Landonowins/weisshorn-nose-cone/report/main.tex

\documentclass[12pt]{article}

% PACKAGE IMPORTS
\usepackage{fancyhdr}
\usepackage[utf8]{inputenc}
\usepackage[T1]{fontenc}
\usepackage[english]{babel}
\usepackage{graphicx}
\usepackage{blindtext}
\usepackage{titlesec}
\usepackage{csquotes}
\usepackage{enumitem}
\usepackage{amsfonts}
\usepackage[font=small,skip=0pt]{caption}
\usepackage{subcaption}
\usepackage{hyperref}
\hypersetup{hidelinks} % no red boxes around links
\usepackage{float}
\usepackage{xcolor}
\usepackage{amsmath,esint}
\usepackage{booktabs}
\usepackage{adjustbox}
\usepackage{calc}
\usepackage{colortbl}
\usepackage{array}
\usepackage{etoolbox}
\usepackage{wrapfig}
\usepackage{ragged2e}
\usepackage{textcomp, gensymb}
\usepackage{pdflscape}
\usepackage{pdfpages}
\usepackage{tikz} % Used for positioning text on title
\usepackage{geometry} % Used for adjusting the margins
\usepackage{lastpage} % Used for adding a page count to the footer
\usepackage[scaled]{helvet} % Helvetica font
\usepackage{soul} % Used for custom letter spacing on title page
\usepackage{eso-pic}
\usepackage[useregional]{datetime2}
\usepackage{longtable}
% added for this report
\usepackage{amssymb}
\usepackage{siunitx}
\sisetup{detect-all}
\usepackage{tabularx}

% SCREENSHOT PATH
\graphicspath{{pictures/template/}{figures/}{../figures/}}

\PassOptionsToPackage{x11names}{xcolor} % Used for adding colors

% FONT SETTINGS
\renewcommand\familydefault{\sfdefault} % Set default font to sans-serif

% DEFINE COLORS
\definecolor{ertred}{RGB}{226,12,24} % Rocket team's red for header and footer lines
\definecolor{issuccess}{RGB}{0,115,10}
\definecolor{isdanger}{RGB}{200,10,10}

% NUMBERS QUOTED IN THE TEXT (generated by scripts/make_tables.py)
\input{sections/macros}

% MARGINS
\geometry{
a4paper,
inner=20mm,
outer=20mm,
top=26mm,
bottom=30mm,
footskip=10mm,
headsep=13mm
}

% TITLE - INTER LETTER SPACING
\sodef\an{}{.1em}{0.1em}{0.1em} % Adjust letter spacing in the title

% FRONT PAGE BACKGROUND IMAGE
\newcommand\BackgroundPic{
\put(0,0){
\parbox[b][\paperheight]{\paperwidth}{
\vfill
\centering
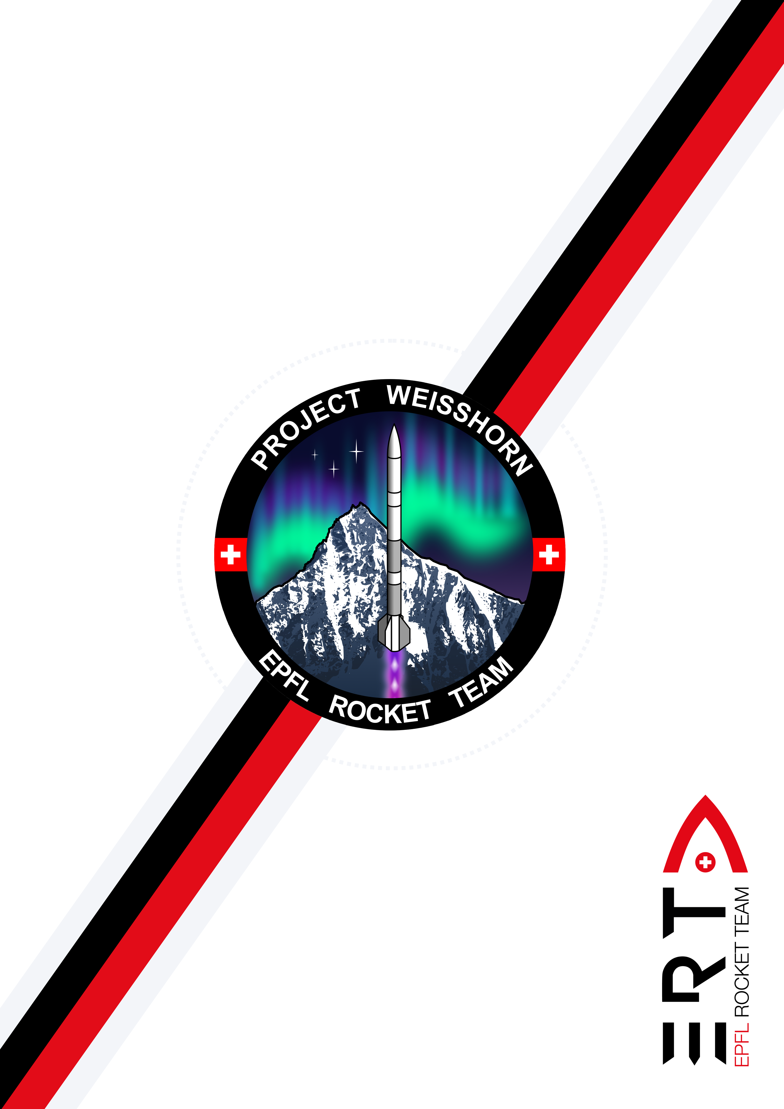
[picture p1: report/pictures/template/c_title-page.png]
 % Background title page image
\vfill
}
}
}

\begin{document}

\AddToShipoutPicture*{\BackgroundPic}
\ClearShipoutPicture

% HEADER AND FOOTER

% HEADER AND FOOTER POSITIONING
\let\oldheadrule\headrule
\renewcommand{\headrule}{\color{ertred}\oldheadrule} % Add color to headrule
\renewcommand{\headrulewidth}{1.5pt}
\renewcommand{\footrule}{\hbox to\headwidth{\color{ertred}\leaders\hrule height \footrulewidth\hfill}}
\renewcommand{\footrulewidth}{1.5pt}
\setlength\headheight{48pt}

% HEADER OPTIONS
\pagestyle{fancy}
\fancyhead[C]{\rule[-2ex]{0pt}{2ex} \bf{ \fontsize{12}{5} \selectfont 2027\_C\_FD\_REPORT-1\_NOSE-CONE}} % Header document name
\lhead{}
\lhead{\vspace{-4mm}} % ERT Logo
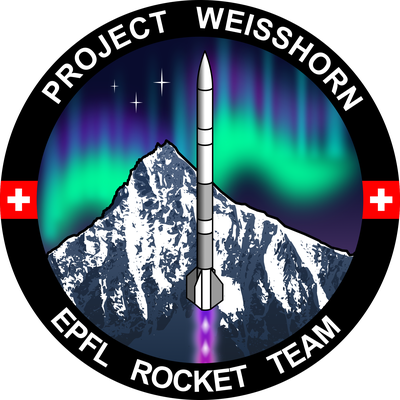
[picture p2: report/pictures/template/c_patch.png]
\rhead{\vspace{-4mm}} % Project Logo

% FOOTER OPTIONS
\cfoot{}
\fancyfoot[R]{\bf{\thepage/\pageref{LastPage}}}
\fancyfoot[L]{\rule[-2ex]{0pt}{2ex}\bf{EPFL ROCKET TEAM}} % Footer Name

% TITLE PAGE
\begin{titlepage}
\vspace*{-2.40cm} % Push title to the top of the page
\noindent
\hspace*{-1.2cm}
\parbox{\linewidth}{%
\bfseries\fontsize{34}{38}\selectfont
REPORT 1 -\\
NOSE CONE ANALYSIS\\
}
\newline
\hspace*{-1.2cm}
\parbox{\linewidth}{%
\bfseries\fontsize{14}{18}\selectfont
Fabio Feig - 315169 \\ % Names and scipers
}

% ADDITIONAL TITLE PAGE DETAILS
\begin{tikzpicture}[remember picture,overlay]
\node[anchor=south east,inner sep=39mm] at (current page.south east) {
\parbox[b][-2.37cm][t]{15cm}{
\raggedleft
\fontsize{12}{12} \selectfont \normalfont \textbf{Weisshorn -- Nose Cone Design Report}
}
};
\end{tikzpicture}

\begin{tikzpicture}[remember picture,overlay]
\node[anchor=south east,inner sep=39mm] at (current page.south east) {
\parbox[b][-0.8cm][t]{15cm}{
\raggedleft
\fontsize{12}{12} \selectfont \normalfont Date: \today % Date
}
};
\end{tikzpicture}

\begin{tikzpicture}[remember picture,overlay]
\node[anchor=south east,inner sep=39mm] at (current page.south east) {
\parbox[b][-1.6cm][t]{15cm}{
\raggedleft
\fontsize{12}{12} \selectfont \normalfont Doc ID: 2027\_C\_FD\_REPORT-1\_NOSE-CONE
}
};
\end{tikzpicture}

\end{titlepage}

% TABLE OF CONTENTS
\pagenumbering{roman} % front matter numbered i, ii so the report body starts at 1
\setcounter{tocdepth}{2} % sections and subsections only
{\small\tableofcontents}
\newpage

% PAGE NUMBERING
\pagenumbering{arabic}
\setcounter{page}{1}

% MAIN CONTENT
\input{sections/01_summary}
\input{sections/01b_nomenclature}
\input{sections/02_inputs}
\input{sections/03_options}
\input{sections/04_methods}
\input{sections/05_results}
\input{sections/05b_catalogue}
\input{sections/06_selection}
\input{sections/06b_recommendations}
\input{sections/07_definition}
\input{sections/08_next}

% APPENDICES
\appendix
\input{sections/09_appendix}

\newpage

\end{document}
