Landonowins/weisshorn-nose-cone/report_650/main.tex

\documentclass[12pt]{article}

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

% SCREENSHOT PATH
\graphicspath{{pictures/template/}{figures/}}

\PassOptionsToPackage{x11names}{xcolor} % Used for adding colors

% FONT SETTINGS
\renewcommand\familydefault{\sfdefault} % Set default font to sans-serif

% DEFINE COLORS
\definecolor{ertred}{RGB}{226,12,24} % Rocket team's red for header and footer lines
\definecolor{issuccess}{RGB}{0,115,10}
\definecolor{isdanger}{RGB}{200,10,10}

% NUMBERS QUOTED IN THE TEXT (generated by studies/total_length.py)
\input{sections/tl_macros}

% MARGINS
\geometry{
a4paper,
inner=20mm,
outer=20mm,
top=26mm,
bottom=30mm,
footskip=10mm,
headsep=13mm
}

% TITLE - INTER LETTER SPACING
\sodef\an{}{.1em}{0.1em}{0.1em} % Adjust letter spacing in the title

% FRONT PAGE BACKGROUND IMAGE
\newcommand\BackgroundPic{
\put(0,0){
\parbox[b][\paperheight]{\paperwidth}{
\vfill
\centering
 % Background title page image
\vfill
}
}
}

\begin{document}

\AddToShipoutPicture*{\BackgroundPic}
\ClearShipoutPicture

% HEADER AND FOOTER

% HEADER AND FOOTER POSITIONING
\let\oldheadrule\headrule
\renewcommand{\headrule}{\color{ertred}\oldheadrule} % Add color to headrule
\renewcommand{\headrulewidth}{1.5pt}
\renewcommand{\footrule}{\hbox to\headwidth{\color{ertred}\leaders\hrule height \footrulewidth\hfill}}
\renewcommand{\footrulewidth}{1.5pt}
\setlength\headheight{48pt}

% HEADER OPTIONS
\pagestyle{fancy}
\fancyhead[C]{\rule[-2ex]{0pt}{2ex} \bf{ \fontsize{12}{5} \selectfont 2026\_C\_FD\_REPORT-2\_NOSE\_CONE}} % Header document name
\lhead{}
\lhead{\vspace{-4mm}} % ERT Logo
\rhead{\vspace{-4mm}} % Project Logo

% FOOTER OPTIONS
\cfoot{}
\fancyfoot[R]{\bf{\thepage/\pageref{LastPage}}}
\fancyfoot[L]{\rule[-2ex]{0pt}{2ex}\bf{EPFL ROCKET TEAM}} % Footer Name

% TITLE PAGE
\begin{titlepage}
\vspace*{-2.40cm} % Push title to the top of the page
\noindent
\hspace*{-1.2cm}
\parbox{\linewidth}{%
\bfseries\fontsize{34}{38}\selectfont
REPORT 2 -\\
NOSE CONE ANALYSIS\\ FOR 650MM LENGTH\\
}
\newline
\hspace*{-1.2cm}
\parbox{\linewidth}{%
\bfseries\fontsize{14}{18}\selectfont
Fabio Feig - 315169 \\ % Names and scipers
}

% ADDITIONAL TITLE PAGE DETAILS
\begin{tikzpicture}[remember picture,overlay]
\node[anchor=south east,inner sep=39mm] at (current page.south east) {
\parbox[b][-2.37cm][t]{15cm}{
\raggedleft
\fontsize{12}{12} \selectfont \normalfont \textbf{Weisshorn -- Nose Cone at 650 mm, with and without the 3U}
}
};
\end{tikzpicture}

\begin{tikzpicture}[remember picture,overlay]
\node[anchor=south east,inner sep=39mm] at (current page.south east) {
\parbox[b][-0.8cm][t]{15cm}{
\raggedleft
\fontsize{12}{12} \selectfont \normalfont Date: \today % Date
}
};
\end{tikzpicture}

\begin{tikzpicture}[remember picture,overlay]
\node[anchor=south east,inner sep=39mm] at (current page.south east) {
\parbox[b][-1.6cm][t]{15cm}{
\raggedleft
\fontsize{12}{12} \selectfont \normalfont Doc ID: 2026\_C\_FD\_REPORT-2\_NOSE\_CONE
}
};
\end{tikzpicture}

\end{titlepage}

% TABLE OF CONTENTS
\pagenumbering{roman} % front matter numbered i, ii so the report body starts at 1
\setcounter{tocdepth}{2} % sections and subsections only
{\small\tableofcontents}
\newpage

% PAGE NUMBERING
\pagenumbering{arabic}
\setcounter{page}{1}

% MAIN CONTENT
\input{sections/01_summary}
\input{sections/02_inputs}
\input{sections/03_method}
\input{sections/04_results}
\input{sections/05_design}

\end{document}
