Landonowins/weisshorn-nose-cone/report/sections/03_options.tex

\section{Design Options}
\label{sec:options}

\subsection{Supersonic flow over a nose and wave drag}
\label{sec:physics}

Above $M = 1$ a disturbance only reaches the downstream cone of half-angle
\begin{equation}
\mu = \arcsin\frac{1}{M}
\label{eq:mach}
\end{equation}
($45.6^\circ$ at $M = 1.4$), so the flow meets the nose through a shock, then expands along it. The
overpressure on the forward-facing surface gives the \emph{wave drag}, $C_{D,\rm w} = D_{\rm w}/(q_\infty
A_b)$ with $A_b = \pi R^2$ (Equation~\eqref{eq:cdw}); it appears around $M \approx 0.8$, peaks near
$M = 1$ and is the only drag component set by the nose shape. A blunt tip detaches the shock into a bow
shock with near-stagnation pressure on the tip, so the tip radius must stay small
(Section~\ref{sec:bluntness}). Slender-body theory gives, within a profile family,
\begin{equation}
C_{D,\rm w} \propto \left(\frac{R}{L}\right)^2 \propto \frac{1}{(L/D)^2} ,
\label{eq:fineness}
\end{equation}
and the minimum-drag shapes: Von K\'arm\'an for a given length and base area, LV-Haack for a given length
and volume. The theory gives trends; the Euler runs of Section~\ref{sec:method} give the values.

\subsection{Candidate profiles}
\label{sec:profiles}

The nose is defined by the \textbf{profile}, the \textbf{fineness} $L/D$ and the \textbf{tip bluntness}
$r_n/R$. Seven profiles are compared (Table~\ref{tab:profiles}, Figure~\ref{fig:schematics}); with
$\xi = x/L$ and $\eta = y/R$: the \textbf{cone}; the \textbf{tangent ogive} (arc of radius
$\rho = (R^2+L^2)/(2R)$); the \textbf{parabola} $K' = 1$; the \textbf{power series} $\eta = \xi^n$
($n = \tfrac12$ is blunt by construction, apex radius $R^2/(2L)$; power noses meet the body with a kink
$\arctan(nR/L)$); and the \textbf{Haack series} $C = 0$ (Von K\'arm\'an) and $C = \tfrac13$ (LV-Haack),
both tangent at the shoulder. The elliptical nose and the secant ogive were discarded before computing.

\begin{figure}[tbp]
\centering

\caption{Schematics of the candidate profiles, drawn at $L/D = 2$ (half the design fineness) so
that their differences are visible; Figure~\ref{fig:gallery} shows them at real proportions.
(a) Notation. (b)--(h) Construction of each profile: the upper label describes the shoulder
(tangent to the body, or a kink of angle $\theta_{\rm sh}$), the lower label the generator and the
tip, and the inset shows the boxed tip region magnified four times.}
\label{fig:schematics}
\end{figure}

\begin{table}[H]
\centering
\caption{Candidate profiles (ogive in dimensional form, $\rho$: arc radius). $x_{cp}$: Barrowman
nose centre of pressure; $\theta_{\rm sh}$: angle to the body at the shoulder (0 = tangent).}
\label{tab:profiles}
\small
\begin{adjustbox}{max width=\textwidth}
\begin{tabular}{@{}lllcc@{}}
\toprule
Profile & $\eta(\xi)$ & ERT vehicles & $x_{cp}/L$ & $\theta_{\rm sh}$ at $L/D=4$ \\
\midrule
Conical & $\xi$ & -- & 0.667 & $7.1^\circ$ \\
Tangent ogive & $\sqrt{\rho^2-(L-x)^2}+R-\rho$, $\rho=\frac{R^2+L^2}{2R}$ & Bella Lui II, Nordend & 0.464 & $0^\circ$ \\
Parabolic ($K'=1$) & $2\xi-\xi^2$ & -- & 0.467 & $0^\circ$ \\
Power series $n=\tfrac12$ & $\xi^{1/2}$ & Wildhorn, Firehorn & 0.500 & $3.6^\circ$ \\
Power series $n=\tfrac34$ & $\xi^{3/4}$ & -- & 0.600 & $5.4^\circ$ \\
LV-Haack ($C=\tfrac13$) & $\pi^{-1/2}\sqrt{\theta-\tfrac12\sin2\theta+C\sin^3\theta}$, $\theta=\arccos(1-2\xi)$ & -- & 0.438 & $0^\circ$ \\
Von K\'arm\'an ($C=0$) & as LV-Haack with $C=0$ & -- & 0.500 & $0^\circ$ \\
\bottomrule
\end{tabular}
\end{adjustbox}
\end{table}

\subsection{Comparison criteria}
\label{sec:criteria}

\begin{itemize}[leftmargin=*,itemsep=2pt]
\item \textbf{Wave drag}: set mostly by $L/D$ and the area added near the tip.
\item \textbf{Payload}: fuller profiles reach $r = \SI{77}{mm}$ further forward; the rest of the 3U needs a
cylindrical extension, which counts against the \SI{5.4}{m} cap.
\item \textbf{Stability}: every nose has $C_{N\alpha} = 2$ at $x_{cp} = L - V/A_b$; a fuller nose moves the
CP forward and lowers the static margin $(x_{cp} - x_{cg})/D$.
\item \textbf{Manufacture}: a tangent shoulder avoids a kink at the coupler bond; every option uses a
separate machined tip.
\end{itemize}
