Landonowins/weisshorn-nose-cone/report/sections/07_definition.tex

\section{Design Definition}
\label{sec:definition}

\begin{figure}[H]
\centering

\caption{Selected nose cone to scale: Von K\'arm\'an profile, $L/D = 4.5$, \SI{4.5}{mm} spherical
tip, \SI{60}{mm} shoulder; dashed: 3U CubeSat envelope.}
\label{fig:final}
\end{figure}

\begin{table}[H]
\centering
\caption{Nose cone definition (outer mould line and performance).}
\label{tab:final}
\small
\begin{tabular}{@{}>{\raggedright\arraybackslash}p{5.4cm}>{\raggedright\arraybackslash}p{10.1cm}@{}}
\toprule
Profile & Von K\'arm\'an (Haack series, $C = 0$):
$y = \dfrac{R}{\sqrt\pi}\sqrt{\theta-\tfrac12\sin 2\theta}$, $\theta=\arccos\!\left(1-\dfrac{2x}{L}\right)$ \\
Base diameter $D = 2R$ & \SI{180}{mm} \\
Profile length $L$ (to the theoretical apex) & \FINL{} ($L/D = 4.5$) \\
Tip & sphere $r_n = \SI{4.5}{mm}$, tangent at $x = $ \FINXT{}; apex truncated by \FINTRUNC{} \\
Physical curved length (tip to shoulder) & \FINLPHYS{} \\
Shoulder & \SI{60}{mm} cylinder (coupler) \\
Angle to the body at the shoulder & $0^\circ$ (tangent) \\
Internal volume / wetted area & \FINVOL{} / \FINAREA{} \\
Nose CP (Barrowman, from the apex) & \FINXCP{}, $C_{N\alpha} = 2$ \\
3U inside the curved part & \FINTHREEU{}; the remaining \FINCYL{} of the 3U sits behind the shoulder \\
Nose wave drag $C_{D,\rm w}$ at $M = 1.2/1.4/1.6$ & \FINCDB{} / \FINCDC{} / \FINCDD{} (Euler at $L/D=4.5$, sharp apex; $+0.5$ to $+1.4\,\%$ with the tip) \\
Apogee (nominal, model) & \FINAPO{}, i.e.\ \FINDAPO{} vs.\ the LVS-length baseline; $M_{\max} = \FINMMAX$ \\
Static margin change vs.\ baseline & \FINDSM{} cal \\
\bottomrule
\end{tabular}
\end{table}

A radius tolerance of $\pm\SI{0.5}{mm}$ moves $C_{D,\rm w}$ by much less than 1\,\%; a step at the
tip/shell joint matters more (a forward-facing step acts as a small blunt face): keep it below
\SI{0.2}{mm}, and forward-facing steps at zero.

\subsection{CAD deliverables}

{\sloppy Profile coordinates (\texttt{nose\_profile\_final.csv}, 200 points, $x$ from the tip),
watertight STL solids (mm) of the seven candidates at $L/D = 4.5$, and STL and STEP solids of the final
design, \texttt{nose\_vonkarman\_LD4.5\_rn4.5mm\_FINAL.stl} and \texttt{.step}, for CAD and Fluent
(Appendix~\ref{app:scripts}).\par}
