Landonowins/weisshorn-nose-cone/report/sections/08_next.tex

\section{Open Points and Next Steps}
\label{sec:next}

\begin{enumerate}[leftmargin=*,itemsep=3pt]
\item \textbf{Fluent verification (R3).} RANS (k-$\omega$ SST) at $M = 0.95$, 1.2 and 1.47 plus the
$5^\circ$ incidence case, to replace the transonic model of Section~\ref{sec:transonic}; workflow in
2027\_C\_FD\_REPORT-4\_NOSE-CONE-FLUENT-WORKFLOW (\texttt{CFD/} of the repository).
\item \textbf{RocketPy update.} Final geometry and $C_D(M)$ in the RocketPy model; re-check apogee, the
\SI{30}{m/s} rail exit speed and the 2--4 cal static margin (2027\_C\_SE\_\allowbreak FD\_REQ\_07) once
the fins are defined.
\item \textbf{Requirements to create}: profile Von K\'arm\'an, $L = \FINL{}$ (\FINLPHYS{} physical),
coordinates from \texttt{nose\_profile\_final.csv}, radius tolerance $\pm\SI{0.5}{mm}$; nosecone bay
\FINBAY{} in the \SI{5.4}{m} budget (2027\_C\_SE\_REQ\_04); spherical tip \SI{4.5}{mm}.
\end{enumerate}
