Landonowins/weisshorn-nose-cone/report_650/sections/tab_tl_cfd.tex

\begin{tabular}{@{}llrrrrr@{}}
\toprule
Profile & $L/D$ & $M=1.1$ & $M=1.2$ & $M=1.4$ & $M=1.6$ & report-1 model at $M=1.4$ \\
\midrule
Von K\'arm\'an & 2.5 & 0.1156 & 0.1212 & 0.1190 & 0.1155 & $+$5.7\,\% \\
Von K\'arm\'an & 3.5 & 0.0680 & 0.0686 & 0.0667 & 0.0648 & $-$0.4\,\% \\
LV-Haack & 2.5 & 0.1147 & 0.1302 & 0.1356 & 0.1347 & $+$7.1\,\% \\
LV-Haack & 3.5 & 0.0714 & 0.0767 & 0.0776 & 0.0766 & $-$0.6\,\% \\
Power $\tfrac12$ & 2.5 & 0.1052 & 0.1100 & 0.1122 & 0.1119 & $+$9.8\,\% \\
Power $\tfrac12$ & 3.5 & 0.0641 & 0.0665 & 0.0677 & 0.0675 & $-$0.5\,\% \\
\bottomrule
\end{tabular}
