Landonowins/weisshorn-nose-cone/report_650/sections/tab_tl_designs.tex

\begin{tabular}{@{}llrrrrrrr@{}}
\toprule
Study & Profile & $c$ & $L$ & $L/D$ & 3U in $L$ & $p$ & Apogee & vs \SI{9}{km} \\
 & & [mm] & [mm] & & [mm] & [mm] & [m] & [m] \\
\midrule
A: 3U in the nose & Von K\'arm\'an & 155 & 495 & 2.75 & 155 & 0 & 8647 & $-$353 \\
 & \textbf{LV-Haack} & 89 & 561 & 3.12 & 222 & $-$1 & \textbf{8703} & \textbf{$-$297} \\
 & Power $\tfrac12$ & 186 & 464 & 2.58 & 124 & 0 & 8621 & $-$379 \\
\midrule
B: 3U not in the nose & \textbf{Von K\'arm\'an} & 20 & 630 & 3.50 & 197 & 93 & \textbf{8905} & \textbf{$-$95} \\
 & LV-Haack & 20 & 630 & 3.50 & 249 & 41 & 8836 & $-$164 \\
 & \textbf{Power $\tfrac12$} & 20 & 630 & 3.50 & 169 & 121 & \textbf{8911} & \textbf{$-$89} \\
\bottomrule
\end{tabular}
