Landonowins/weisshorn-nose-cone/report_650/sections/tab_tl_loads.tex

\begin{tabular}{@{}lrr@{}}
\toprule
Quantity & A: LV-Haack & B: Von K\'arm\'an \\
\midrule
Nose mass in the load case (Req\_04 limit + payload) [kg] & 5.74 & 1.75 \\
Maximum dynamic pressure $q_{\max}$ [kPa] & 130 & 132 \\
Nose drag at its maximum [N] & 389 & 291 \\
Joint compression at lift-off [N] & 344 & 105 \\
Joint compression, maximum (limit) [N] & 796 & 418 \\
\quad of which nose drag [N] & 388 & 290 \\
\quad time of the maximum [s] & 9.1 & 9.1 \\
\quad ultimate ($\times2$) vs Req\_06 (\SI{300}{N}) [N] & 1593 & 836 \\
Traction, Req\_07 rationale (20\,$g$, $\times2$) vs \SI{2000}{N} [N] & 2252 & 686 \\
Nose CP to the joint plane [mm] & 405 & 335 \\
Bending at the joint per degree at $q_{\max}$ (limit) [N\,m/$^\circ$] & 46.6 & 39.2 \\
Incidence at which Req\_12 (\SI{200}{N.m} ultimate) is reached [$^\circ$] & 2.1 & 2.5 \\
\bottomrule
\end{tabular}
