Landonowins/weisshorn-nose-cone/report_650/sections/tab_tl_thermal.tex

\begin{tabular}{@{}lrr@{}}
\toprule
Peak temperature [\si{\celsius}], nominal / envelope & A: LV-Haack & B: Von K\'arm\'an \\
\midrule
Stagnation temperature $T_0$ & 117 / 153 & 119 / 155 \\
Al 6082 tip insert & 60 / 84 & 55 / 77 \\
Shell inner face, \SI{50}{mm} from the tip & 76 / 102 & 77 / 104 \\
Shell inner face, mid-length & 71 / 96 & 72 / 97 \\
Shell inner face at the coupler (bond) & 69 / 93 & 69 / 95 \\
\bottomrule
\end{tabular}
