Landonowins/weisshorn-nose-cone/report/_backup_before_explanations/sections/06b_recommendations.tex

\section{Recommendations}
\label{sec:recommendations}

\subsection{Recommended design}

\noindent\fbox{\parbox{\dimexpr\textwidth-2\fboxsep-2\fboxrule}{%
\textbf{Von K\'arm\'an nose cone, $L = \SI{810}{mm}$ ($L/D = 4.5$), $D = \SI{180}{mm}$, tangent
\SI{60}{mm} shoulder, \SI{4.5}{mm} spherical Al 6082-T6 tip insert, CFRP $[0/45/0]_{SO}$ shell
(\SI{1.2}{mm}).}\\[3pt]
Predicted: $C_{D,\rm w} = \FINCDC$ at $M = 1.4$ (lowest of seven profiles at every computed Mach
number); \FINDAPO{} of apogee against the LVS-length baseline; \FINMASS{} for shell and tip;
\FINTHREEU{} of the 3U inside the curved part; tip below \TIPAL{} and shell inner face below
\SHELLENV{} on a \SI{30}{\celsius} day.}}

\subsection{Numbered recommendations}

\begin{table}[H]
\centering
\caption{Recommendations, owners and timing.}
\label{tab:reco}
\small
\begin{tabular}{@{}>{\raggedright\arraybackslash}p{0.8cm}>{\raggedright\arraybackslash}p{10.6cm}>{\raggedright\arraybackslash}p{2.2cm}>{\raggedright\arraybackslash}p{1.6cm}@{}}
\toprule
\# & Recommendation & Owner & When \\
\midrule
R1 & Adopt the Von K\'arm\'an profile (Haack $C=0$). Use \texttt{nose\_profile\_final.csv} or the STL
in \texttt{results/cad/} as the master geometry. & FD $\rightarrow$ ST & PDR \\
R2 & Book a \SI{907}{mm} nose bay (\SI{810}{mm} curved + \SI{97}{mm} cylinder for the 3U, of which
\SI{60}{mm} is the coupler shoulder) in the \SI{5.4}{m} LV budget. If it does not fit, keep the same
profile at $L = \SI{720}{mm}$ ($-\SI{60}{m}$, bay \SI{845}{mm}). & SE & PDR \\
R3 & Use a machined Al 6082-T6 tip insert ($r_n = \SI{4.5}{mm}$, $\sim$\SI{80}{mm} long,
$\sim$\SI{60}{g}), threaded onto a ring bonded inside the shell. Do not fly a printed PET-CF tip:
it would exceed its heat-deflection range by \SIrange{25}{70}{\celsius}. & ST & CDR \\
R4 & Lay up the shell in CFRP prepreg $[0/45/0]_{SO}$, \SI{1.2}{mm}, on a male PET-CF mould printed
in 2--3 segments, with the joints in the aft half (low curvature). Use GFRP instead if the nose
has to be the RF window. & ST (AV, PL) & CDR \\
R5 & Raise the thermal requirement to \SI{430}{K} for \SI{10}{s} and qualify the shoulder bond: the
DP490 joint at the shoulder sees about \SI{95}{\celsius} in the envelope case. Consider a higher-$T_g$ adhesive if
the test margin is small. & SE, ST & CDR \\
R6 & Verify with Fluent (RANS, k-$\omega$ SST) at $M = 0.95$, 1.2 and 1.47 for the selected nose and
the power-$\tfrac12$ alternative, plus one $5^\circ$ incidence case for $C_{N\alpha}$ and CP. This
replaces the transonic model of this report. & FD-CFD & before CDR \\
R7 & Put the final geometry and $C_{D,\rm w}(M)$ into the RocketPy model. Re-check apogee, rail-exit
speed and the 2--4 cal static margin once the fins are designed. The nose contributes
$C_{N\alpha} = 2$ at \FINXCP{} from the tip. & FD-Sim & PDR \\
R8 & Size the payload structure around a 3U envelope whose front face is \FINTHREEU{} ahead of the
shoulder, inside the $r \leq \SI{77}{mm}$ contour (Figure~\ref{fig:final}). & PL, ST & CDR \\
R9 & Create the missing Weisshorn nosecone requirements: geometry, bay length, mass
($\leq\SI{500}{g}$ for the nose structure, Table~\ref{tab:mass}), thermal and tip
(Section~\ref{sec:next}). & SE & PDR \\
R10 & Keep the Firehorn power-$\tfrac12$ profile as the documented alternative. It costs
\SI{22}{m} of apogee and adds a $3.2^\circ$ shoulder kink, but its tooling and process already exist. & FD & -- \\
\bottomrule
\end{tabular}
\end{table}

\subsection{When to choose another design}

The recommendation assumes the current Weisshorn priorities: apogee margin, a 3U payload in the
nose bay, and a length cap. If those priorities change, Table~\ref{tab:alternatives} gives the
design to use instead.

\begin{table}[H]
\centering
\caption{Choice of nose cone if the priorities change.}
\label{tab:alternatives}
\small
\begin{tabular}{@{}>{\raggedright\arraybackslash}p{6.3cm}>{\raggedright\arraybackslash}p{3.6cm}>{\raggedright\arraybackslash}p{5.3cm}@{}}
\toprule
If \dots & choose & cost relative to the recommendation \\
\midrule
the LV cannot grow beyond the LVS length & Von K\'arm\'an, \SI{720}{mm} & $-\SI{60}{m}$ apogee \\
schedule favours reusing Firehorn tooling & Power $\tfrac12$, \SI{810}{mm} & $-\SI{22}{m}$, $3.2^\circ$ kink, bay $+\SI{36}{mm}$ \\
the payload grows (more volume in the nose) & LV-Haack, \SI{810}{mm} & $-\SI{69}{m}$, bay $-\SI{37}{mm}$, $+\SI{22}{g}$ \\
the nose must be as short as possible ($L/D \leq 3.5$) & Power $\tfrac12$ & lowest drag at short length \\
the vehicle becomes faster ($M_{\max} \approx 2$) and the payload leaves the nose & Power $\tfrac34$ or Von K\'arm\'an at $L/D \geq 5$ & re-run the study \\
a subsonic test vehicle (e.g.\ Aletsch) & Tangent ogive or Von K\'arm\'an & shape barely matters below $M = 0.8$ \\
\bottomrule
\end{tabular}
\end{table}

\subsection{What not to do}

\begin{itemize}[leftmargin=*,itemsep=2pt]
\item \textbf{Do not use a cone or a tangent ogive} for a supersonic Weisshorn. They lose
\SIrange{79}{132}{m} at the same length, and both this study and the literature rate them worst in
the transonic and low supersonic range.
\item \textbf{Do not use a printed thermoplastic tip.} Its surface follows the stagnation temperature,
which reaches \SI{156}{\celsius} on a hot day.
\item \textbf{Do not size the nose by fineness alone.} A longer nose pays only if the extra length
also houses payload. Measure it as nose-bay length, which is what the \SI{5.4}{m} cap actually
constrains.
\end{itemize}
