Landonowins/weisshorn-nose-cone/report/_backup_before_explanations/sections/tab_matrix.tex

\begin{table}[H]
\centering
\caption{Trade-off matrix at $L/D = 4.5$ (1 = worst, 5 = best). Performance: apogee at equal length (Table~\ref{tab:trade}). Integration: 3U length inside the curved part. Manufacture: tangent shoulder, mould and tip. Heritage: flown or built at ERT. Stability: change in static margin.}
\label{tab:matrix}
\small
\begin{adjustbox}{max width=\textwidth}
\begin{tabular}{@{}lccccccc@{}}
\toprule
Criterion (weight) & Cone & Ogive & Parab. & Power $\tfrac12$ & Power $\tfrac34$ & LV-Haack & Von K\'arm\'an \\
\midrule
Performance (0.40) & 1.0 & 2.6 & 2.6 & 4.3 & 4.4 & 2.9 & 5.0 \\
Integration, 3U fit (0.20) & 1.0 & 4.8 & 4.8 & 3.0 & 1.7 & 5.0 & 3.7 \\
Manufacture (0.20) & 3.0 & 5.0 & 5.0 & 3.0 & 2.0 & 5.0 & 5.0 \\
Heritage (0.10) & 1.0 & 4.0 & 2.0 & 5.0 & 1.0 & 1.0 & 2.0 \\
Stability (0.10) & 5.0 & 1.4 & 1.5 & 2.2 & 3.9 & 1.0 & 2.1 \\
\midrule
\textbf{Weighted total} & 1.80 & 3.54 & 3.36 & 3.64 & 3.00 & 3.37 & \textbf{4.15} \\
\bottomrule
\end{tabular}
\end{adjustbox}
\end{table}
