Landonowins/weisshorn-nose-cone/report/_backup_before_explanations/sections/tab_trade.tex

\begin{table}[H]
\centering
\caption{Candidates at $L/D=4$ (LVS length, \SI{720}{mm}) and $L/D=4.5$ (\SI{810}{mm}). $\Delta z$: apogee change vs.\ the baseline (Von K\'arm\'an, $L/D=4$); mass: shell + Al tip; 3U in nose: curved length with $r\geq\SI{77}{mm}$; bay: curved length plus the cylinder the 3U still needs.}
\label{tab:trade}
\small
\begin{adjustbox}{max width=\textwidth}
\begin{tabular}{@{}llcccccccc@{}}
\toprule
$L/D$ & Profile & \multicolumn{3}{c}{$C_{D,\rm w}$ at $M=$} & $\Delta z$ & mass & 3U in nose & bay & $\Delta$SM \\
 & & 1.1 & 1.2 & 1.4 & [m] & [g] & [mm] & [mm] & [cal] \\
\midrule
4 & Cone & 0.0982 & 0.0862 & 0.0750 & -195 & 261 & 104 & 966 & +0.11 \\
4 & Tangent ogive & 0.0651 & 0.0657 & 0.0640 & -93 & 328 & 275 & 795 & -0.03 \\
4 & Parabolic & 0.0656 & 0.0656 & 0.0639 & -92 & 328 & 274 & 797 & -0.03 \\
4 & Power $n=\tfrac12$ & 0.0523 & 0.0541 & 0.0550 & -8 & 328 & 193 & 878 & +0.00 \\
4 & Power $n=\tfrac34$ & 0.0628 & 0.0628 & 0.0564 & -26 & 289 & 135 & 935 & +0.07 \\
4 & LV-Haack & 0.0610 & 0.0610 & 0.0613 & -75 & 341 & 284 & 786 & -0.04 \\
4 & \textbf{Von K\'arm\'an} & 0.0541 & 0.0541 & 0.0526 & +0 & 321 & 226 & 845 & +0.00 \\
\midrule
4.5 & Cone & 0.0708 & 0.0708 & 0.0619 & -72 & 286 & 117 & 1043 & +0.09 \\
4.5 & Tangent ogive & 0.0530 & 0.0530 & 0.0516 & -19 & 361 & 309 & 870 & -0.07 \\
4.5 & Parabolic & 0.0529 & 0.0529 & 0.0515 & -18 & 361 & 308 & 870 & -0.06 \\
4.5 & Power $n=\tfrac12$ & 0.0450 & 0.0450 & 0.0457 & +38 & 361 & 217 & 943 & -0.03 \\
4.5 & Power $n=\tfrac34$ & 0.0513 & 0.0513 & 0.0463 & +42 & 318 & 152 & 1008 & +0.04 \\
4.5 & LV-Haack & 0.0496 & 0.0496 & 0.0497 & -9 & 376 & 320 & 870 & -0.08 \\
4.5 & \textbf{Von K\'arm\'an} & 0.0437 & 0.0437 & 0.0425 & +60 & 354 & 254 & 907 & -0.04 \\
\bottomrule
\end{tabular}
\end{adjustbox}
\end{table}
