Landonowins/weisshorn-nose-cone/CFD/source/main.tex

\documentclass[11pt]{article}

% PACKAGE IMPORTS
\usepackage{fancyhdr}
\usepackage[utf8]{inputenc}
\usepackage[T1]{fontenc}
\usepackage[english]{babel}
\usepackage{graphicx}
\usepackage{enumitem}
\usepackage{xcolor}
\usepackage{amsmath,amssymb}
\usepackage{booktabs}
\usepackage{tabularx}
\usepackage{array}
\usepackage{float}
\usepackage[font=small,skip=4pt]{caption}
\usepackage{subcaption}
\usepackage{geometry}
\usepackage{lastpage}
\usepackage[scaled]{helvet}
\usepackage{siunitx}
\sisetup{detect-all}
\PassOptionsToPackage{obeyspaces,spaces}{url}
\usepackage{hyperref}
\hypersetup{hidelinks}
\usepackage{url}
\usepackage{tikz} % Used for positioning text on title
\usepackage{eso-pic}
\usepackage[useregional]{datetime2}

% FIGURES: generated plots and screenshots in figures/, Fluent pictures of the runs in ../studyA/plots/
\graphicspath{{pictures/template/}{figures/}{../studyA/plots/}}

% FONT SETTINGS
\renewcommand\familydefault{\sfdefault}

% COLORS
\definecolor{ertred}{RGB}{226,12,24}

% MARGINS
\geometry{
a4paper,
inner=20mm,
outer=20mm,
top=26mm,
bottom=30mm,
footskip=10mm,
headsep=13mm
}

% LISTS, PATHS AND GUI NAMES
\setlength{\emergencystretch}{2em} % long paths and GUI names: stretch spaces rather than overflow
\setlist{itemsep=2pt,topsep=3pt}
\setlist[enumerate,1]{leftmargin=*}
\setlist[itemize]{leftmargin=*}
\urlstyle{tt}
\newcommand{\file}[1]{\path{#1}}
\newcommand{\zone}[1]{\texttt{#1}}              % Fluent zone / named selection
\newcommand{\gui}[1]{\textbf{#1}}               % menu, panel or field of the Ansys GUI
\newcommand{\then}{\,$\rightarrow$\,}           % menu path separator
\newcommand{\checkstep}[1]{\par\smallskip\noindent\textbf{Check.} #1\par\smallskip}

% PICTURE STILL TO COME FROM THE ANSYS SESSION: shown if figures/<name>.png exists, else a placeholder box
\newcommand{\shot}[3][\linewidth]{%
\IfFileExists{figures/#2.png}{}{%
\fbox{\parbox[c][3cm][c]{\dimexpr#1-2\fboxsep-2\fboxrule\relax}{\centering\small
\texttt{\detokenize{#2}.png} to come\\[2pt] #3}}}}

% FRONT PAGE BACKGROUND IMAGE
\newcommand\BackgroundPic{
\put(0,0){
\parbox[b][\paperheight]{\paperwidth}{
\vfill
\centering
 % Background title page image
\vfill
}
}
}

\begin{document}

\AddToShipoutPicture*{\BackgroundPic}
\ClearShipoutPicture

% HEADER AND FOOTER
\let\oldheadrule\headrule
\renewcommand{\headrule}{\color{ertred}\oldheadrule}
\renewcommand{\headrulewidth}{1.5pt}
\renewcommand{\footrule}{\hbox to\headwidth{\color{ertred}\leaders\hrule height \footrulewidth\hfill}}
\renewcommand{\footrulewidth}{1.5pt}
\setlength\headheight{48pt}

\pagestyle{fancy}
\fancyhead[C]{\rule[-2ex]{0pt}{2ex} \bf{\fontsize{12}{5}\selectfont 2027\_C\_FD\_REPORT-4\_NOSE-CONE-FLUENT-WORKFLOW}}
\lhead{\vspace{-4mm}}
\rhead{\vspace{-4mm}}
\cfoot{}
\fancyfoot[R]{\bf{\thepage/\pageref{LastPage}}}
\fancyfoot[L]{\rule[-2ex]{0pt}{2ex}\bf{EPFL ROCKET TEAM}}

% TITLE PAGE
\begin{titlepage}
\vspace*{-2.40cm} % Push title to the top of the page
\noindent
\hspace*{-1.2cm}
\parbox{\linewidth}{%
\bfseries\fontsize{34}{38}\selectfont
REPORT 4 -\\
NOSE CONE CFD\\
IN ANSYS FLUENT\\
}
\newline
\hspace*{-1.2cm}
\parbox{\linewidth}{%
\bfseries\fontsize{14}{18}\selectfont
Fabio Feig - 315169 \\ % Names and scipers
}

% ADDITIONAL TITLE PAGE DETAILS
\begin{tikzpicture}[remember picture,overlay]
\node[anchor=south east,inner sep=39mm] at (current page.south east) {
\parbox[b][-2.37cm][t]{15cm}{
\raggedleft
\fontsize{12}{12} \selectfont \normalfont \textbf{Weisshorn -- Nose Cone CFD: Workflow and Study A}
}
};
\end{tikzpicture}

\begin{tikzpicture}[remember picture,overlay]
\node[anchor=south east,inner sep=39mm] at (current page.south east) {
\parbox[b][-1.6cm][t]{15cm}{
\raggedleft
\fontsize{12}{12} \selectfont \normalfont Doc ID: 2027\_C\_FD\_REPORT-4\_NOSE-CONE-FLUENT-WORKFLOW
}
};
\end{tikzpicture}

\begin{tikzpicture}[remember picture,overlay]
\node[anchor=south east,inner sep=39mm] at (current page.south east) {
\parbox[b][-0.8cm][t]{15cm}{
\raggedleft
\fontsize{12}{12} \selectfont \normalfont Date: \today % Date
}
};
\end{tikzpicture}

\end{titlepage}

% TABLE OF CONTENTS
\pagenumbering{roman} % front matter numbered i, ii so the report body starts at 1
\setcounter{tocdepth}{2} % sections and subsections only
{\small\tableofcontents}
\newpage

% PAGE NUMBERING
\pagenumbering{arabic}
\setcounter{page}{1}

% MAIN CONTENT
\input{sections/01_summary}
\input{sections/02_case}
\input{sections/03_geometry}
\input{sections/04_mesh}
\input{sections/05_physics}
\input{sections/06_solver}
\input{sections/07_runs}
\input{sections/08_results}
\input{sections/09_python}
\input{sections/10_conclusions}

\clearpage
\appendix
\input{sections/B_files}
\input{sections/C_claude_vm}

\end{document}
