Landonowins/weisshorn-nose-cone/report_650/figures/fig_tl_total.pdf

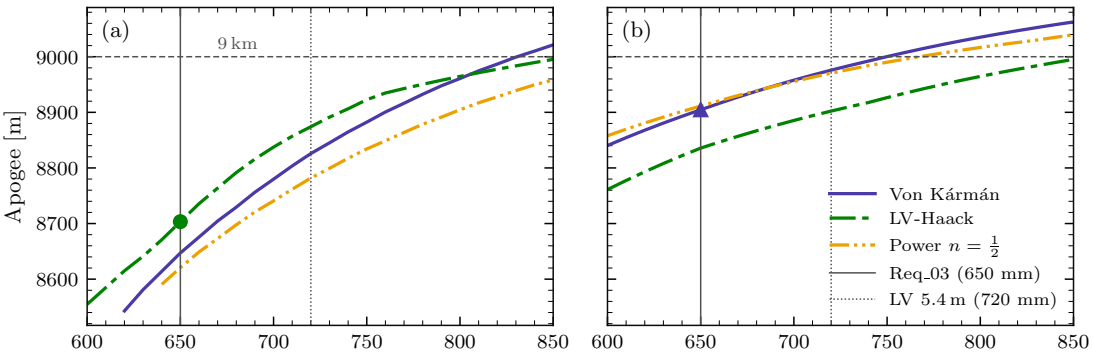
[picture p46: figure]
Apogee [m]; Von K´arm´an LV-Haack Power n = 1 2 Req 03 (650 mm) LV 5.4 m (720 mm)

Total nose length L + c [mm]

Study A: 3U in the nose

Total nose length L + c [mm]

Study B: 3U not in the nose
