Landonowins/weisshorn-nose-cone/report/figures/fig_gallery.pdf

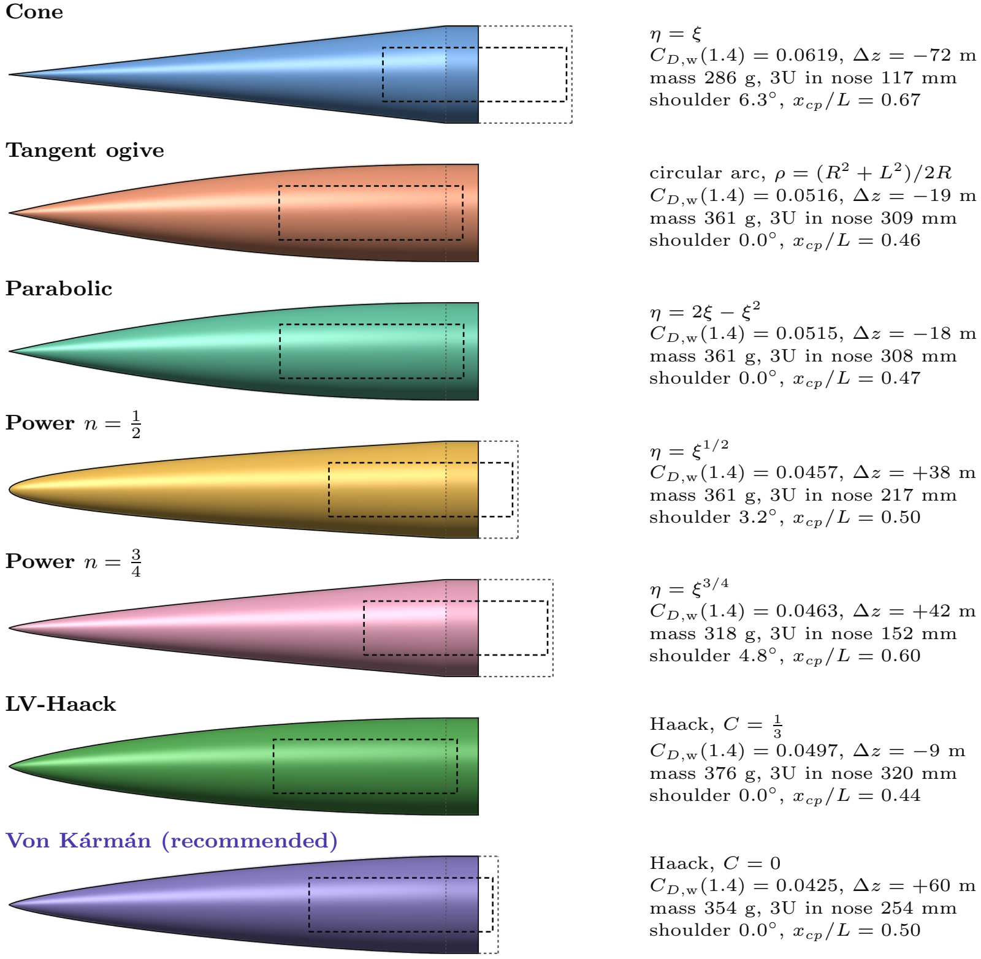
[picture p47: page 1]

Cone
η

=

ξ

CD,

w(1

.4) = 0

.0619, ∆

z

=

−72 m
mass 286 g, 3U in nose 117 mm shoulder 6

3

◦
,

xcp/L = 0

.67

Tangent ogive
circular arc,

ρ = (

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
.4) = 0

.0516, ∆

z

=

−19 m
mass 361 g, 3U in nose 309 mm shoulder 0

0

◦
,

xcp/L = 0

.46

Parabolic
η = 2

ξ

−
ξ

2

CD,

w(1

.4) = 0

.0515, ∆

z

=

−18 m
mass 361 g, 3U in nose 308 mm shoulder 0

0

◦
,

xcp/L = 0

.47

Power

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
.4) = 0

.0457, ∆

z = +38 m
mass 361 g, 3U in nose 217 mm shoulder 3

2

◦
,

xcp/L = 0

.50

Power

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
.4) = 0

.0463, ∆

z = +42 m
mass 318 g, 3U in nose 152 mm shoulder 4

8

◦
,

xcp/L = 0

.60

LV-Haack
Haack,

C

=

13

CD,

w(1

.4) = 0

.0497, ∆

z

=

−9 m
mass 376 g, 3U in nose 320 mm shoulder 0

0

◦
,

xcp/L = 0

.44

Von K´arm´an (recommended) Haack,

C = 0

CD,

w(1

.4) = 0

.0425, ∆

z = +60 m
mass 354 g, 3U in nose 254 mm shoulder 0

0

◦
,

xcp/L = 0

.50
