Landonowins/weisshorn-nose-cone/report/figures/fig_schematics.pdf

### (a) Notation

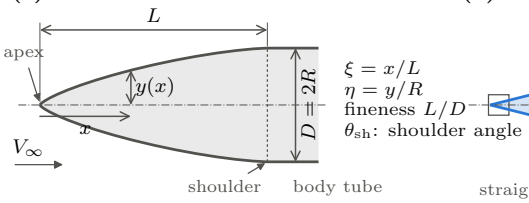
[picture p48: figure]
apex; shoulder; body tube; ξ = x/L η = y/R fineness L/D θsh: shoulder angle
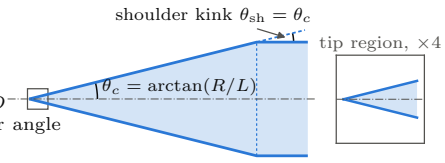
[picture p49: figure]
θc = arctan(R/L); shoulder kink θsh = θc; tip region, ×4

straight generator, sharp tip; simplest mould

### (b) Conical: η = ξ

tangent to the body at the shoulder

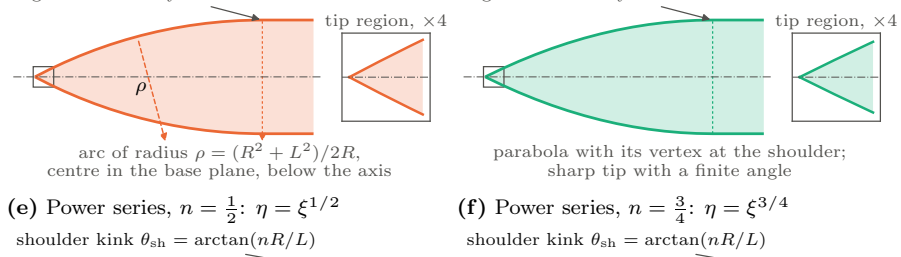
[picture p50: figure]
arc of radius ρ = (R; tip region, ×4; sharp tip with a finite angle; shoulder kink θsh = arctan(nR/L); (e) Power series, n = 1 2; (f) Power series, n = 3 4

centre in the base plane, below the axis

### (c) Tangent ogive: circular arc

tangent to the body at the shoulder

parabola with its vertex at the shoulder;

### (d) Parabolic (K0 = 1): η = 2ξ − ξ

2

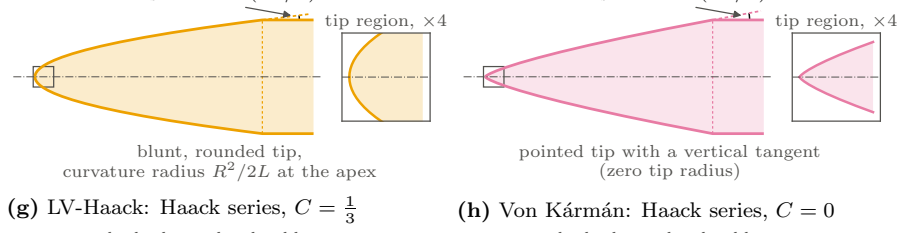
[picture p51: figure]
blunt, rounded tip, curvature radius R; 2/2L at the apex; tip region, ×4; pointed tip with a vertical tangent (zero tip radius); (g) LV-Haack: Haack series, C = 1 3; (h) Von K´arm´an: Haack series, C = 0

tangent to the body at the shoulder

least wave drag for given L and volume; the fullest of the seven shapes tangent to the body at the shoulder

least wave drag for given L and base area; pointed tip with a vertical tangent
