Landonowins/weisshorn-nose-cone/report/figures/fig_trajectory.pdf

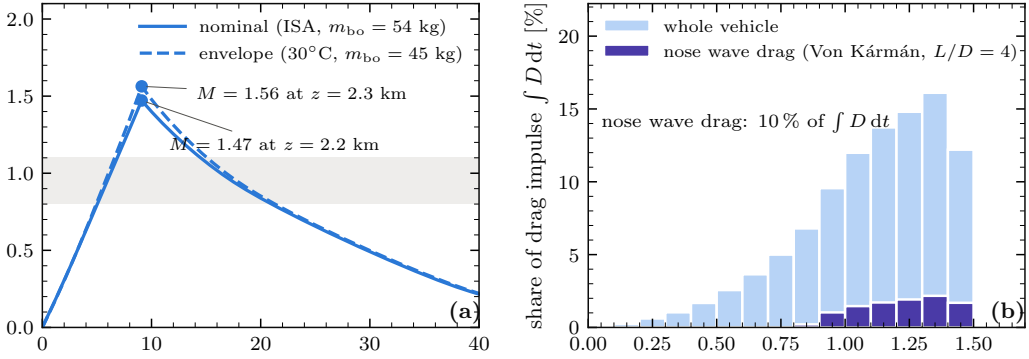
[picture p52: figure]
nominal (ISA, mbo = 54 kg) envelope (30◦C, mbo = 45 kg); share of drag impulse; nose wave drag: 10 % of R; whole vehicle nose wave drag (Von K´arm´an, L/D = 4)

t [s]

M

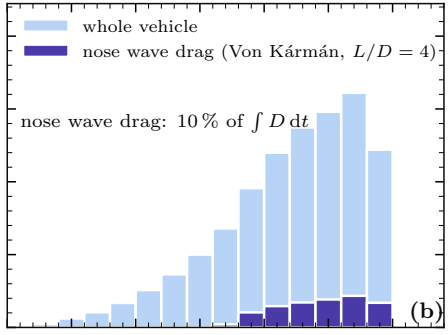
[picture p53: figure]

M
