Landonowins/weisshorn-nose-cone/CFD/source/figures/fig_cd_mach.pdf

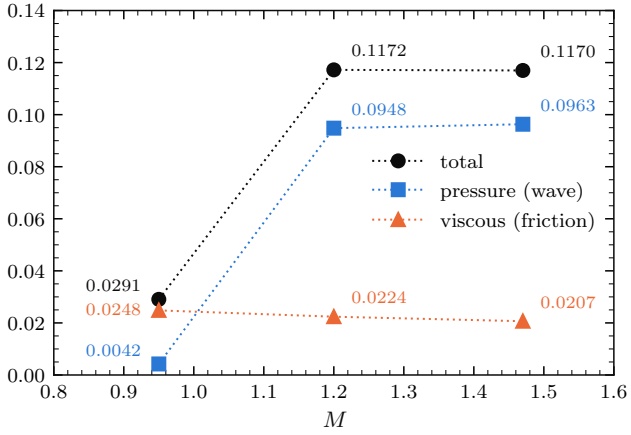
[picture p54: figure]
total pressure (wave) viscous (friction)

## CD of the nose (Aref = πD2/4)
