Landonowins/weisshorn-nose-cone/CFD/source/figures/fig_python_compare.pdf

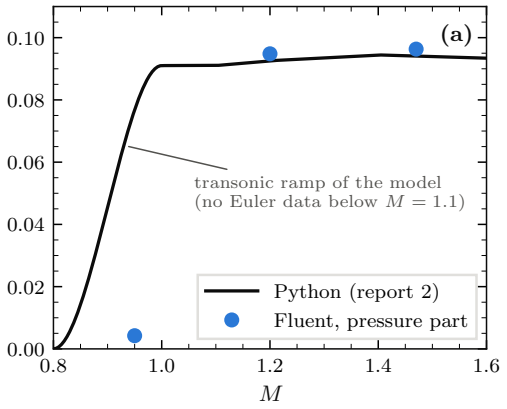
[picture p55: figure]
transonic ramp of the model (no Euler data below; Python (report 2) Fluent, pressure part

pressure (wave) CD of the nose

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
.000

0

.005

0

.010

0

.015

0

.020

0

.025

0

.030

0

.035

0

.040
friction (viscous) CD of the nose
(b)

Python flat plate, smooth
Python flat plate, 20

µm rough
Fluent, viscous part
