Landonowins/weisshorn-nose-cone/report/_backup_before_explanations/sections/tab_catalogue.tex

\begin{table}[H]
\centering
\caption{Design catalogue at $L/D = 4.5$ ($L = \SI{810}{mm}$). Wave drag from the direct Euler runs at this fineness; $\Delta z$ relative to Von K\'arm\'an at $L/D=4$ (LVS length), including length and mass effects.}
\label{tab:catalogue}
\small
\begin{adjustbox}{max width=\textwidth}
\begin{tabular}{@{}lccccccc@{}}
\toprule
 & Cone & Ogive & Parabolic & Power $\tfrac12$ & Power $\tfrac34$ & LV-Haack & Von K\'arm\'an \\
\midrule
Volume [L] & 6.87 & 11.03 & 10.99 & 10.31 & 8.24 & 11.59 & 10.31 \\
Wetted area [m$^2$] & 0.230 & 0.308 & 0.307 & 0.307 & 0.263 & 0.322 & 0.300 \\
Tip semi-angle [$^\circ$] & 6 & 13 & 13 & 89 & 74 & 80 & 78 \\
Shoulder angle [$^\circ$] & 6.3 & 0.0 & 0.0 & 3.2 & 4.8 & 0.0 & 0.0 \\
$x_{cp}/L$ (Barrowman) & 0.667 & 0.465 & 0.467 & 0.500 & 0.600 & 0.438 & 0.500 \\
\midrule
$C_{D,\rm w}$ at $M=1.2$ & 0.0708 & 0.0530 & 0.0529 & 0.0450 & 0.0513 & 0.0496 & 0.0437 \\
$C_{D,\rm w}$ at $M=1.4$ & 0.0619 & 0.0516 & 0.0515 & 0.0457 & 0.0463 & 0.0497 & 0.0425 \\
$C_{D,\rm w}$ at $M=1.6$ & 0.0567 & 0.0504 & 0.0502 & 0.0456 & 0.0432 & 0.0491 & 0.0414 \\
\midrule
$\Delta z$ at $L/D=4$ [m] & -195 & -93 & -92 & -8 & -26 & -75 & +0 \\
$\Delta z$ at $L/D=4.5$ [m] & -72 & -19 & -18 & +38 & +42 & -9 & +60 \\
$\Delta z$ at $L/D=5$ [m] & -23 & +32 & +39 & +75 & +99 & +36 & +99 \\
\midrule
Shell + tip mass [g] & 286 & 361 & 361 & 361 & 318 & 376 & 354 \\
3U inside nose [mm] & 117 & 309 & 308 & 217 & 152 & 320 & 254 \\
Nose-bay length [mm] & 1043 & 870 & 870 & 943 & 1008 & 870 & 907 \\
$\Delta$ static margin [cal] & +0.09 & -0.07 & -0.06 & -0.03 & +0.04 & -0.08 & -0.04 \\
\bottomrule
\end{tabular}
\end{adjustbox}
\end{table}
