Landonowins/weisshorn-nose-cone/CFD/source/sections/tab_python_compare.tex

\begin{tabular}{@{}lrrrrrr@{}}
\toprule
 & \multicolumn{3}{c}{pressure (wave) $C_D$} & \multicolumn{3}{c}{friction (viscous) $C_D$} \\
\cmidrule(lr){2-4}\cmidrule(l){5-7}
$M$ & Python & Fluent & difference & Python & Fluent & difference \\
\midrule
0.95 & 0.0768 & 0.0042 & $-94.5$\,\% & 0.0236 & 0.0248 & $+5.2$\,\% \\
1.2 & 0.0926 & 0.0948 & $+2.4$\,\% & 0.0225 & 0.0224 & $-0.5$\,\% \\
1.47 & 0.0941 & 0.0963 & $+2.4$\,\% & 0.0210 & 0.0207 & $-1.4$\,\% \\
\bottomrule
\end{tabular}
