Landonowins/weisshorn-nose-cone/CFD/source/figures/fluent_cf_M1.20.png

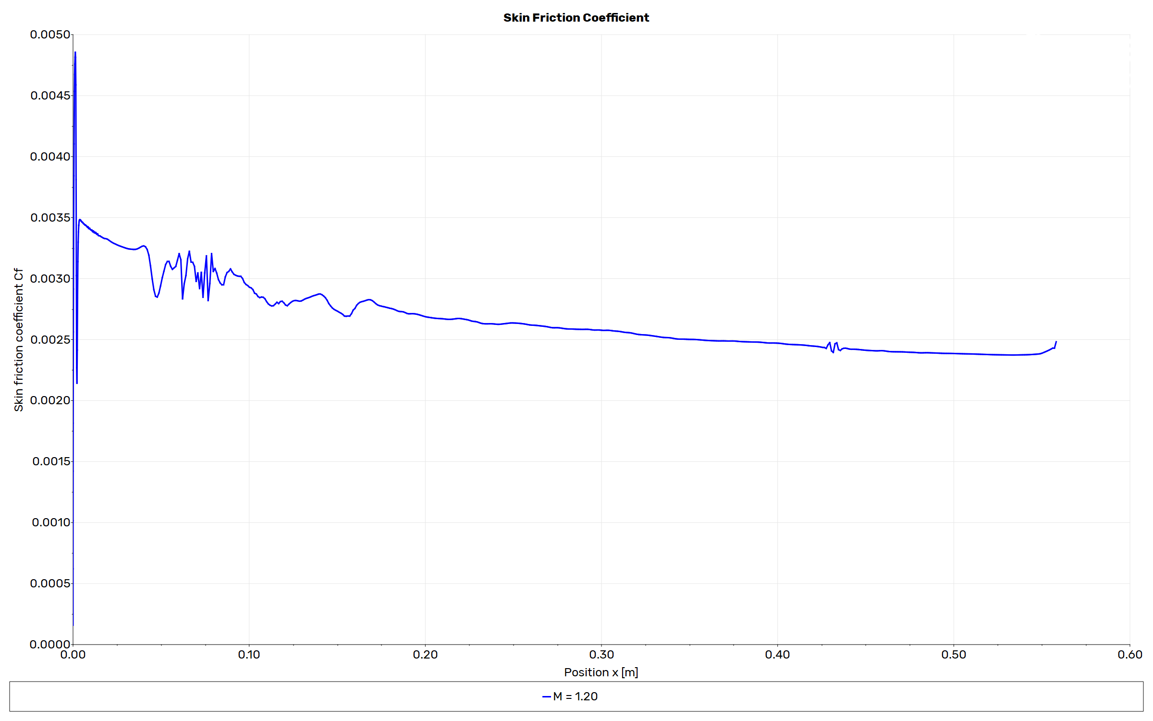
CFD/source/figures/fluent_cf_M1.20.png
