Landonowins/weisshorn-nose-cone/CFD/source/figures/fluent_cf_M1.47.png

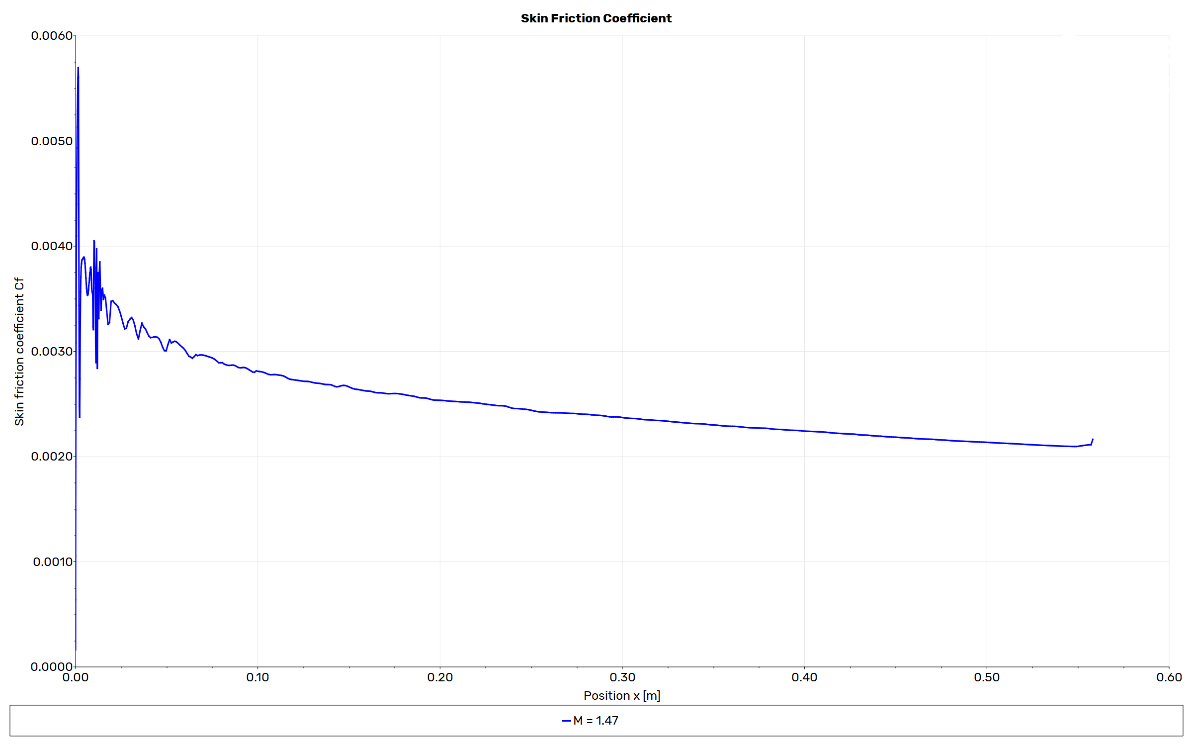
CFD/source/figures/fluent_cf_M1.47.png
