Landonowins/weisshorn-nose-cone/CFD/source/figures/fluent_cp_M0.95.png

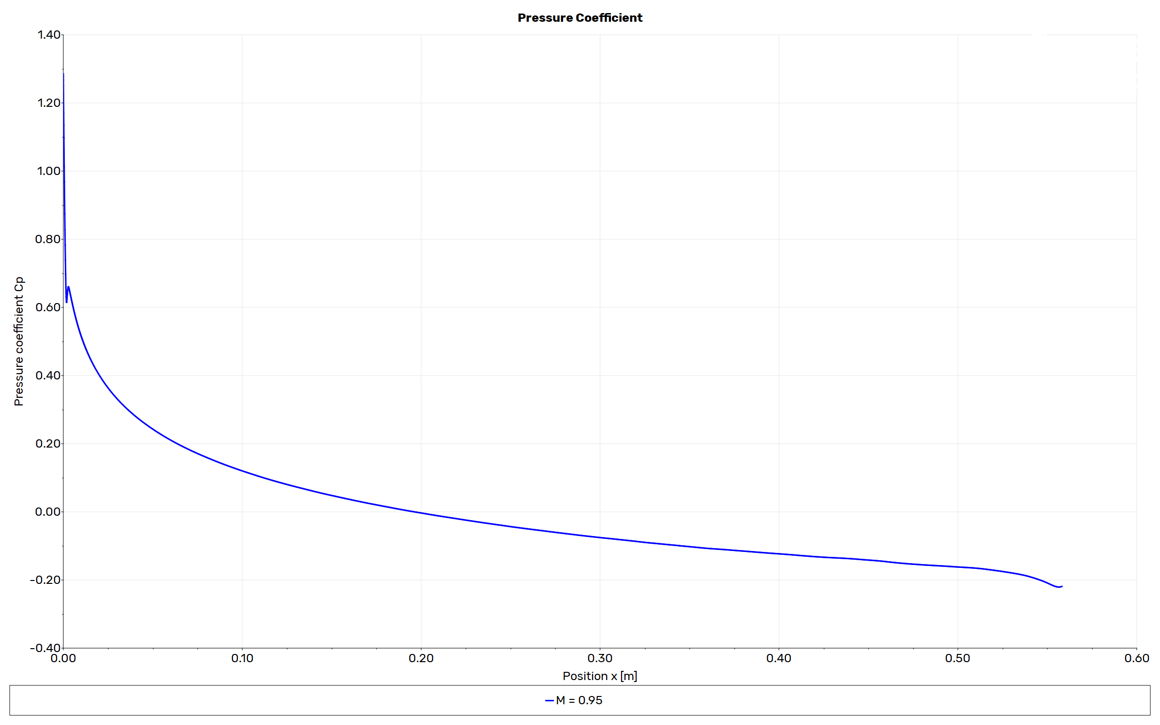
CFD/source/figures/fluent_cp_M0.95.png
