Landonowins/weisshorn-nose-cone/CFD/source/figures/fluent_cp_M1.20.png

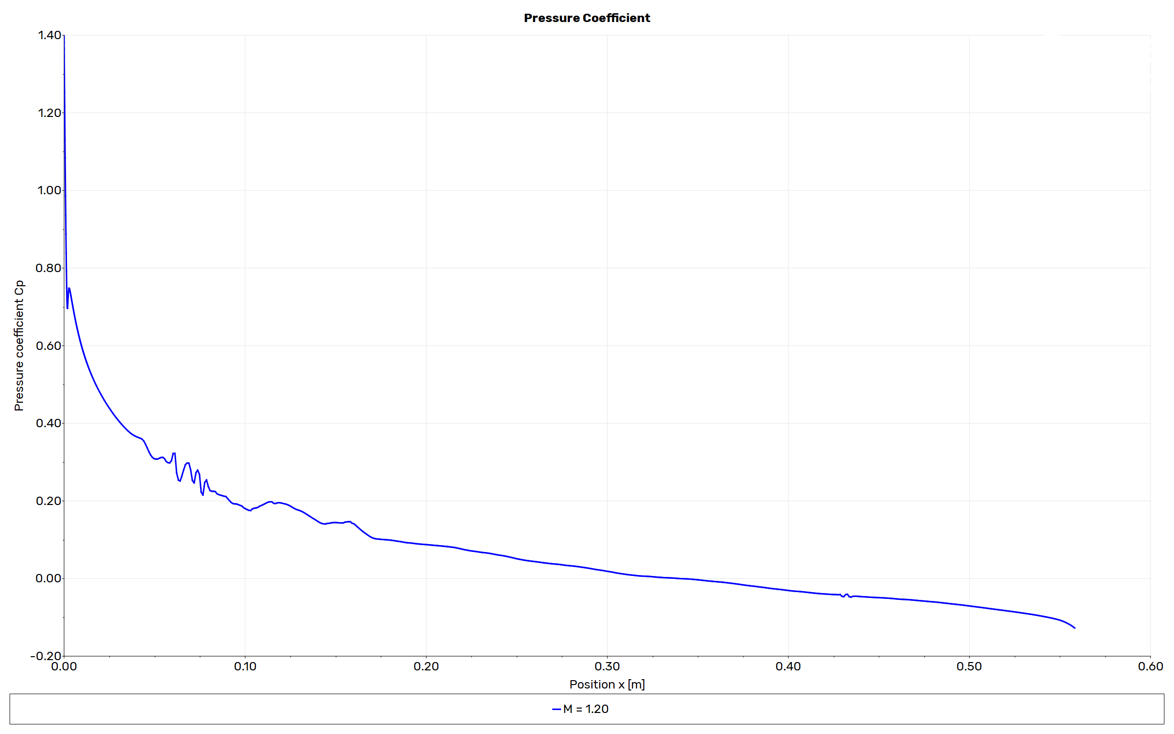
CFD/source/figures/fluent_cp_M1.20.png
