Landonowins/weisshorn-nose-cone/CFD/source/figures/geom_4_named_sel.png

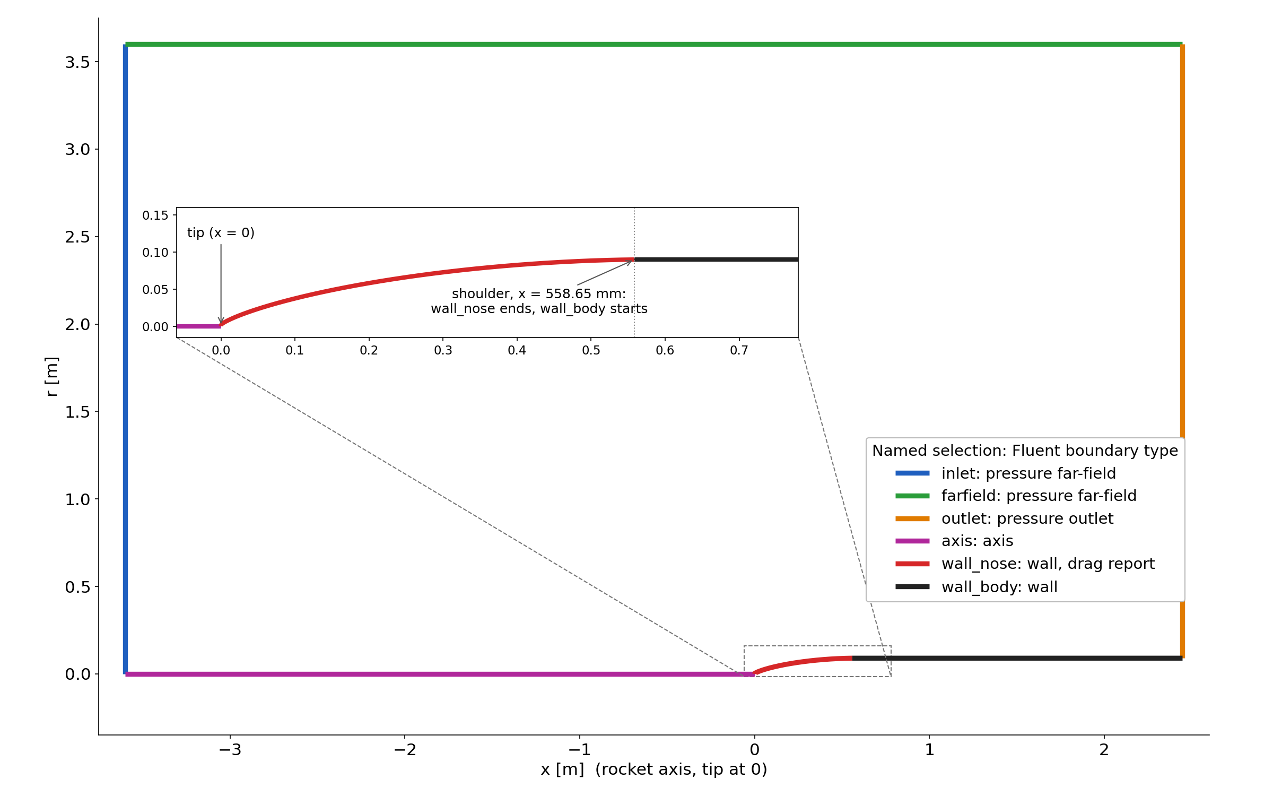
CFD/source/figures/geom_4_named_sel.png
