Landonowins/weisshorn-nose-cone/CFD/source/figures/mesh_1_full.png

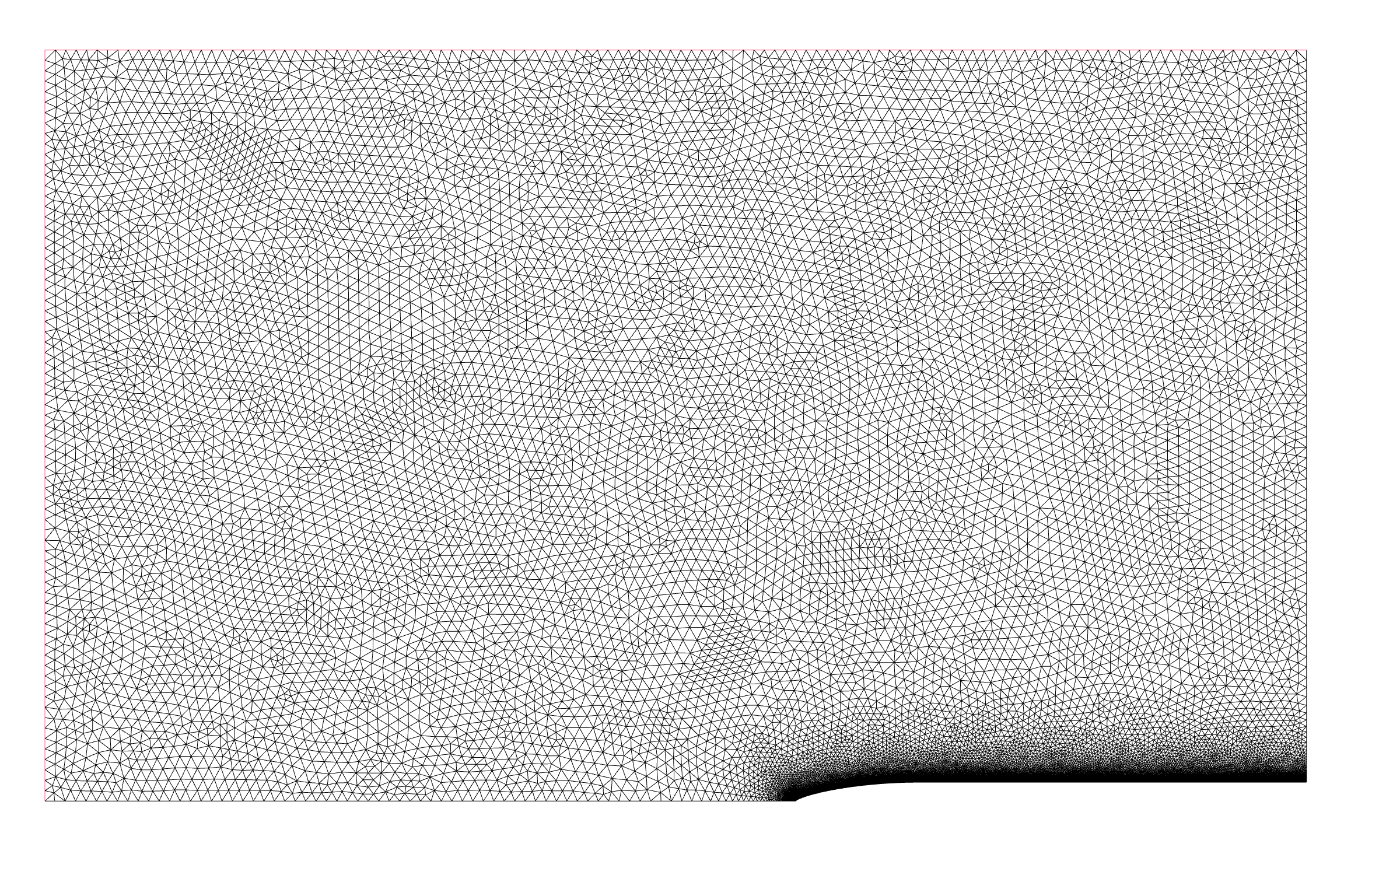
CFD/source/figures/mesh_1_full.png
