Landonowins/weisshorn-nose-cone/CFD/source/figures/mesh_2_nose.png

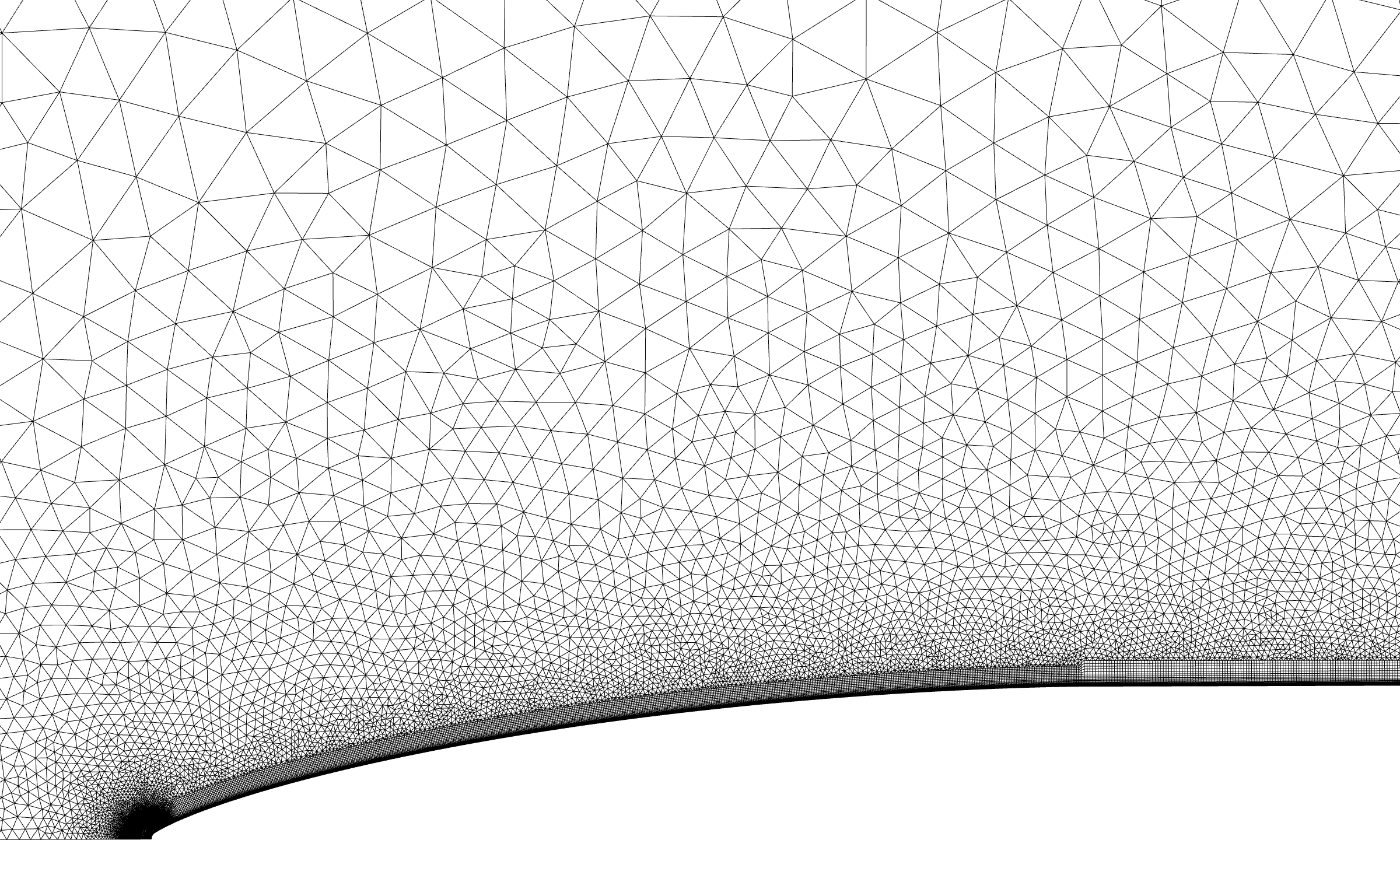
CFD/source/figures/mesh_2_nose.png
