Landonowins/weisshorn-nose-cone/CFD/studyA/plots/M0.95_cd.png

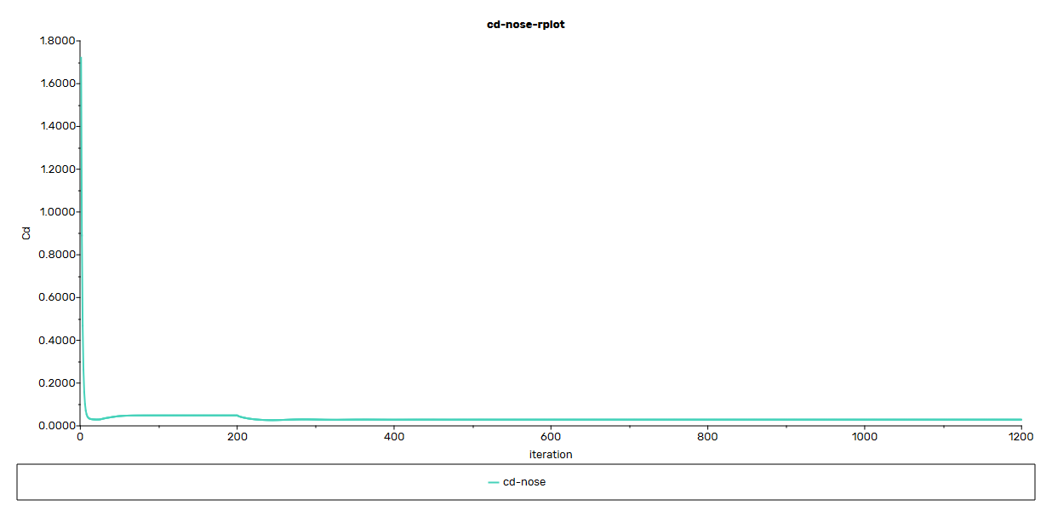
CFD/studyA/plots/M0.95_cd.png
