Landonowins/weisshorn-nose-cone/CFD/studyA/plots/M0.95_density-based_mach_iter1800.png

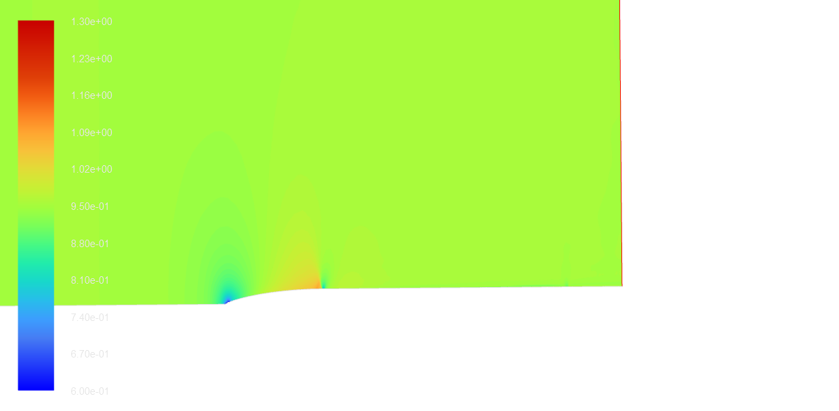
CFD/studyA/plots/M0.95_density-based_mach_iter1800.png
