Landonowins/weisshorn-nose-cone/CFD/studyA/plots/M0.95_mach_nose.png

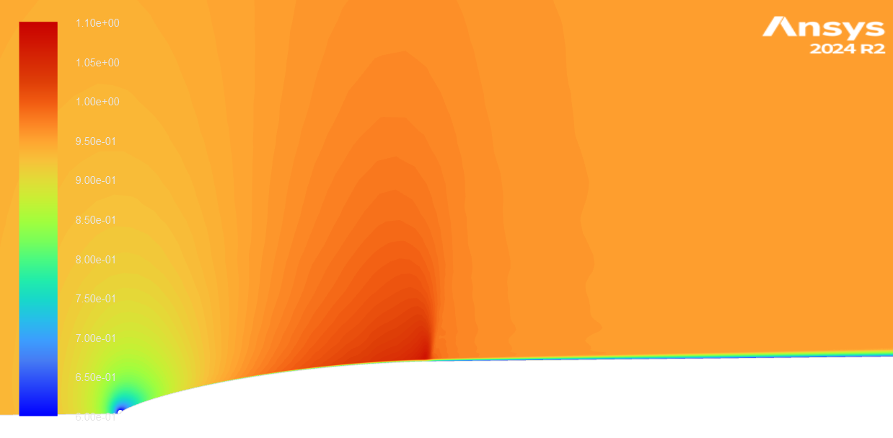
CFD/studyA/plots/M0.95_mach_nose.png
