Landonowins/weisshorn-nose-cone/CFD/studyA/plots/M0.95_residuals.png

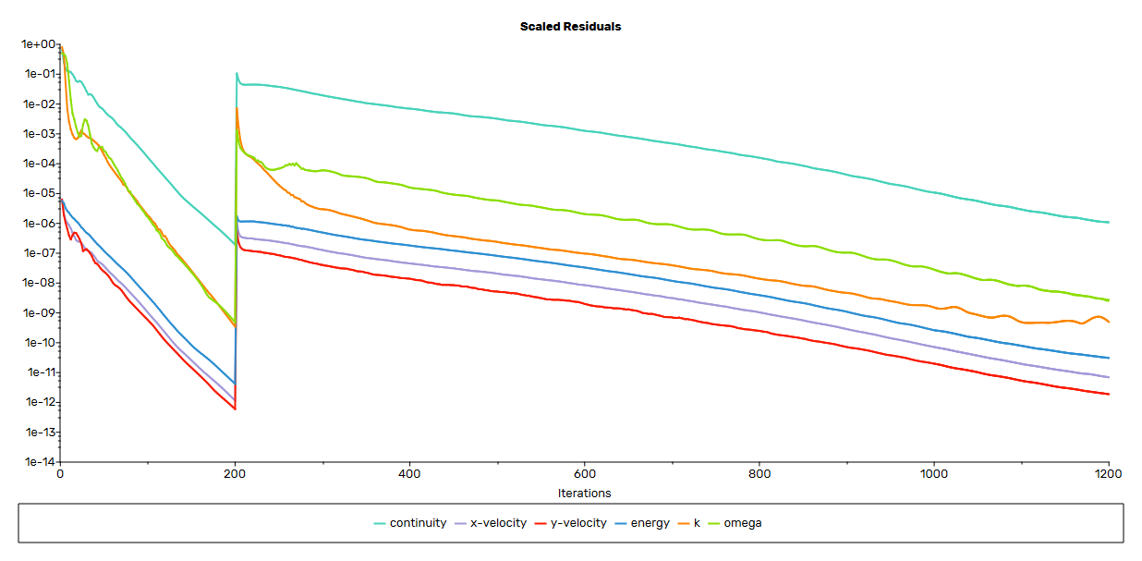
CFD/studyA/plots/M0.95_residuals.png
