Landonowins/weisshorn-nose-cone/CFD/studyA/plots/M1.20_cd.png

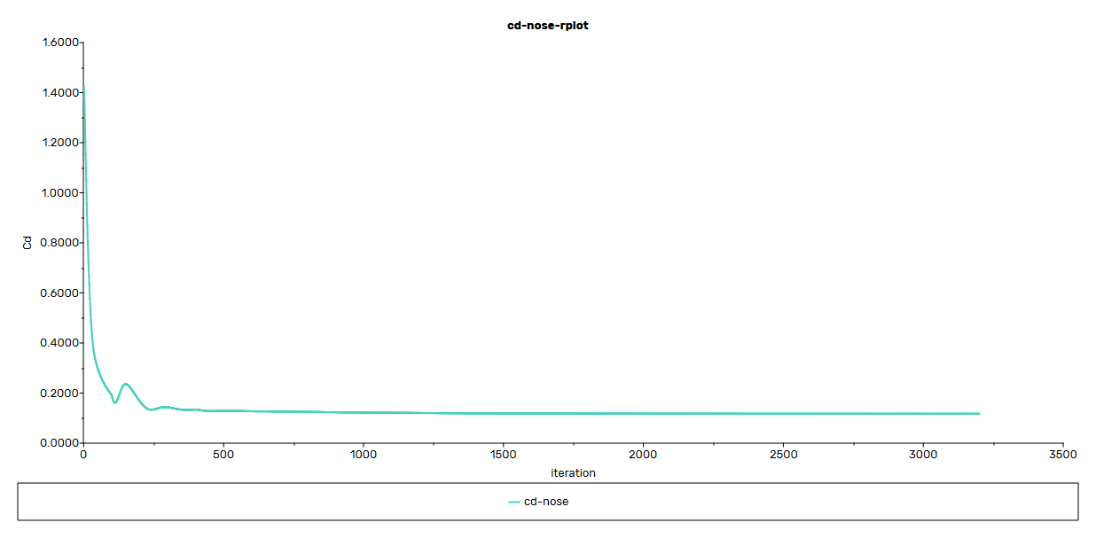
CFD/studyA/plots/M1.20_cd.png
