Landonowins/weisshorn-nose-cone/CFD/studyA/plots/M1.20_mach_nose.png

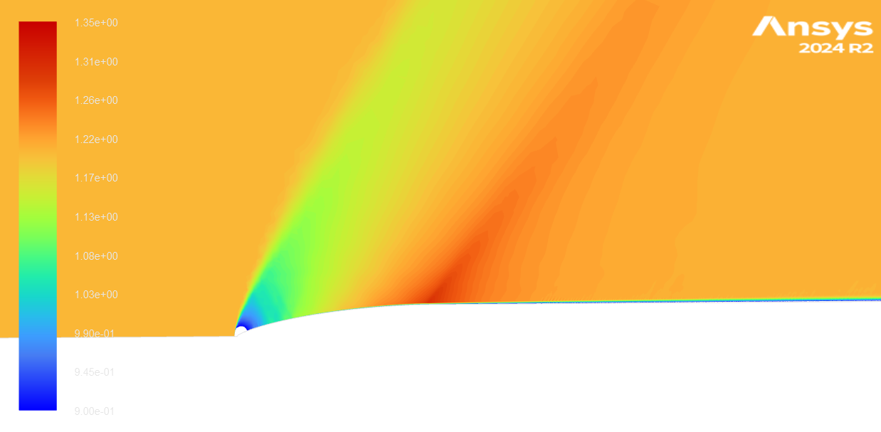
CFD/studyA/plots/M1.20_mach_nose.png
