Landonowins/weisshorn-nose-cone/CFD/studyA/plots/M1.20_residuals.png

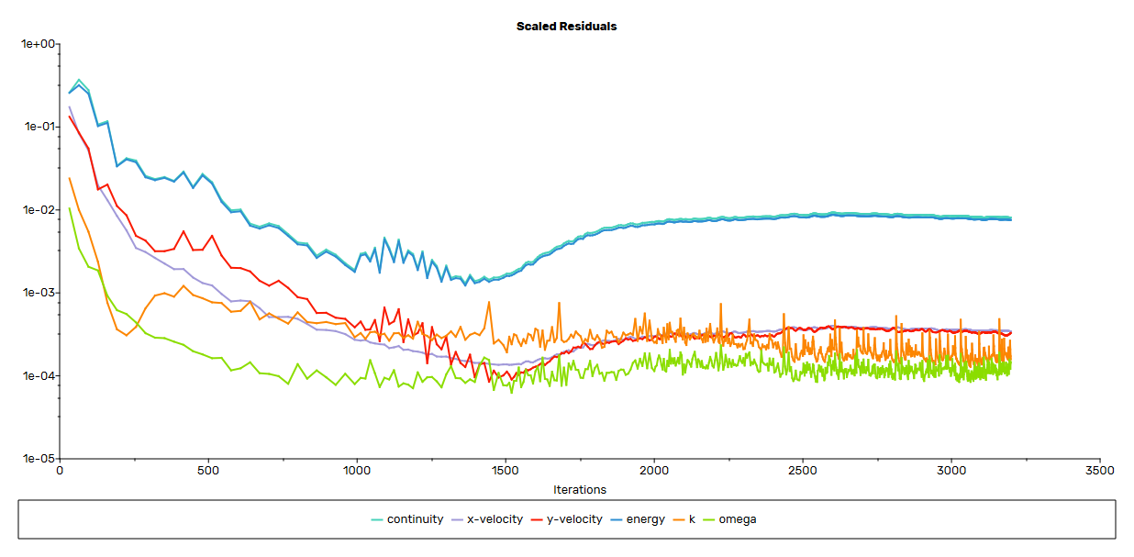
CFD/studyA/plots/M1.20_residuals.png
