Landonowins/weisshorn-nose-cone/CFD/studyA/plots/M1.47_mach_domain.png

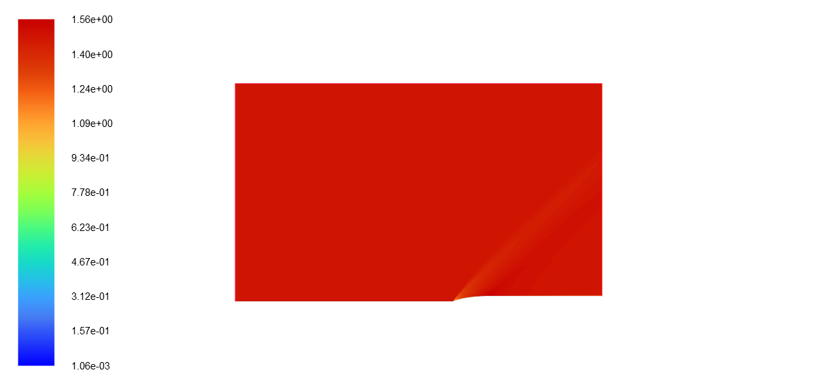
CFD/studyA/plots/M1.47_mach_domain.png
