Landonowins/weisshorn-nose-cone/CFD/studyA/plots/M1.47_residuals.png

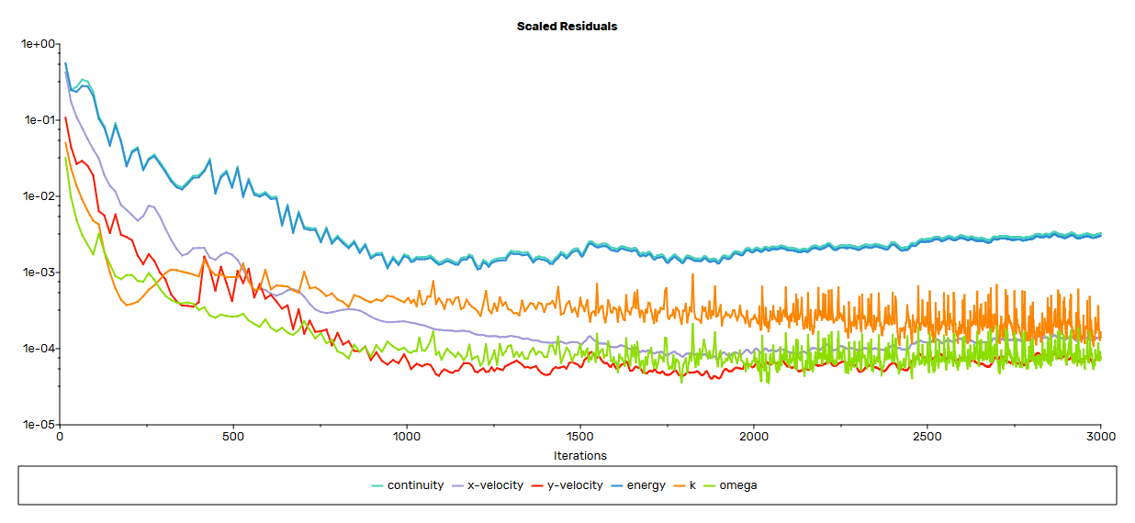
CFD/studyA/plots/M1.47_residuals.png
