Landonowins/weisshorn-nose-cone/report/sections/01b_nomenclature.tex

\section*{Nomenclature}
\addcontentsline{toc}{section}{Nomenclature}

{\small
\renewcommand{\arraystretch}{1.02}
\begin{longtable}{@{}>{\raggedright\arraybackslash}p{2.7cm}>{\raggedright\arraybackslash}p{11.0cm}>{\raggedright\arraybackslash}p{1.9cm}@{}}
\toprule
Symbol & Meaning & Unit \\
\midrule
\endfirsthead
\toprule
Symbol & Meaning & Unit \\
\midrule
\endhead
\bottomrule
\endfoot
\multicolumn{3}{@{}l}{\textit{Geometry}} \\
$D$, $R$ & body (base) diameter \SI{180}{mm}, radius $R = D/2$ & m \\
$L$, $L/D$ & nose profile length (theoretical apex to shoulder); fineness ratio & m, -- \\
$x$, $y$; $\xi$, $\eta$ & axial coordinate from the apex, local radius $y(x)$; $\xi = x/L$, $\eta = y/R$ & m; -- \\
$r_n$ & radius of the spherical tip (bluntness $r_n/R$) & m \\
$A_b$ & base area $\pi R^2$, reference area of all nose coefficients & m$^2$ \\
$V$ & internal volume of the nose (in Eq.~\eqref{eq:euler}: cell volume per radian) & m$^3$ \\
$\theta_{\rm sh}$ & angle between the profile and the body tube at the shoulder & $^\circ$ \\
$n$, $K'$, $C$, $\theta$ & power-series exponent; parabolic-series parameter; Haack-series parameter and angle variable & -- \\
\multicolumn{3}{@{}l}{\textit{Flow}} \\
$M$, $M_\infty$, $M_{\max}$ & Mach number $V/a$; free-stream Mach number; maximum of the flight & -- \\
$V_\infty$, $a$ & flight speed; speed of sound $\sqrt{\gamma R_g T}$ & m/s \\
$\gamma$, $R_g$ & ratio of specific heats (1.4); gas constant of air (\SI{287}{J/(kg.K)}) & --, J/(kg\,K) \\
$\mu$ & Mach angle, $\sin\mu = 1/M$ & $^\circ$ \\
$p$, $\rho$, $T$ & static pressure, density (in Table~\ref{tab:profiles}: ogive arc radius), temperature; subscript $\infty$: free stream & Pa, kg/m$^3$, K \\
$u$, $v$, $E$ & axial and radial velocity; total energy per unit volume & m/s, J/m$^3$ \\
$q_\infty$ & dynamic pressure $\tfrac12\rho_\infty V_\infty^2$ & Pa \\
$C_p$ & pressure coefficient $(p-p_\infty)/q_\infty$ & -- \\
\multicolumn{3}{@{}l}{\textit{Aerodynamic coefficients and flight}} \\
$C_{D,\rm w}$, $C_D$ & nose wave-drag coefficient (reference $A_b$); drag coefficient of the vehicle & -- \\
$C_{D,f}$, $C_{D,\rm fins}$, $C_{D,\rm base}$, $C_{D,e}$ & skin-friction, fin pressure, base and excrescence drag coefficients & -- \\
$k$ & calibration factor on the drag of everything except the nose & -- \\
$C_{N\alpha}$ & normal-force slope $\mathrm dC_N/\mathrm d\alpha$ ($\alpha$: angle of attack) & rad$^{-1}$ \\
$x_{cp}$, $x_{cg}$ & position of the centre of pressure and of the centre of gravity & m \\
$F_{\rm th}$, $m$, $g_0$ & thrust; vehicle mass; standard gravity & N, kg, m/s$^2$ \\
$I_t$, $I_{sp}$ & total impulse; specific impulse & N\,s, s \\
$z$, $\Delta z$ & altitude; apogee change relative to the baseline nose & m \\
\end{longtable}
\addtocounter{table}{-1}% the nomenclature list is not a numbered table
}

\noindent{\small\textbf{Abbreviations.}
3U: CubeSat payload unit, $100\times100\times\SI{340.5}{mm}$;
cal: calibre (length in body diameters);
CFD: computational fluid dynamics;
CFL: Courant--Friedrichs--Lewy number;
CG, CP: centre of gravity, of pressure;
DJF, DDF: Design Justification, Definition File;
EuRoC: European Rocketry Challenge;
FD, ST, SE, PL: ERT Flight Dynamics, Structure, Systems Engineering, Payload teams;
GCI: grid convergence index;
HLLC: Harten--Lax--van Leer--Contact Riemann solver;
ISA: International Standard Atmosphere;
LV, LVO, LVS: launch vehicle, Launch Vehicle Overview, Launch Vehicle Sizing;
MUSCL: Monotonic Upstream-centred Scheme for Conservation Laws;
PDR, CDR: Preliminary, Critical Design Review;
RANS: Reynolds-averaged Navier--Stokes;
SSP-RK2: two-stage strong-stability-preserving Runge--Kutta.\par}
