Landonowins/weisshorn-nose-cone/CFD/geometry_650/domain2d_nose_lvhaack_L561_c89_rn4.5mm.step

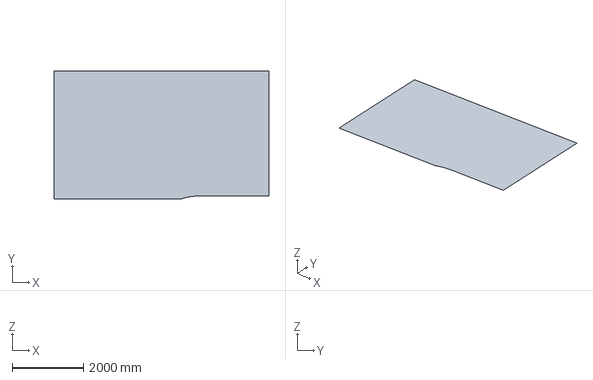
[picture p75: CAD file, 2026-10-29]
CFD/geometry_650/domain2d_nose_lvhaack_L561_c89_rn4.5mm.step
6047.6 x 3600.0 x 0 mm
