Landonowins/weisshorn-nose-cone/CFD/geometry_650/nose_power050_L464_c186_rn4.5mm.step

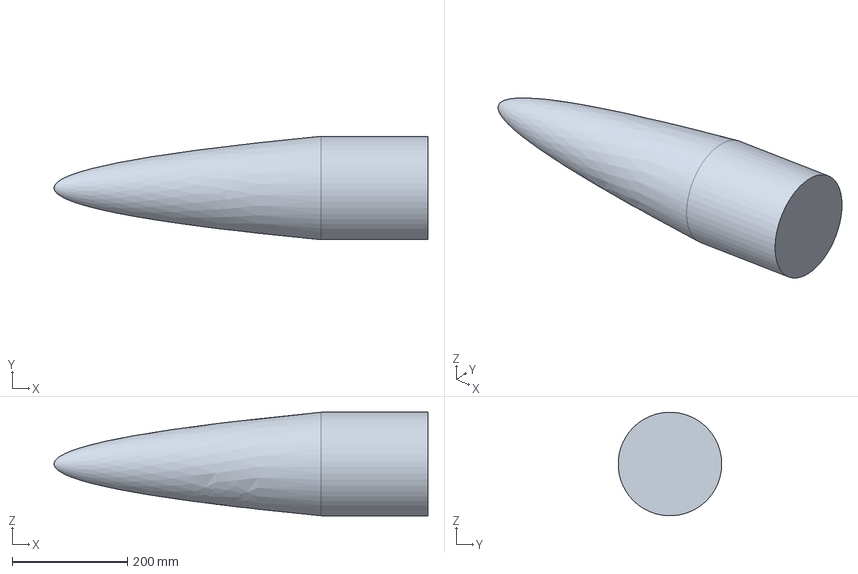
[picture p76: CAD file, 2026-10-21]
CFD/geometry_650/nose_power050_L464_c186_rn4.5mm.step
650.0 x 179.8 x 179.9 mm
