Landonowins/weisshorn-nose-cone/CFD/geometry_650/nose_lvhaack_L561_c89_rn4.5mm.step

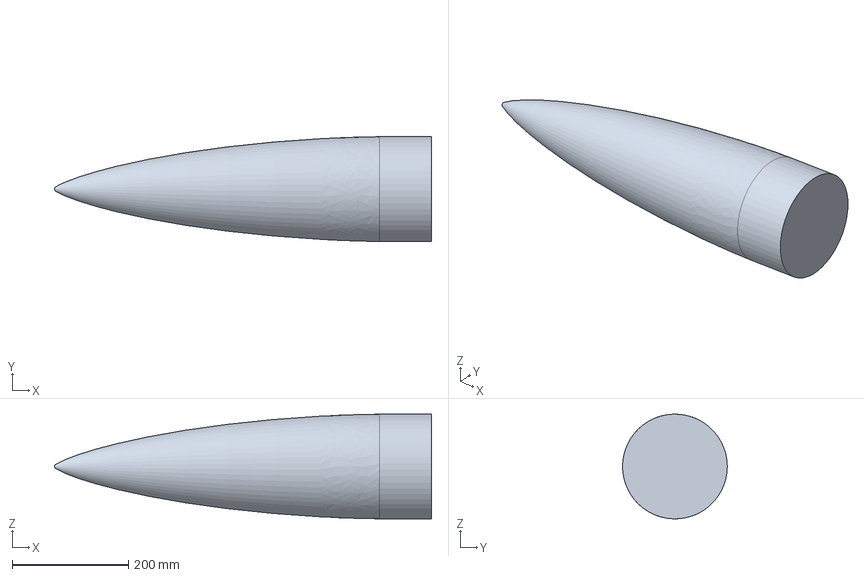
[picture p78: CAD file, 2026-10-21]
CFD/geometry_650/nose_lvhaack_L561_c89_rn4.5mm.step
647.7 x 179.8 x 179.9 mm
