Landonowins/weisshorn-nose-cone/legacy/results/cad/nose_ogive_LD4.5.stl

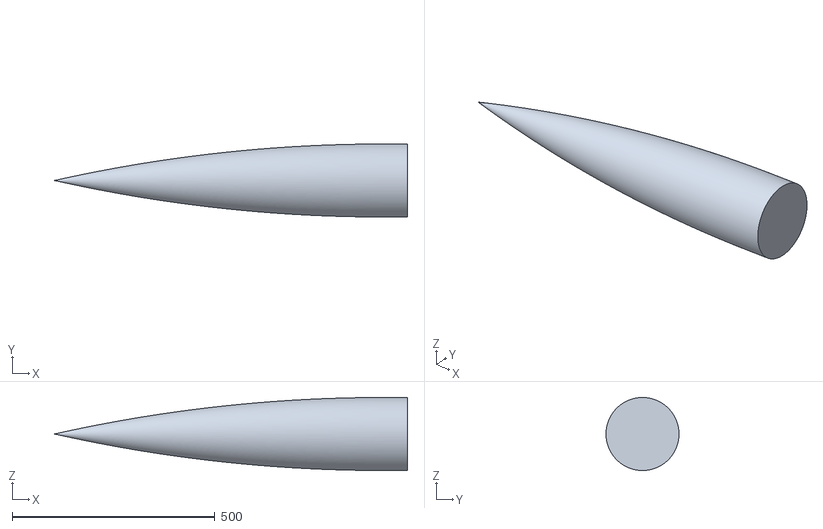
[picture p81: CAD file, 2026-10-14, an earlier design]
legacy/results/cad/nose_ogive_LD4.5.stl
870.0 x 180.0 x 180.0
