Landonowins/weisshorn-nose-cone/(list of files, cad)

Other CAD files:
CFD/geometry_650/domain2d_nose_vonkarman_L630_c20_rn4.5mm.step
CFD/geometry_650/nose_vonkarman_L495_c155_rn4.5mm.step
