Landonowins/weisshorn-nose-cone/docs/user_guide/user_guide.tex

\documentclass[12pt]{article}

% PACKAGE IMPORTS (ERT template)
\usepackage{fancyhdr}
\usepackage[utf8]{inputenc}
\usepackage[T1]{fontenc}
\usepackage[english]{babel}
\usepackage{graphicx}
\usepackage{titlesec}
\usepackage{csquotes}
\usepackage{enumitem}
\usepackage{amsfonts}
\usepackage[font=small,skip=0pt]{caption}
\usepackage{subcaption}
\usepackage{hyperref}
\hypersetup{hidelinks}
\usepackage{float}
\usepackage{xcolor}
\usepackage{amsmath,amssymb}
\usepackage{booktabs}
\usepackage{adjustbox}
\usepackage{calc}
\usepackage{colortbl}
\usepackage{array}
\usepackage{etoolbox}
\usepackage{ragged2e}
\usepackage{textcomp, gensymb}
\usepackage{tikz}
\usetikzlibrary{positioning,arrows.meta,shapes.misc}
\usepackage{geometry}
\usepackage{lastpage}
\usepackage[scaled]{helvet}
\usepackage{soul}
\usepackage{eso-pic}
\usepackage[useregional]{datetime2}
\usepackage{longtable}
\usepackage{siunitx}
\sisetup{detect-all}
\usepackage{tabularx}
\usepackage{listings}
\usepackage{needspace}

\graphicspath{{pictures/template/}{figures/}}
\renewcommand\familydefault{\sfdefault}

\definecolor{ertred}{RGB}{226,12,24}
\definecolor{codebg}{RGB}{246,246,244}
\definecolor{codekw}{RGB}{38,92,170}
\definecolor{codecm}{RGB}{110,110,104}
\definecolor{codestr}{RGB}{160,60,20}
\definecolor{notebg}{RGB}{238,243,251}

\lstdefinestyle{ert}{basicstyle=\ttfamily\footnotesize, backgroundcolor=\color{codebg}, frame=single,
  rulecolor=\color{codebg}, framesep=3pt, xleftmargin=4pt, xrightmargin=4pt, columns=fullflexible,
  keepspaces=true, breaklines=true, showstringspaces=false, upquote=true,
  keywordstyle=\color{codekw}\bfseries, commentstyle=\color{codecm}\itshape, stringstyle=\color{codestr},
  aboveskip=6pt, belowskip=6pt}
\lstdefinelanguage{yaml}{morecomment=[l]{\#}, morestring=[b]", sensitive=true}
\lstset{style=ert}
\newcommand{\cmd}[1]{\texttt{#1}}
\newcommand{\key}[1]{\texttt{#1}}
% long identifiers in running text may break after an underscore or a dot
\let\ulorig\_
\renewcommand{\_}{\ulorig\allowbreak}
\newcommand{\dotbreak}{.\allowbreak}
\newcommand{\note}[1]{\par\smallskip\noindent\colorbox{notebg}{\parbox{\dimexpr\textwidth-2\fboxsep}{#1}}\par\smallskip}

\geometry{a4paper, inner=20mm, outer=20mm, top=26mm, bottom=30mm, footskip=10mm, headsep=13mm}
\sodef\an{}{.1em}{0.1em}{0.1em}

\newcommand\BackgroundPic{\put(0,0){\parbox[b][\paperheight]{\paperwidth}{\vfill\centering
\vfill}}}

\begin{document}
\setlength{\emergencystretch}{3em}

\AddToShipoutPicture*{\BackgroundPic}
\ClearShipoutPicture

\let\oldheadrule\headrule
\renewcommand{\headrule}{\color{ertred}\oldheadrule}
\renewcommand{\headrulewidth}{1.5pt}
\renewcommand{\footrule}{\hbox to\headwidth{\color{ertred}\leaders\hrule height \footrulewidth\hfill}}
\renewcommand{\footrulewidth}{1.5pt}
\setlength\headheight{48pt}
\pagestyle{fancy}
\fancyhead[C]{\rule[-2ex]{0pt}{2ex} \bf{ \fontsize{12}{5} \selectfont 2027\_C\_FD\_REPORT-3\_NOSE-CONE-TOOL-USER-GUIDE}}
\lhead{\vspace{-4mm}}
\rhead{\vspace{-4mm}}
\cfoot{}
\fancyfoot[R]{\bf{\thepage/\pageref{LastPage}}}
\fancyfoot[L]{\rule[-2ex]{0pt}{2ex}\bf{EPFL ROCKET TEAM}}

\begin{titlepage}
\vspace*{-2.40cm}
\noindent\hspace*{-1.2cm}
\parbox{\linewidth}{\bfseries\fontsize{34}{38}\selectfont NOSE-CONE DESIGN\\ TOOL: USER GUIDE\\}
\newline\hspace*{-1.2cm}
\parbox{\linewidth}{\bfseries\fontsize{14}{18}\selectfont Fabio Feig - 315169 \\}
\begin{tikzpicture}[remember picture,overlay]
\node[anchor=south east,inner sep=39mm] at (current page.south east) {\parbox[b][-2.37cm][t]{15cm}{\raggedleft
\fontsize{12}{12} \selectfont \normalfont \textbf{Python package \texttt{nosecone} -- version 1.0}}};
\end{tikzpicture}
\begin{tikzpicture}[remember picture,overlay]
\node[anchor=south east,inner sep=39mm] at (current page.south east) {\parbox[b][-0.8cm][t]{15cm}{\raggedleft
\fontsize{12}{12} \selectfont \normalfont Date: \today}};
\end{tikzpicture}
\begin{tikzpicture}[remember picture,overlay]
\node[anchor=south east,inner sep=39mm] at (current page.south east) {\parbox[b][-1.6cm][t]{15cm}{\raggedleft
\fontsize{12}{12} \selectfont \normalfont Doc ID: 2027\_C\_FD\_REPORT-3\_NOSE-CONE-TOOL-USER-GUIDE}};
\end{tikzpicture}
\end{titlepage}

\pagenumbering{roman}
\tableofcontents
\newpage
\pagenumbering{arabic}
\setcounter{page}{1}

\input{sections/00_quickstart}
\input{sections/01_scope}
\input{sections/02_install}
\input{sections/03_structure}
\input{sections/04_parameters}
\input{sections/05_running}
\input{sections/06_outputs}
\input{sections/07_extending}

\appendix
\input{sections/08_appendix}

\end{document}
