Landonowins/weisshorn-nose-cone/docs/user_guide/sections/01_scope.tex

\section{What the Tool Does, and What It Does Not}
\label{sec:scope}

The \texttt{nosecone} package compares nose cones for a supersonic sounding rocket (\emph{profile}, \emph{fineness}
$L/D$ and \emph{tip radius}) and exports the CAD geometry of the selected one. It reproduces
2027\_C\_FD\_REPORT-1\_NOSE-CONE exactly, but every vehicle-specific number is an input, so it serves any ERT
rocket.

\begin{figure}[H]
\centering
\begin{tikzpicture}[node distance=5mm and 7mm, every node/.style={font=\footnotesize},
  box/.style={draw, rounded corners=2pt, align=center, minimum height=9mm, text width=31mm, fill=white},
  inp/.style={box, fill=notebg}, outp/.style={box, fill=codebg}, arr/.style={-{Latex[length=2mm]}, thick}]
\node[inp] (cfg) {configuration\\(YAML file)};
\node[inp, right=of cfg] (db) {CFD database\\$C_{D,\rm w}$(profile, $L/D$, $M$)};
\node[box, right=of db] (euler) {Euler solver\\(new cases, optional)};
\node[box, below=of db] (wd) {wave-drag model\\interpolation + transonic rise};
\node[box, below=of cfg] (geo) {geometry\\profile, volume, area, CP};
\node[box, below=of wd] (drag) {drag build-up\\friction, fins, base, excr.\ ($\times k$)};
\node[box, below=of drag] (traj) {trajectory\\point mass, ISA, rail};
\node[box, below=of geo, yshift=-14mm] (mass) {mass, payload fit,\\static-margin change};
\node[box, right=of traj] (heat) {heating\\tip and shell};
\node[outp, below=of traj] (res) {sweep, sensitivities, robustness,\\decision matrix};
\node[outp, below=of mass, yshift=-5mm] (cad) {CAD: CSV, STL, STEP};
\node[outp, below=of heat, yshift=-5mm] (out) {plots, tables,\\summary, LaTeX};
\draw[arr] (cfg) -- (geo); \draw[arr] (db) -- (wd); \draw[arr] (euler) -- (db);
\draw[arr] (wd) -- (drag); \draw[arr] (drag) -- (traj); \draw[arr] (geo) -- (mass); \draw[arr] (geo.east) -- ++(4mm,0) |- (drag.west);
\draw[arr] (mass.east) -- (traj.west); \draw[arr] (traj) -- (heat); \draw[arr] (traj) -- (res); \draw[arr] (mass) -- (cad);
\draw[arr] (res) -- (out); \draw[arr] (heat) -- (out);
\end{tikzpicture}
\caption{Computation chain of one run (\texttt{python -m nosecone run}). Shaded blue: inputs; grey: outputs.}
\label{fig:chain}
\end{figure}

\paragraph{Computed for every nose} (profile $\times$ fineness $\times$ tip radius): geometry (volume, wetted area,
shoulder angle, Barrowman CP, payload room), wave drag $C_{D,\rm w}(M)$ from the CFD database, apogee of the full
vehicle, nose mass and static-margin change against a baseline nose. \textbf{For the study}: apogee sensitivities,
robustness of the ranking, cost of a blunt tip, tip and shell temperatures, a decision matrix and the CAD files.

\paragraph{Limits.}
\begin{itemize}[leftmargin=*,itemsep=1pt]
\item \textbf{Wave drag}: inviscid Euler CFD at zero incidence, tabulated at $M = 1.1$--1.6 and $L/D = 2.5$--5
for the sweep profiles; held constant outside. Below $M = 1.1$ an assumed transonic ramp (the weakest part; replace with RANS data).
\item \textbf{Rest of the vehicle}: empirical drag build-up scaled by one factor $k$, calibrated on a known apogee.
\item \textbf{Trajectory}: 2D point mass, ISA below \SI{11}{km}, no wind. \textbf{Stability}: Barrowman, use for
\emph{changes} of static margin only.
\item \textbf{Not done}: structure, viscous or transonic CFD, angle of attack, 6-DOF flight, shape optimisation.
A profile without CFD data is skipped unless \key{aerodynamics.compute\_missing} is true.
\end{itemize}
\texttt{tests/verify\_reference.py} checks that the Weisshorn results are still reproduced
(Appendix~\ref{app:verification}); run it after any code change.
