Landonowins/weisshorn-nose-cone/docs/user_guide/sections/04_parameters.tex

\section{The Configuration File}
\label{sec:parameters}

\subsection{How the file works}

A study is one YAML file (\texttt{configs/weisshorn.yaml} is the complete, commented example): \emph{sections}
contain \texttt{name: value} lines indented by two spaces, lists are \texttt{[a, b, c]}, \texttt{\#} starts a comment.
\begin{itemize}[leftmargin=*,itemsep=1pt]
\item \textbf{Only what differs from the default is needed}; \textbf{units are SI} (lengths in metres:
\texttt{diameter: 0.180}, not \texttt{180}); relative paths are relative to the file.
\item \textbf{Inheritance}: \texttt{base: weisshorn.yaml} takes every value of that file and overrides only what is
listed; a list replaces the inherited list.
\item \textbf{Checking}: \texttt{python -m nosecone validate my.yaml} stops at the first problem with a precise
message (e.g.\ \texttt{unknown parameter 'nose.profils' (did you mean 'profiles'?)}); \texttt{-{}-show} prints every
value used. The run saves them as \texttt{config\_used.yaml}.
\item \textbf{All parameters}: \texttt{python -m nosecone describe-config} lists every parameter with unit, valid
range and default (\texttt{-{}-basic} hides the advanced numerical settings).
\end{itemize}

\subsection{The parameters you change}
\label{sec:paramtables}

Table~\ref{tab:keyparams} lists what a new rocket or a new study needs (\texttt{configs/example\_new\_rocket.yaml}
sets exactly these). Everything else has a sensible default.

\begin{table}[H]
\centering
\caption{Main parameters. Default values are those of Weisshorn.}
\label{tab:keyparams}
\footnotesize
\begin{tabular}{@{}>{\raggedright\arraybackslash}p{4.6cm}>{\raggedright\arraybackslash}p{1.3cm}>{\raggedright\arraybackslash}p{10.1cm}@{}}
\toprule
Parameter & Unit & Meaning \\
\midrule
\key{project.name}, \key{project.output\_dir} & & study name (plots, file names); output folder \\
\midrule
\key{vehicle.diameter} & m & body diameter $D$ (nose base) \\
\key{vehicle.length}, \key{reference\_nose\_length} & m & total length; the nose length included in it \\
\key{vehicle.mass\_wet}, \key{mass\_dry} & kg & lift-off and burn-out mass \\
\key{vehicle.nozzle\_exit\_diameter} & m & removed from the base area while burning \\
\midrule
\key{engine.thrust}, \key{burn\_time} & N, s & constant thrust and burn duration \\
\key{engine.total\_impulse}, \key{specific\_impulse} & N\,s, s & set the propellant mass \\
\midrule
\key{fins.count}, \key{root\_chord}, \key{tip\_chord}, \key{span}, \key{sweep}, \key{thickness} & --, m & trapezoidal fins \\
\key{launch.rail\_length}, \key{rail\_elevation}, \key{site\_altitude} & m, \textdegree, m & launch rail and site \\
\midrule
\key{flight.calibrate}, \key{target\_apogee} & --, m & scale the non-nose drag by $k$ so that the baseline nose reaches this apogee \\
\key{flight.drag\_factor} & -- & $k$ when \key{calibrate} is false \\
\midrule
\key{nose.profiles}, \key{fineness}, \key{tip\_radius\_ratios} & -- & the sweep: profiles $\times$ $L/D$ $\times$ $r_n/R$ \\
\key{nose.baseline\_profile}, \key{baseline\_fineness} & -- & reference nose for apogee and static-margin changes \\
\key{nose.design\_profile}, \key{design\_fineness}, \key{design\_tip\_radius\_ratio} & -- & selected design (CAD, heating, final drawing) \\
\key{nose.shoulder\_length} & m & cylindrical shoulder behind the curved part \\
\midrule
\key{payload.enabled}, \key{length}, \key{required\_radius} & --, m, m & payload fit in the nose \\
\key{structure.shell\_areal\_density}, \key{tip\_mass} & kg/m\textsuperscript{2}, kg & nose mass model \\
\midrule
\key{output.plots}, \key{output.latex} & -- & \texttt{[all]} or a list of plots (Section~\ref{sec:plots}); write LaTeX tables \\
\bottomrule
\end{tabular}
\end{table}

\subsection{Structured parameters}
\label{sec:structured}

\paragraph{Profiles.} Built-in: \texttt{cone}, \texttt{ogive}, \texttt{parabolic}, \texttt{power050},
\texttt{power075}, \texttt{lvhaack}, \texttt{vonkarman}. Other members of a family (\texttt{python -m nosecone
profiles} lists them) go in \key{nose.custom\_profiles}:
\begin{lstlisting}[language=yaml]
nose:
  custom_profiles:
    power060: {family: power, n: 0.6, label: "Power $n=0.6$"}
  profiles: [vonkarman, power060]
\end{lstlisting}
A custom profile has no CFD data until it is computed (\key{aerodynamics.compute\_missing: true}).

\paragraph{Robustness scenarios.} A name plus changes to the nominal model (\texttt{transonic\_onset},
\texttt{transonic\_factor}, \texttt{drag\_factor\_scale}, \texttt{mass\_model}, \texttt{ground\_temperature}):
\begin{lstlisting}[language=yaml]
robustness:
  scenarios:
    - {name: nominal}
    - {name: "transonic peak +20 %", transonic_factor: 1.2}
\end{lstlisting}

\paragraph{Decision matrix.} \key{trade\_matrix.weights} (e.g.\ \texttt{\{performance: 4, integration: 2,
manufacture: 2, stability: 1\}}) are normalised to sum to one; \key{manufacture} scores are your judgement, the
others are computed.

\paragraph{CFD studies.} \key{cfd.studies}: a list of \texttt{\{name, profiles, fineness, machs\}} (optional
\texttt{tip\_radius\_ratios}, \texttt{grid}, \texttt{max\_iter}); see Section~\ref{sec:newcfd}.
