Landonowins/weisshorn-nose-cone/docs/user_guide/sections/05_running.tex

\section{Running Studies}
\label{sec:running}

\subsection{Commands}

Everything goes through \texttt{python -m nosecone <command>} (\texttt{-{}-help} lists the options of each).

\begin{table}[H]
\centering
\caption{Commands. Typical run times on a laptop with the Weisshorn database.}
\label{tab:commands}
\footnotesize
\begin{tabular}{@{}>{\raggedright\arraybackslash}p{4.4cm}>{\raggedright\arraybackslash}p{9.0cm}>{\raggedright\arraybackslash}p{2.6cm}@{}}
\toprule
Command & What it does & Time \\
\midrule
\texttt{run CONFIG} & The whole study: sweep, sensitivities, robustness, heating, CAD, plots, tables. Options:
\texttt{-{}-plots trade,cdw}, \texttt{-{}-no-plots}, \texttt{-{}-latex}, \texttt{-{}-output DIR} & 1--5 min \\
\texttt{export CONFIG} & Only the CAD files of the selected design & seconds \\
\texttt{validate CONFIG} & Check the file; \texttt{-{}-show} prints all values used & instant \\
\texttt{describe-config} & Every parameter with unit, range and default & instant \\
\texttt{profiles} & Profile families and built-in profiles & instant \\
\texttt{cfd CONFIG} & Run the CFD studies of \key{cfd.studies} (\texttt{-{}-dry-run} lists the jobs) & 3--10 min per geometry \\
\texttt{rebuild-database CONFIG} & Rebuild the database CSV from the wall-pressure files & 1 min \\
\bottomrule
\end{tabular}
\end{table}

A run prints its progress (also in \texttt{run.log}); when it finishes, start with \texttt{summary.md}.

\subsection{Worked example 1: a single design}
\label{sec:single}

\emph{How does a Von K\'arm\'an nose of \SI{810}{mm} ($L/D = 4.5$) with a \SI{4.5}{mm} tip perform on
Weisshorn?} \texttt{configs/example\_single\_design.yaml} inherits the vehicle and restricts the sweep to that nose
(main lines):
\begin{lstlisting}[language=yaml]
base: weisshorn.yaml
project: {name: Weisshorn single design, output_dir: ../output/example_single_design}
nose:
  profiles: [vonkarman]
  fineness: [4.5]
  design_profile: vonkarman
  design_fineness: 4.5
  design_tip_radius_ratio: 0.05  # 4.5 mm spherical tip (r_n / R)
robustness: {enabled: false}
trade_matrix: {enabled: false}
\end{lstlisting}
\texttt{summary.md} gives the answer (some columns left out):
\begin{lstlisting}[language={},basicstyle=\ttfamily\scriptsize]
| shape     | fineness | cd_w_14 | apogee | d_apogee | mass_g | l3U_mm | bay_mm | dSM_cal |
| vonkarman | 4.5      | 0.0425  | 9060   | +60      | 354    | 254    | 907    | -0.036  |
\end{lstlisting}
With $k = 0.56$ calibrated so that the baseline nose (Von K\'arm\'an, $L/D = 4$) reaches \SI{9}{km}, this nose
flies \SI{60}{m} higher, weighs \SI{354}{g}, houses \SI{254}{mm} of the payload in its curved part and lowers the
static margin by 0.036 calibre. The CAD files are in \texttt{cad/}.

\subsection{Worked example 2: a parameter sweep}
\label{sec:sweep}

\emph{Which of power-$\tfrac12$, LV-Haack and Von K\'arm\'an is best, and how long should the nose be?} Every
list in \key{nose.profiles}, \key{fineness} or \key{tip\_radius\_ratios} is swept (here $3 \times 4$ noses):
\begin{lstlisting}[language=yaml]
base: weisshorn.yaml
project: {name: Weisshorn sweep, output_dir: ../output/example_sweep}
nose:
  profiles: [power050, lvhaack, vonkarman]
  fineness: [3.5, 4.0, 4.5, 5.0]
output:
  plots: [cdw, trade, robustness, gallery, schematics]
\end{lstlisting}
\begin{lstlisting}[language={},basicstyle=\ttfamily\scriptsize]
| shape     | fineness | cd_w_14 | apogee | d_apogee | mass_g | l3U_mm | bay_mm | dSM_cal |
| vonkarman | 5        | 0.0350  | 9099   | +99      | 386    | 282    | 968    | -0.071  |
| power050  | 5        | 0.0387  | 9075   | +75      | 394    | 241    | 1009   | -0.067  |
| vonkarman | 4.5      | 0.0425  | 9060   | +60      | 354    | 254    | 907    | -0.036  |
| ...
\end{lstlisting}
From $L/D = 4$ up, Von K\'arm\'an flies highest; LV-Haack is 63--81~m lower but houses more payload. Each extra
\SI{90}{mm} of length gains less (+85, +60, +39~m), and the \texttt{robustness} plot shows that the ranking holds
in every modelling scenario.

\subsection{Other cases}
\label{sec:newrocket}
\label{sec:newcfd}

\begin{itemize}[leftmargin=*,itemsep=2pt]
\item \textbf{The full Weisshorn study}: \texttt{configs/weisshorn.yaml} (seven profiles $\times$ five fineness
ratios, all plots, the report's LaTeX tables).
\item \textbf{Another rocket}: copy \texttt{configs/example\_new\_rocket.yaml}, fill in the parameters of
Table~\ref{tab:keyparams}, then \texttt{validate} and \texttt{run}. Without a trusted reference apogee, set
\key{flight.calibrate: false} ($k = 1$): apogees are less accurate, comparisons between noses still hold. The CFD
database is non-dimensional, so it holds for any diameter.
\item \textbf{New CFD cases}: either \key{aerodynamics.compute\_missing: true} (missing profiles are solved before
the sweep), or list them in \key{cfd.studies}, run \texttt{cfd CONFIG} then \texttt{rebuild-database CONFIG}. One
geometry with four Mach numbers takes 5--10 minutes per CPU core.
\end{itemize}
