Landonowins/weisshorn-nose-cone/docs/user_guide/sections/08_appendix.tex

\section{Verification Record}
\label{app:verification}

The package was refactored from the scripts that produced the Weisshorn design report (\texttt{legacy/scripts/})
and checked against them: the sweep table, $k$, the sensitivities, the LaTeX tables and macros, the CFD database
and the profile CSV are byte-identical; the whole CFD database recomputes bit for bit (38 geometries, 126 Mach
points); 15 of 16 figures are pixel-identical. The few differences are intentional (full-precision $k$ instead of 4
decimals, a closed ogive STL, a corrected table label) and change no rounded number of the report.

\section{Troubleshooting}

\begin{itemize}[leftmargin=*,itemsep=2pt]
\item \textbf{``skipped \dots: no CFD data for profile \dots''}: use a profile of the database, or set
\key{aerodynamics.compute\_missing: true}.
\item \textbf{``calibration failed: the target apogee \dots is not reached''}: check masses, thrust and impulse, widen
\key{flight.calibration\_bracket}, or set \key{flight.calibrate: false}.
\item \textbf{A plot is skipped or ``failed''}: \texttt{run.log} says why (missing data, or LaTeX: set
\key{output.text\_renderer: mathtext}). A failed plot never stops the run.
\item \textbf{The figures look different from the report}: LaTeX is not installed, so the built-in renderer is used;
the content is the same.
\item \textbf{Results changed after updating Python packages}: differences of order $10^{-12}$ are expected; install
the pinned versions of \texttt{requirements.txt} for exact reproduction.
\item \textbf{The CFD solver ``diverged''}: it restarts with a lower CFL (\key{cfd.fallback\_cfl}); if it persists,
try a finer grid level or a smaller \key{cfd.cfl}.
\end{itemize}
