Landonowins/weisshorn-nose-cone/docs/user_guide/figures/sweep_fig_cdw.pdf

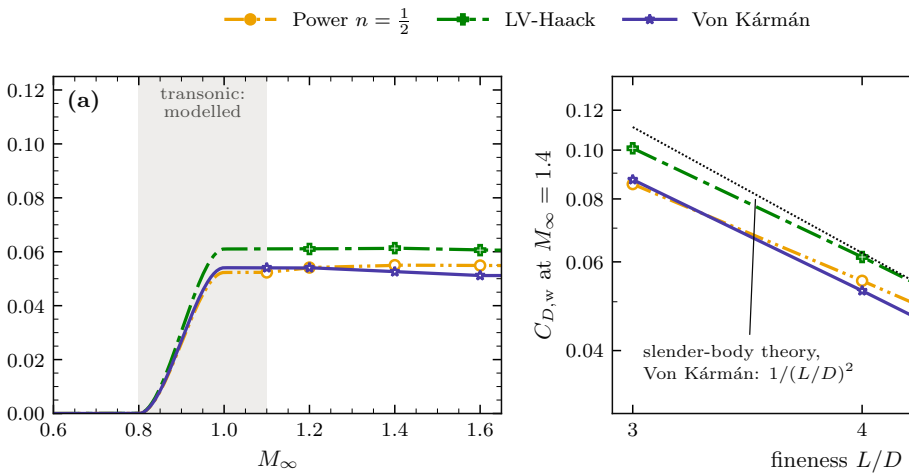
[picture p90: figure]
transonic: modelled (a); 4 fineness L/D; slender-body theory, Von K´arm´an: 1; Power; LV-Haack; Von K´arm´an
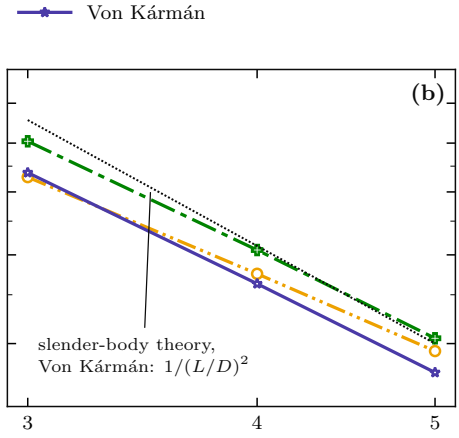
[picture p91: figure]

nose wave drag CD,w (L/D = 4)
