Landonowins/weisshorn-nose-cone/docs/user_guide/figures/fig_renders.png

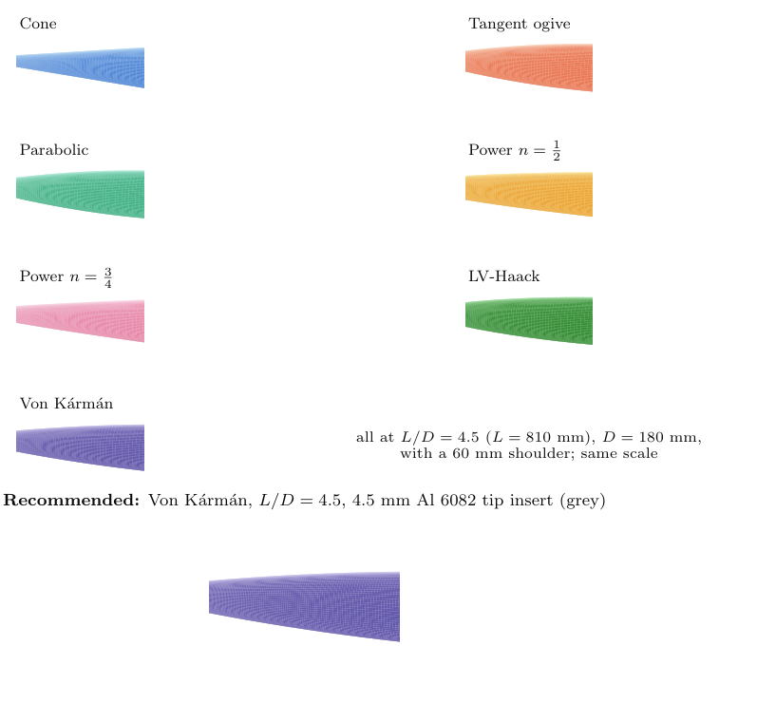
docs/user_guide/figures/fig_renders.png
