Landonowins/weisshorn-nose-cone/report/_backup_before_explanations/sections/05_results.tex

\section{Results}
\label{sec:results}

\subsection{Nose wave drag}

Figure~\ref{fig:cdw}a gives the wave drag of the seven profiles at $L/D=4$ and
Figure~\ref{fig:cp} the wall pressure behind it.
\begin{itemize}[leftmargin=*,itemsep=2pt]
\item \textbf{Von K\'arm\'an and power $n=\tfrac12$ are the two low-drag profiles}, within a few
per cent of each other: Von K\'arm\'an is lower at $M \geq 1.3$, power $\tfrac12$ is lower at
$M \leq 1.2$. They get there differently. The tangent profiles (Von K\'arm\'an, ogive, parabolic)
expand continuously, and their wall pressure falls below ambient over the aft third. This
partly cancels the overpressure near the tip. The power-$\tfrac12$ nose concentrates its
overpressure in a short spike at its blunt tip and stays just above ambient behind it.
\item \textbf{Ogive, parabolic and LV-Haack} carry 13--22\,\% more wave drag: their fuller
forebody turns the flow harder near the tip.
\item \textbf{The cone is the worst} at every Mach number, and its drag rises steeply towards
Mach 1. Its surface pressure is the conical-flow value all the way to the shoulder.
\item \textbf{Fineness.} $C_{D,\rm w}$ falls as $1/(L/D)^2$ for every profile, the slope of
slender-body theory (Figure~\ref{fig:cdw}b). For Von K\'arm\'an the Euler level is about
15\,\% below the linear-theory value $1/(L/D)^2$.
\end{itemize}

\begin{figure}[H]
\centering

\caption{(a) Nose wave drag versus Mach number at $L/D=4$ (markers: Euler; lines: model used in
the trajectory; grey band: transonic model). (b) Wave drag versus fineness at $M=1.4$, with the
slender-body result for the Von K\'arm\'an nose.}
\label{fig:cdw}
\end{figure}

\begin{figure}[H]
\centering

\caption{Wall pressure coefficient along the nose ($L/D = 4$) at (a) $M=1.1$ (only the shapes
computed at that Mach number) and (b) $M=1.4$. The tangent profiles reach $C_p<0$ over the aft
third; the power-$\tfrac12$ nose keeps a small overpressure up to the shoulder after a spike at
its blunt tip; the cone keeps the conical value.}
\label{fig:cp}
\end{figure}

\subsection{Flight performance}

Figure~\ref{fig:trajectory}a shows the nominal and envelope ascents. Weisshorn burns out at
\SI{9.1}{s} near \SI{2.2}{km} at $M_{\max}=1.47$ (nominal) or 1.56 (envelope). It spends \SI{16}{s} above $M = 0.8$ and
\SI{10}{s} above Mach 1. Figure~\ref{fig:trajectory}b shows where the drag impulse
$\int D\,\mathrm dt$ is spent: mostly between $M = 0.8$ and 1.5, which is exactly where the
nose wave drag acts. The apogee sensitivities around the baseline are
\textbf{\SI{-100}{m} per $\Delta C_D = 0.01$} and \textbf{\SI{-143}{m/kg}}.

\begin{figure}[H]
\centering

\caption{(a) Mach number along the nominal and hot-day envelope ascents (grey band: transonic
range). (b) Share of the drag impulse per Mach bin for the baseline nose; the dark part is the
nose wave drag.}
\label{fig:trajectory}
\end{figure}

Figure~\ref{fig:breakdown} breaks the vehicle drag down by component for the recommended nose.
Skin friction dominates at all speeds (Weisshorn is a fineness-30 airframe). Base drag is the
second contributor, and the nose wave drag appears above $M = 0.8$, where it is 10--12\,\% of the
total. This is why the nose shape moves the apogee by tens of metres rather than kilometres, and
why the length (wetted area) and the shape effects are of the same order.

\begin{figure}[H]
\centering

\caption{Drag build-up of Weisshorn with the recommended nose (coasting, $z = \SI{3}{km}$, rest of
the vehicle scaled by the calibration factor $k$). The kink at $M\approx0.25$ is where the skin
friction becomes roughness-limited; the one at $M=1$ is the switch of the base-drag law.}
\label{fig:breakdown}
\end{figure}

\subsection{Trade study}
\label{sec:trade}

Figure~\ref{fig:trade} gives, for every profile and fineness, the apogee change relative to the
baseline, the length over which a 3U section fits, and the change in static margin.
Table~\ref{tab:trade} lists the candidates closest to the LVS length.

\begin{figure}[H]
\centering

\caption{(a) Apogee change relative to the baseline (Von K\'arm\'an, $L/D=4$, cross), including
the extra length, wetted area and mass of longer noses. (b) Length of the curved nose with
$r\geq\SI{77}{mm}$ (3U fit). (c) Change in subsonic static margin.}
\label{fig:trade}
\end{figure}

\input{sections/tab_trade}

\begin{itemize}[leftmargin=*,itemsep=2pt]
\item \textbf{Von K\'arm\'an, power $\tfrac12$ and power $\tfrac34$ lead at every length} and swap
places within about \SI{30}{m}. Power $\tfrac12$ is ahead at $L/D\leq3.5$, Von K\'arm\'an at
$L/D = 4$--4.5, and the power-$\tfrac34$ estimate (scaled from $L/D=4$) at $L/D=5$. At $L/D=4$,
Von K\'arm\'an beats the tangent ogive (Bella Lui II / Nordend) by \TRADEOGIVE{} and the Firehorn
power-$\tfrac12$ by \TRADEPOWER{}.
\item \textbf{Length pays, with diminishing returns}: \TRADELEN{} per extra \SI{90}{mm}
($\Delta L/D = 0.5$) around $L/D = 4$--4.5.
\item \textbf{Fuller noses house more payload}: at $L/D=4$ the ogive and LV-Haack fit
\SIrange{275}{284}{mm} of the 3U inside the curved part, against \SI{226}{mm} for Von K\'arm\'an. Measured
as nose-bay length (curved part + the cylinder still needed for the 3U), the Von K\'arm\'an
nose still gives the highest apogee per millimetre of bay length.
\item \textbf{Stability is not a discriminator}: all candidates change the static margin by
less than 0.1 cal.
\end{itemize}

\subsection{Check at the design fineness}
\label{sec:check45}

The trade study interpolates the Euler results between $L/D = 3$, 4 and 5 (on $C_{D,\rm w}(L/D)^2$,
which is nearly constant for slender noses). To check this, every shape was also computed directly
at $L/D = 4.5$ (Table~\ref{tab:check45}). Where three fineness ratios were available the
interpolation is within 0.3\,\%. The parabolic and power-$\tfrac34$ noses, first computed at
$L/D = 4$ only, were underestimated by 2--4\,\%. The direct values are now used everywhere, which
moves the power-$\tfrac34$ nose from $+55$ to $+42$\,m at $L/D = 4.5$.

\input{sections/tab_check45}

\subsection{Robustness of the ranking}
\label{sec:robust}

The weakest parts of the chain are the transonic drag model, the drag of the rest of the vehicle and
the mass model. Figure~\ref{fig:robustness} recomputes the apogee of every shape at $L/D = 4.5$
under six perturbations of these assumptions and shows it relative to Von K\'arm\'an in the same
scenario:
\begin{itemize}[leftmargin=*,itemsep=2pt]
\item \textbf{Von K\'arm\'an flies highest in every scenario.} The power noses stay within
\SI{31}{m} of it (\SIrange{11}{31}{m}). The ogive, parabolic and LV-Haack noses are
\SIrange{57}{98}{m} lower, and the cone \SIrange{98}{156}{m} lower.
\item The spread between scenarios is smaller than the gap between the groups, so the selection
does not hinge on the transonic assumption. The largest effect is the hot-day envelope with the LVO
masses, which raises the Mach number and amplifies the differences.
\item A draggier vehicle (+20\,\% on the rest of the drag) shrinks the differences: the nose
matters less when it is a smaller share of the total.
\end{itemize}

\begin{figure}[H]
\centering

\caption{Apogee of each design at $L/D = 4.5$ relative to Von K\'arm\'an, under the nominal model
and six perturbed ones. The grey band is $\pm\SI{30}{m}$, about $\pm\SI{0.2}{kg}$ of dry mass.}
\label{fig:robustness}
\end{figure}

\subsection{Tip bluntness}

A sharp tip cannot be laid up and burns or chips first, so the tip is a separate machined
part. Figure~\ref{fig:bluntness}a gives the drag cost of a spherical tip on the Von K\'arm\'an
nose. At $M=1.4$ a \SI{4.5}{mm} tip ($r_n/R=0.05$) costs \BLUNTCOST{} (\BLUNTAPOA{} of apogee), and
a \SI{9}{mm} tip ($r_n/R=0.1$) costs \BLUNTTEN{} (\BLUNTAPOB{}). The cost grows quickly with radius because the
sphere replaces the slender front of the Haack profile.
Figure~\ref{fig:bluntness}b gives the benefit: the stagnation-point heat-transfer coefficient
falls as $r_n^{-1/2}$.

\begin{figure}[H]
\centering

\caption{(a) Wave drag of the blunted Von K\'arm\'an nose relative to the sharp one.
(b) Stagnation-point heat-transfer coefficient at $M_{\max}$ versus tip radius (dotted line: the
selected \SI{4.5}{mm}).}
\label{fig:bluntness}
\end{figure}

\subsection{Heating}
\label{sec:heating}

Figure~\ref{fig:thermal} gives the temperature histories. The peak stagnation temperature is
\SI{119}{\celsius} (nominal) and \SI{156}{\celsius} (envelope), reached at burn-out.
\begin{itemize}[leftmargin=*,itemsep=2pt]
\item \textbf{Tip.} A 3D-printed PET-CF tip (Firehorn) has a low conductivity, so its surface
follows $T_0$ and reaches \PETNOM{} (nominal) and \PETENV{} (envelope). That is
well above the \SIrange{70}{80}{\celsius} heat-deflection range of PET/PETG-CF. A
\SI{60}{g} Al 6082-T6 tip spreads the heat and stays below \TIPALNOM{} (nominal) and \TIPAL{} (envelope).
\item \textbf{Shell.} The \SI{1.2}{mm} CFRP shell follows the recovery temperature within a few
seconds. Its inner face peaks at \SHELLNOM{} (nominal) and \SHELLENV{} (envelope), about
\SI{3}{s} after burn-out, then cools. This is below the cure temperature of the prepreg, but the
envelope case comes close to the DP490 coupler bond (shear strength \SI{2.8}{MPa} at
\SI{120}{\celsius}). The Firehorn thermal requirement (\SI{390}{K} for \SI{5}{s}) does not
cover the envelope; Section~\ref{sec:next} proposes \SI{430}{K} for \SI{10}{s}.
\end{itemize}

\begin{figure}[H]
\centering

\caption{(a) Inner-face temperature of the CFRP shell at three stations (adiabatic inner face,
conservative). (b) Tip temperature: printed PET-CF surface against a machined Al 6082 insert.
Solid: nominal ascent; dashed: hot-day envelope; black: stagnation temperature $T_0$.}
\label{fig:thermal}
\end{figure}
