Landonowins/weisshorn-nose-cone/tests/reference/robustness.csv

scenario | shape | apogee | dz_vs_vk
nominal | cone | 8927.825570767878 | -132.08477060742734
nominal | ogive | 8980.784065990938 | -79.12627538436755
nominal | parabolic | 8982.06804421109 | -77.84229716421578
nominal | power050 | 9037.361695176605 | -22.548646198700226
nominal | power075 | 9041.288172371025 | -18.622169004280295
nominal | lvhaack | 8990.983507332197 | -68.9268340431081
nominal | vonkarman | 9059.910341375306 | 0.0
drag rise from M = 0.75 | cone | 8913.860780634606 | -137.35150067580616
drag rise from M = 0.75 | ogive | 8970.32039034991 | -80.89189096050177
drag rise from M = 0.75 | parabolic | 8971.627573907612 | -79.58470740280063
drag rise from M = 0.75 | power050 | 9028.410954629127 | -22.80132668128499
drag rise from M = 0.75 | power075 | 9031.061699219079 | -20.15058209133349
drag rise from M = 0.75 | lvhaack | 8981.196333022595 | -70.01594828781708
drag rise from M = 0.75 | vonkarman | 9051.212281310412 | 0.0
drag rise from M = 0.85 | cone | 8942.768604217146 | -126.46607162697183
drag rise from M = 0.85 | ogive | 8991.99609813471 | -77.23857770940776
drag rise from M = 0.85 | parabolic | 8993.277662969293 | -75.95701287482552
drag rise from M = 0.85 | power050 | 9046.925220849036 | -22.30945499508198
drag rise from M = 0.85 | power075 | 9052.234782168416 | -16.99989367570197
drag rise from M = 0.85 | lvhaack | 9001.501990949208 | -67.73268489491056
drag rise from M = 0.85 | vonkarman | 9069.234675844118 | 0.0
transonic peak +20 % | cone | 8900.431286829864 | -141.9971645280075
transonic peak +20 % | ogive | 8959.983461582438 | -82.44498977543299
transonic peak +20 % | parabolic | 8961.302138893065 | -81.12631246480669
transonic peak +20 % | power050 | 9019.434065431155 | -22.99438592671686
transonic peak +20 % | power075 | 9020.879092586005 | -21.549358771866537
transonic peak +20 % | lvhaack | 8971.434232649535 | -70.99421870833612
transonic peak +20 % | vonkarman | 9042.428451357871 | 0.0
transonic peak -20 % | cone | 8955.571117509246 | -121.95324795778652
transonic peak -20 % | ogive | 9001.809283162404 | -75.7150823046286
transonic peak -20 % | parabolic | 9003.055005674125 | -74.4693597929072
transonic peak -20 % | power050 | 9055.413888840647 | -22.110476626385207
transonic peak -20 % | power075 | 9061.881707504012 | -15.64265796302061
transonic peak -20 % | lvhaack | 9010.732018302 | -66.79234716503197
transonic peak -20 % | vonkarman | 9077.524365467032 | 0.0
rest of vehicle drag +20 % | cone | 8298.835519282955 | -98.48028075067486
rest of vehicle drag +20 % | ogive | 8333.34031476055 | -63.97548527308027
rest of vehicle drag +20 % | parabolic | 8334.466090847829 | -62.84970918580075
rest of vehicle drag +20 % | power050 | 8379.217473176532 | -18.098326857098073
rest of vehicle drag +20 % | power075 | 8386.125915722987 | -11.18988431064281
rest of vehicle drag +20 % | lvhaack | 8339.967427237598 | -57.34837279603198
rest of vehicle drag +20 % | vonkarman | 8397.31580003363 | 0.0
LVO masses, 30 C day | cone | 9464.388736049807 | -156.44199154569105
LVO masses, 30 C day | ogive | 9523.193870648774 | -97.63685694672313
LVO masses, 30 C day | parabolic | 9524.80628385642 | -96.02444373907747
LVO masses, 30 C day | power050 | 9590.040096862444 | -30.79063073305406
LVO masses, 30 C day | power075 | 9601.559085384668 | -19.27164221082967
LVO masses, 30 C day | lvhaack | 9534.68470690162 | -86.14602069387729
LVO masses, 30 C day | vonkarman | 9620.830727595498 | 0.0
