Landonowins/weisshorn-nose-cone/data/euler_results.csv

study | shape | fineness | rn | grid | mach | cd
blunt | vonkarman | 4.0 | 0.05 | medium | 1.2 | 0.05422295968367484
blunt | vonkarman | 4.0 | 0.05 | medium | 1.4 | 0.05287576315124729
blunt | vonkarman | 4.0 | 0.05 | medium | 1.6 | 0.0516132205783033
blunt | vonkarman | 4.0 | 0.1 | medium | 1.2 | 0.05491758174266409
blunt | vonkarman | 4.0 | 0.1 | medium | 1.4 | 0.0545264730917392
blunt | vonkarman | 4.0 | 0.1 | medium | 1.6 | 0.053915295274073405
blunt | vonkarman | 4.0 | 0.2 | medium | 1.2 | 0.06023462644611374
blunt | vonkarman | 4.0 | 0.2 | medium | 1.4 | 0.06447958398888454
blunt | vonkarman | 4.0 | 0.2 | medium | 1.6 | 0.0667780360686138
cones | cone | 1.3737 | 0.0 | medium | 1.2 | 0.4669227131576852
cones | cone | 1.3737 | 0.0 | medium | 1.4 | 0.41247695762908243
cones | cone | 1.3737 | 0.0 | medium | 1.6 | 0.3681821942354543
cones | cone | 1.3737 | 0.0 | medium | 2.0 | 0.325311578159007
cones | cone | 1.866 | 0.0 | medium | 1.2 | 0.3070653324024466
cones | cone | 1.866 | 0.0 | medium | 1.4 | 0.25409963431146987
cones | cone | 1.866 | 0.0 | medium | 1.6 | 0.22932737813895807
cones | cone | 1.866 | 0.0 | medium | 2.0 | 0.20223327895930798
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
