Landonowins/weisshorn-nose-cone/tests/reference/nose_profile_final.csv

x_mm | r_mm
0.0 | 0.0
0.003 | 0.17
0.03 | 0.515
0.108 | 0.98
0.269 | 1.534
0.544 | 2.145
0.96 | 2.778
1.535 | 3.385
2.277 | 3.913
3.179 | 4.302
4.18 | 4.624
5.245 | 4.958
6.373 | 5.303
7.561 | 5.659
8.807 | 6.024
10.11 | 6.398
11.469 | 6.779
12.881 | 7.168
14.346 | 7.564
15.862 | 7.967
17.429 | 8.376
19.045 | 8.79
20.71 | 9.21
22.422 | 9.634
24.182 | 10.064
25.987 | 10.498
27.838 | 10.937
29.733 | 11.38
31.673 | 11.826
33.655 | 12.277
35.681 | 12.731
37.749 | 13.189
39.858 | 13.65
42.008 | 14.114
44.2 | 14.581
46.431 | 15.051
48.702 | 15.524
51.012 | 16.0
53.361 | 16.478
55.749 | 16.959
58.174 | 17.442
60.637 | 17.928
63.138 | 18.415
65.675 | 18.905
68.249 | 19.397
70.859 | 19.892
73.505 | 20.388
76.187 | 20.885
78.904 | 21.385
81.656 | 21.887
84.443 | 22.39
87.264 | 22.894
90.119 | 23.401
93.008 | 23.909
95.931 | 24.418
98.888 | 24.928
101.877 | 25.44
104.899 | 25.954
107.955 | 26.468
111.042 | 26.984
114.162 | 27.5
117.314 | 28.018
120.497 | 28.537
123.713 | 29.057
126.959 | 29.578
130.237 | 30.1
133.546 | 30.622
136.886 | 31.146
140.257 | 31.67
143.658 | 32.195
147.089 | 32.721
150.55 | 33.247
154.041 | 33.774
157.563 | 34.301
161.113 | 34.829
164.694 | 35.358
168.303 | 35.887
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
