Landonowins/weisshorn-nose-cone/tests/reference/trade_table.csv

shape | fineness | L_mm | V_L | S_m2 | mass_g | base_angle | xcp_over_L | l3U_mm | bay_mm | cd_w_11 | cd_w_12 | cd_w_14 | cd_w_16 | apogee | mach_max | dSM_cal | d_apogee | d_bay_mm
cone | 3.0 | 540.0 | 4.580442641316886 | 0.1547874528376008 | 211.69170378084877 | 9.462322198474403 | 0.6666666264680019 | 78.00000000000001 | 812.5 | 0.1618401905980688 | 0.1389400551793819 | 0.1193240628798336 | 0.1085853478839982 | 8471.724112712995 | 1.4464044582913969 | 0.15612391545631138 | -528.2813053855389 | -32.36741375258316
cone | 3.5 | 630.0 | 5.343849748203033 | 0.17993675899541378 | 236.3380238155055 | 8.13010235062203 | 0.6666666264680019 | 90.99999999999997 | 889.5000000000001 | 0.12358191710788638 | 0.10732736357438832 | 0.09279727440307481 | 0.08465865770918198 | 8668.651099397533 | 1.4567155871671895 | 0.13373520077377238 | -331.354318701 | 44.63258624741695
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
