Landonowins/weisshorn-nose-cone/legacy/results/euler_sweep.csv

study | shape | fineness | rn | grid | mach | cd | iters | converged | seconds
main | cone | 5 | 0.0 | medium | 1.6 | 0.047822666134007576 | 1500 | 1 | 96.2
main | cone | 5 | 0.0 | medium | 1.4 | 0.05210462760854639 | 2250 | 1 | 171.5
main | cone | 5 | 0.0 | medium | 1.3 | 0.05513254812540643 | 3000 | 1 | 278.6
main | cone | 5 | 0.0 | medium | 1.2 | 0.0594098456353432 | 4000 | 1 | 363.3
main | cone | 5 | 0.0 | medium | 1.1 | 0.0669146750696745 | 7250 | 1 | 658.4
main | cone | 6 | 0.0 | medium | 1.6 | 0.03556434103498873 | 1500 | 1 | 99.6
main | cone | 6 | 0.0 | medium | 1.4 | 0.03862853547347892 | 2250 | 1 | 178.7
main | cone | 6 | 0.0 | medium | 1.3 | 0.0407759801813855 | 2750 | 1 | 278.4
main | cone | 6 | 0.0 | medium | 1.2 | 0.043781480890078064 | 4000 | 1 | 381.4
main | cone | 6 | 0.0 | medium | 1.1 | 0.048953978469420824 | 7000 | 1 | 657.8
main | cone | 4 | 0.0 | medium | 1.6 | 0.06855431143243601 | 1500 | 1 | 95.5
main | cone | 4 | 0.0 | medium | 1.4 | 0.07497604105980196 | 2500 | 1 | 185.6
main | cone | 4 | 0.0 | medium | 1.3 | 0.07958224092213217 | 3000 | 1 | 289.0
main | cone | 4 | 0.0 | medium | 1.2 | 0.08619124443487984 | 4000 | 1 | 363.9
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
