Landonowins/weisshorn-nose-cone/tests/reference/figures/fig_fields_M14.png

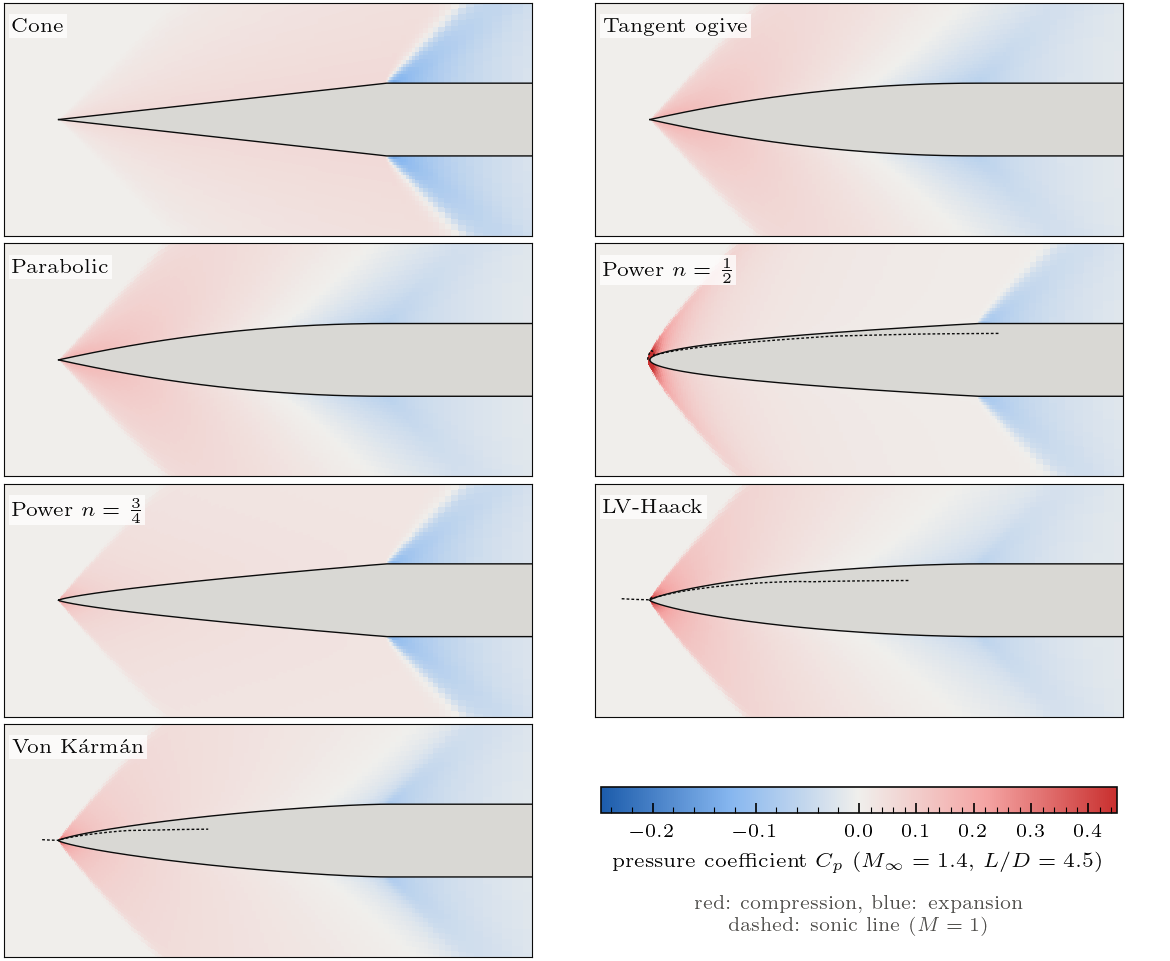
tests/reference/figures/fig_fields_M14.png
