Landonowins/weisshorn-nose-cone/tests/reference/figures/fig_profiles.png

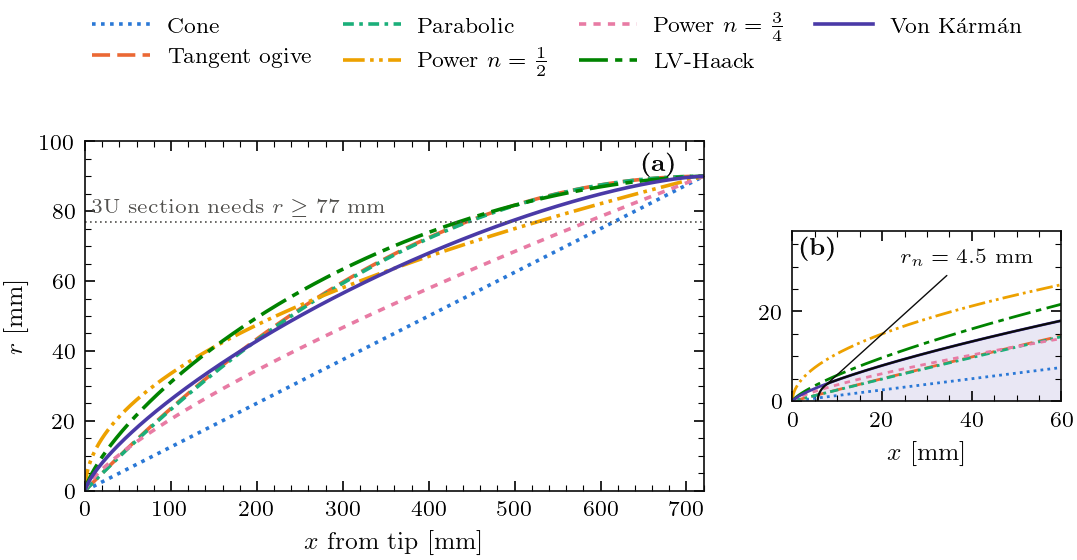
tests/reference/figures/fig_profiles.png
