Landonowins/weisshorn-nose-cone/tests/reference/figures/fig_thermal.png

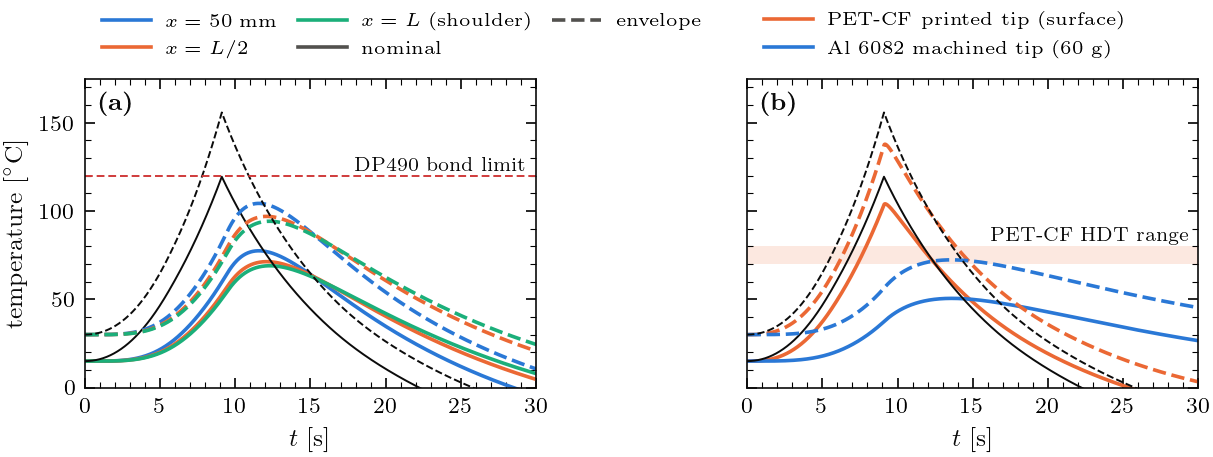
tests/reference/figures/fig_thermal.png
