Landonowins/weisshorn-nose-cone/tests/reference/figures/fig_trajectory.png

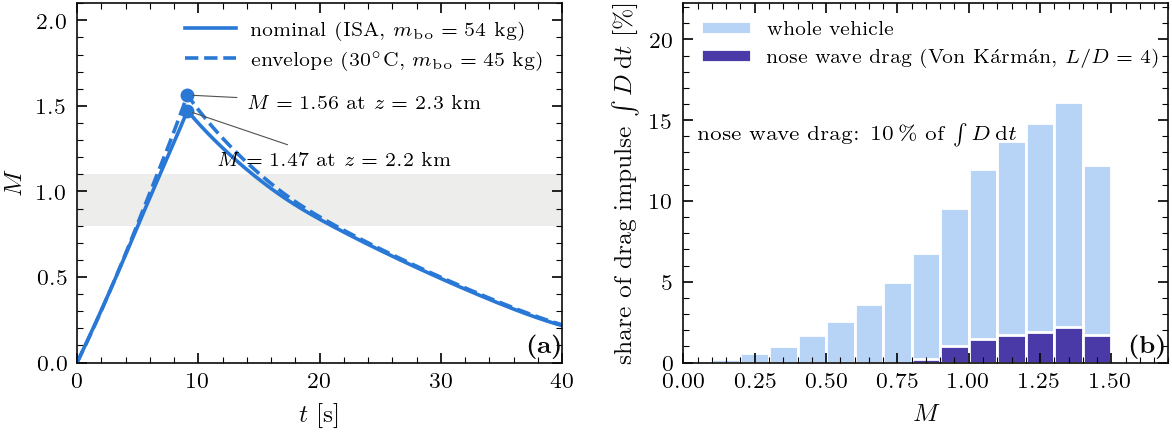
tests/reference/figures/fig_trajectory.png
