Landonowins/weisshorn-nose-cone/report_650/figures/fig_tl_coupler.pdf

### Curved length L = 650 − c [mm]

### Curved length L = 650 − c [mm]

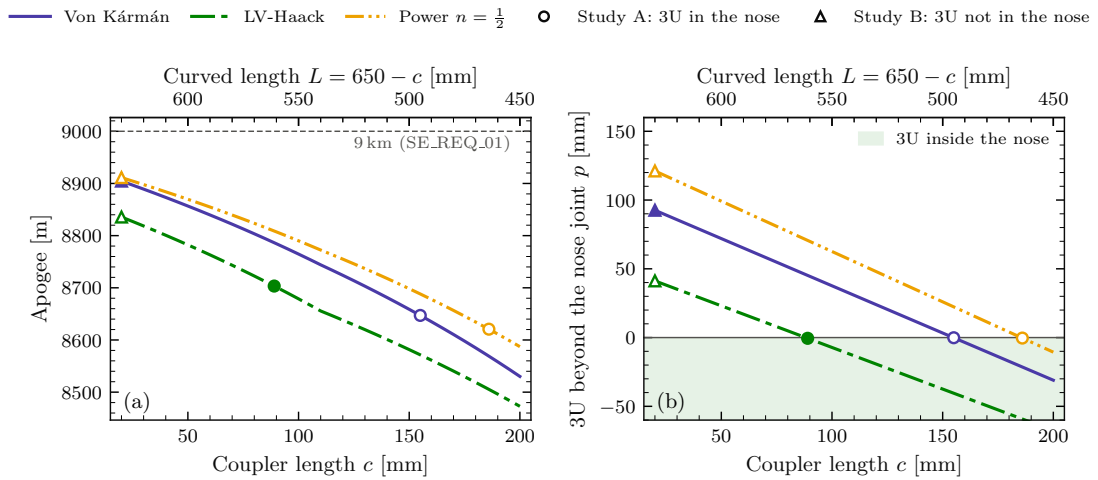
[picture p100: page 1]
Coupler length c [mm]; Apogee [m]; Von K´arm´an; LV-Haack; Power n = 1; Study A: 3U in the nose; Study B: 3U not in the nose

9 km (SE REQ 01)

3U inside the nose

3U beyond the nose joint

Coupler length c [mm]
