Landonowins/weisshorn-nose-cone/report_650/figures/fig_tl_designs.pdf

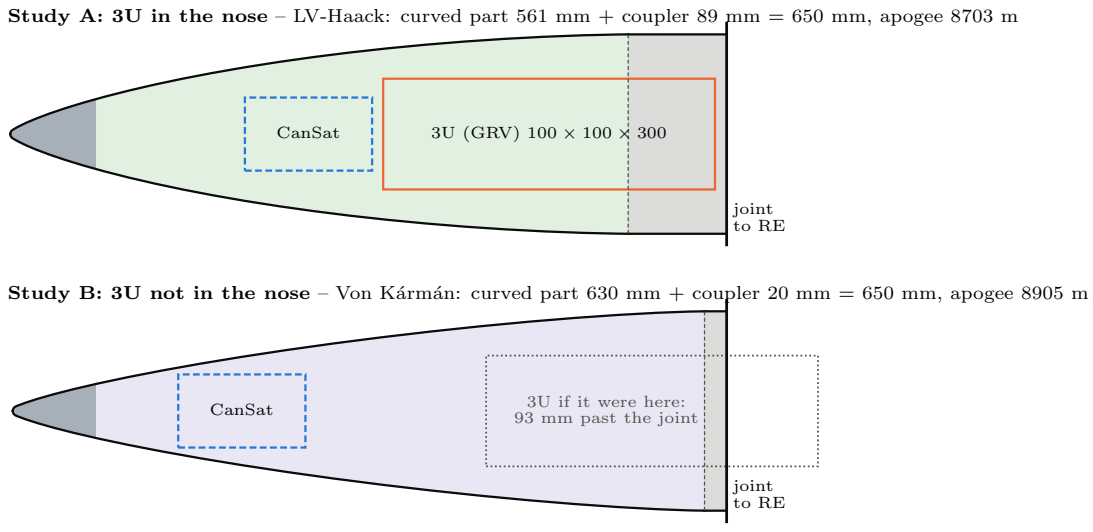
[picture p101: page 1]
joint to RE; CanSat; 3U (GRV) 100 × 100 × 300

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

93 mm past the joint CanSat

3U if it were here:
