Landonowins/weisshorn-nose-cone/report/figures/fig_bluntness.pdf

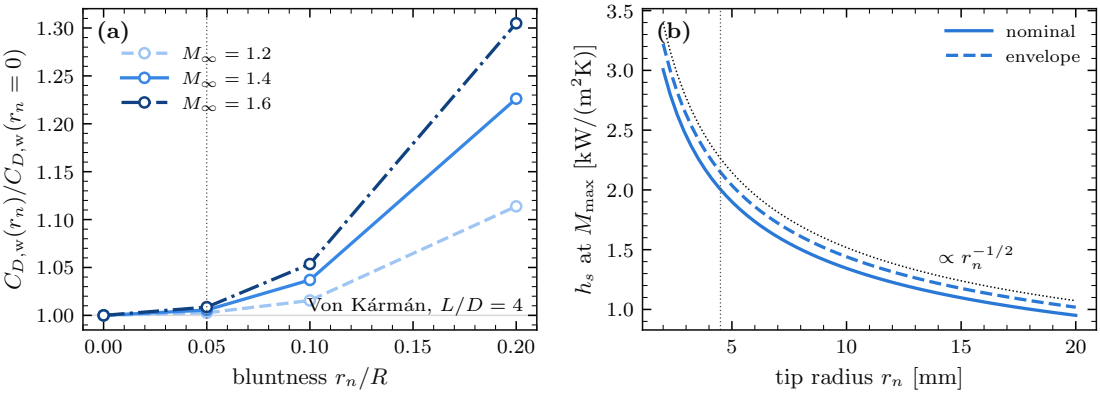
[picture p102: page 1]
bluntness; tip radius; (b) nominal; envelope

hs at Mmax [kW/(m2K)]

Von K´arm´an, L/D = 4
