Landonowins/weisshorn-nose-cone/report/figures/fig_breakdown.pdf

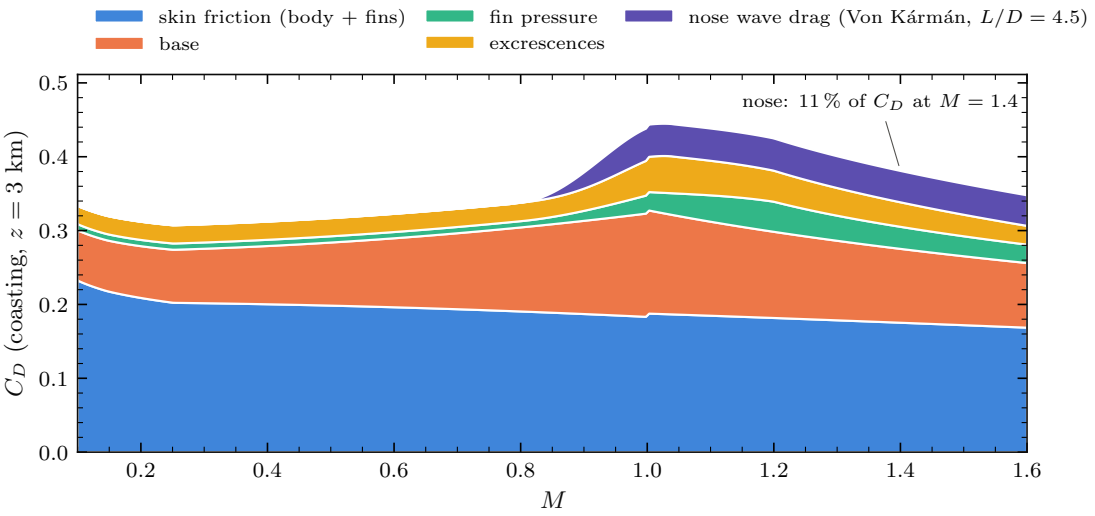
[picture p103: page 1]
D (coasting, z = 3 km); fin pressure excrescences

skin friction (body + fins)
base

nose wave drag (Von K´arm´an, L/D = 4.5)

nose: 11 % of CD at M = 1.4
