Landonowins/weisshorn-nose-cone/report/figures/fig_cdw.pdf

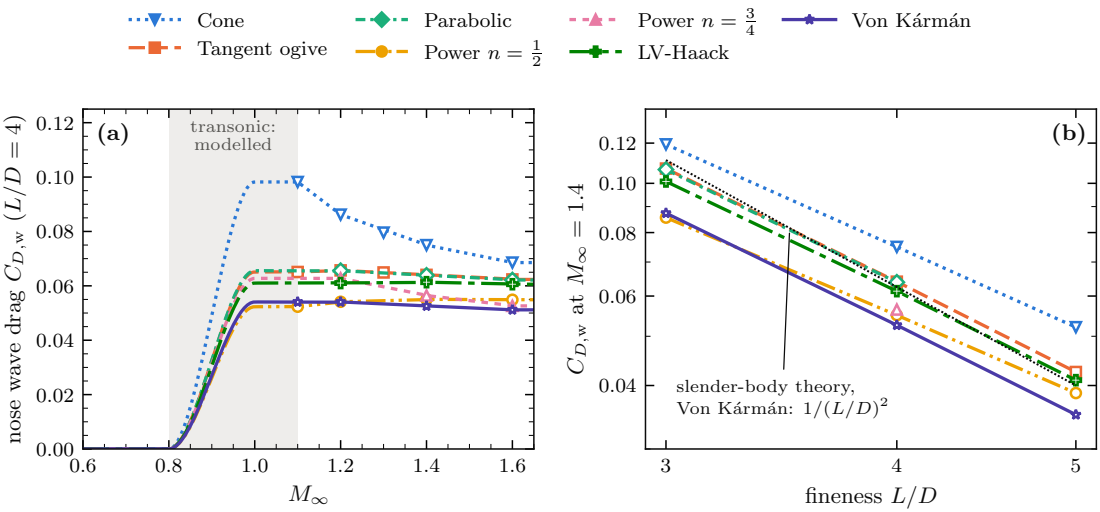
[picture p104: page 1]
transonic: modelled (a); fineness L/D; Cone Tangent ogive; Parabolic; Power; LV-Haack

Von K´arm´an

nose wave drag CD,w (L/D = 4)

slender-body theory,
Von K´arm´an: 1
