Landonowins/weisshorn-nose-cone/report/figures/fig_cp.pdf

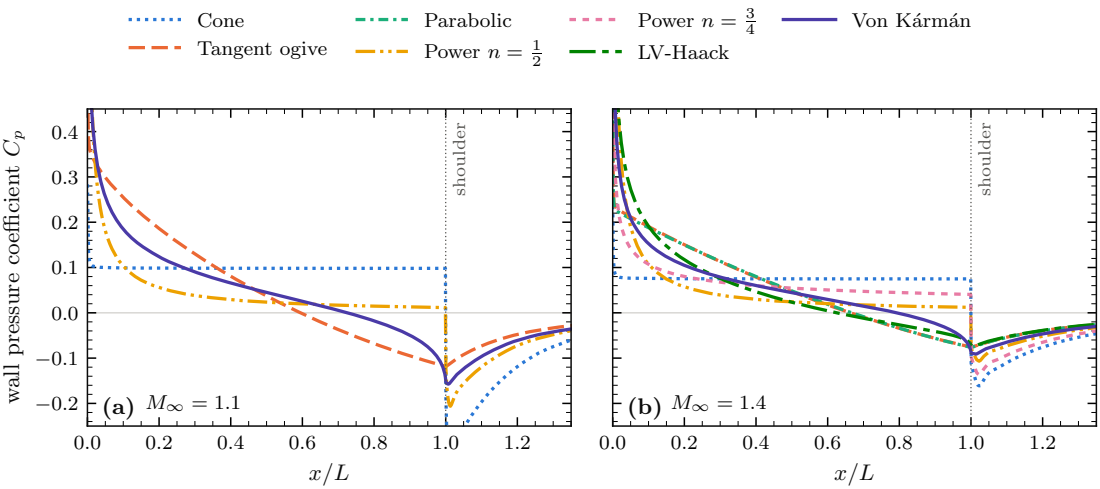
[picture p105: page 1]
shoulder; Cone Tangent ogive; Parabolic; Power; LV-Haack

Von K´arm´an

wall pressure coefficient Cp
