Landonowins/weisshorn-nose-cone/report/figures/fig_fields_M14.pdf

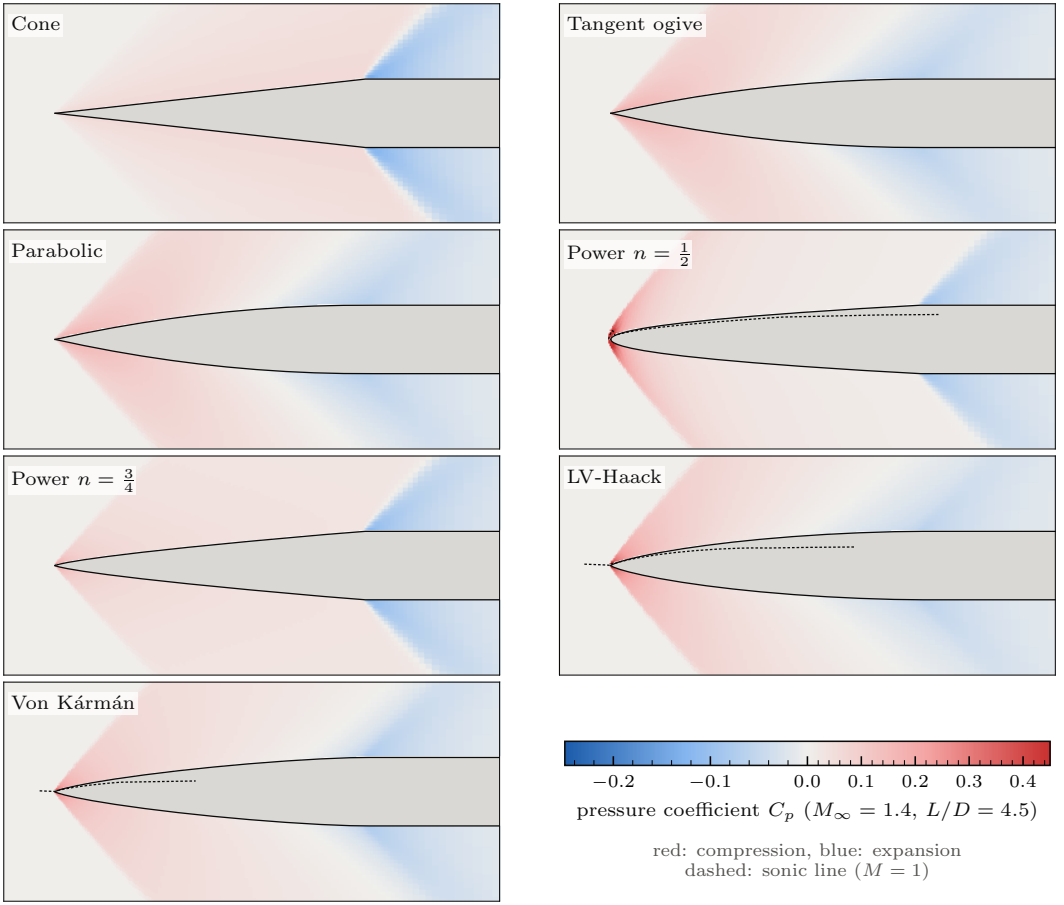
[picture p106: page 1]
Cone; Tangent ogive; Parabolic; Power n = 1; Power n = 3 4; LV-Haack

Von K´arm´an

pressure coefficient Cp (M∞ = 1.4, L/D = 4.5)

red: compression, blue: expansion
dashed: sonic line (M = 1)
