Landonowins/weisshorn-nose-cone/report/figures/fig_final.pdf

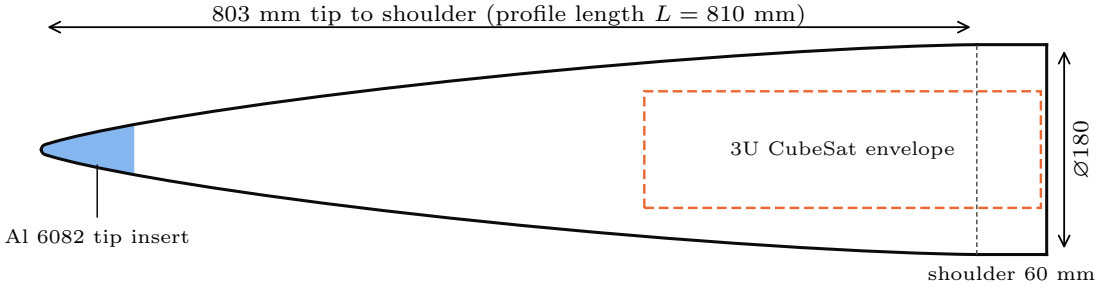
[picture p107: page 1]
3U CubeSat envelope; shoulder 60 mm

803 mm tip to shoulder (profile length L = 810 mm)

Al 6082 tip insert
