Landonowins/weisshorn-nose-cone/report/figures/fig_grid.pdf

(a)

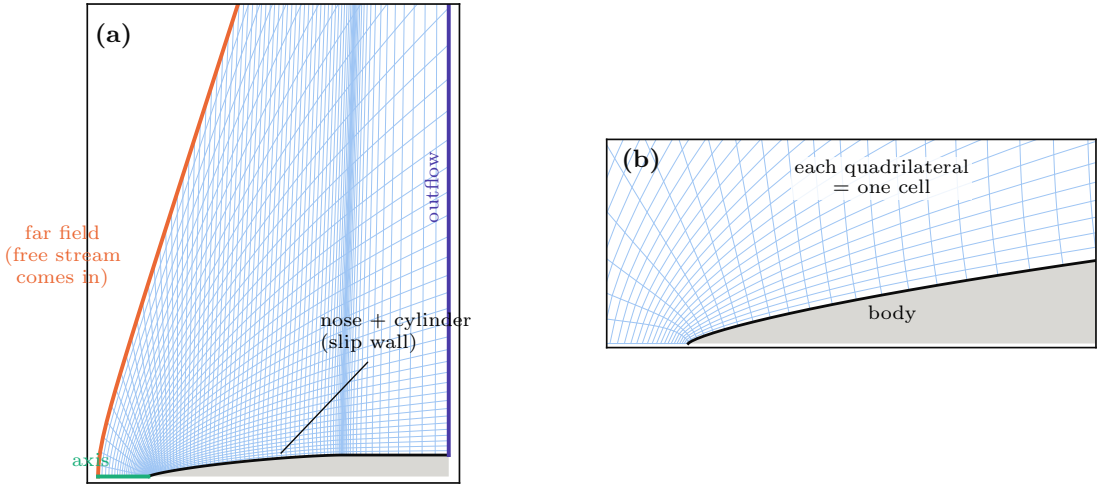
[picture p108: page 1]
far field (free stream comes in); axis; outflow; nose +; cylinder; (slip wall); body; each quadrilateral = one cell
