Landonowins/weisshorn-nose-cone/report/figures/fig_profiles.pdf

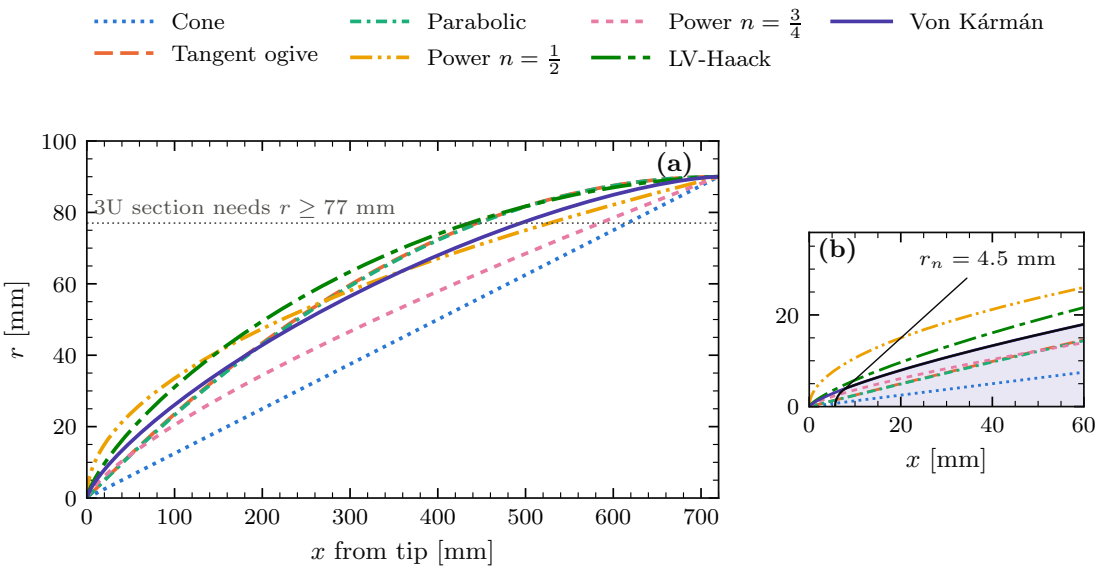
[picture p109: page 1]
Cone Tangent ogive; Parabolic Power n = 1 2; Power n = 3 4; LV-Haack

Von K´arm´an

3U section needs r ≥ 77 mm

x from tip [mm]
