Landonowins/weisshorn-nose-cone/report/figures/fig_robustness.pdf

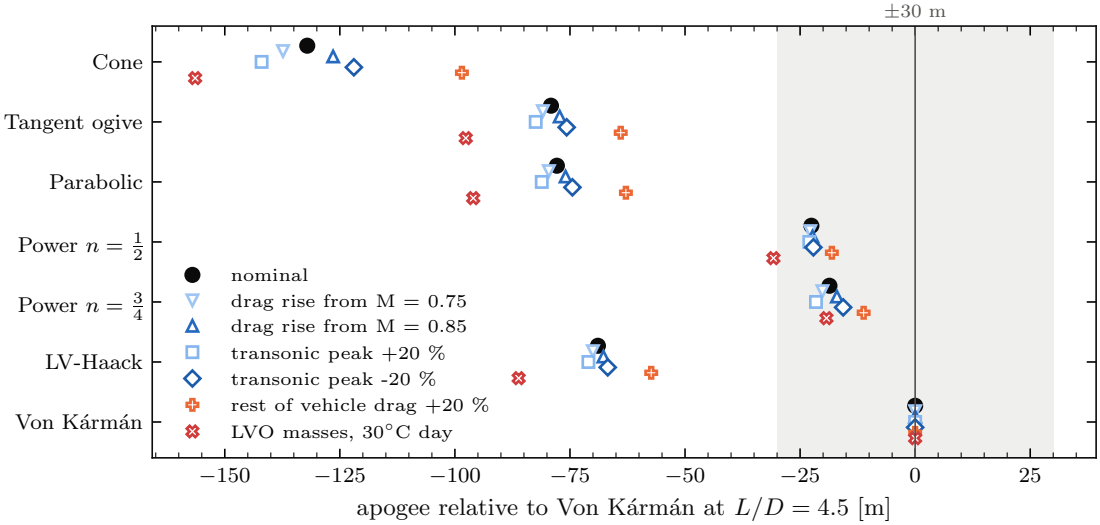
[picture p110: page 1]
Cone; Tangent ogive; Parabolic; Power n = 1 2; Power n = 3 4; LV-Haack

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

Von K´arm´an

apogee relative to Von K´arm´an at L/D = 4.5 [m]
