Landonowins/weisshorn-nose-cone/report/figures/fig_thermal.pdf

(a)

(b)

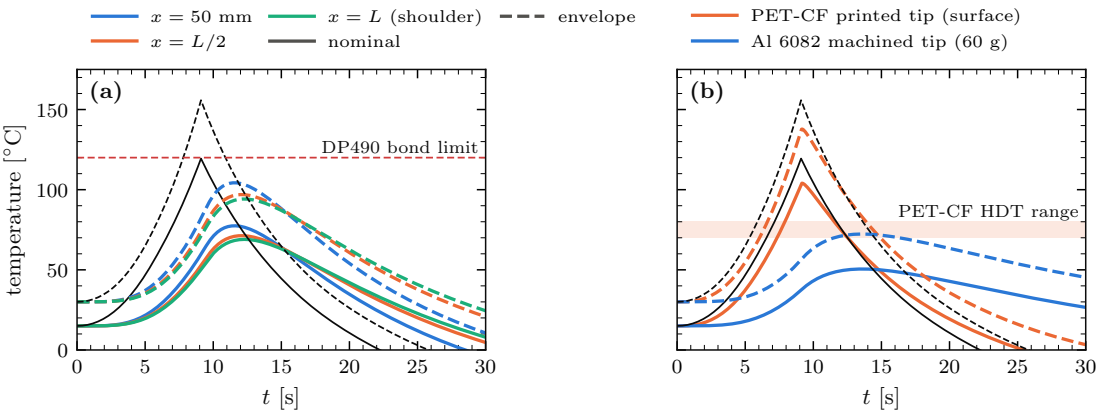
[picture p111: page 1]
temperature [; DP490 bond limit; x = L (shoulder) nominal; envelope

PET-CF printed tip (surface)
Al 6082 machined tip (60 g)

PET-CF HDT range
