Landonowins/weisshorn-nose-cone/report/figures/fig_trade.pdf

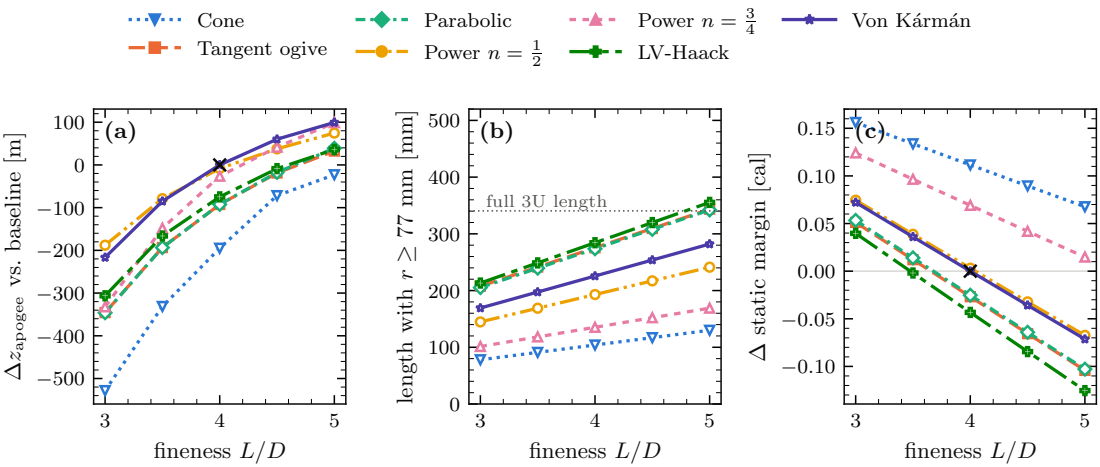
[picture p112: page 1]
fineness L/D; length with r ≥ 77 mm [mm]; full 3U length; Cone Tangent ogive; Parabolic; Power; LV-Haack

Von K´arm´an

∆zapogee vs. baseline [m]

∆ static margin [cal]
