Landonowins/weisshorn-nose-cone/docs/user_guide/figures/fig_cp.pdf

shoulder; Cone Tangent ogive; Parabolic; Power; LV-Haack

Von K´arm´an

wall pressure coefficient Cp
