Landonowins/weisshorn-nose-cone/docs/user_guide/figures/sweep_fig_trade.pdf

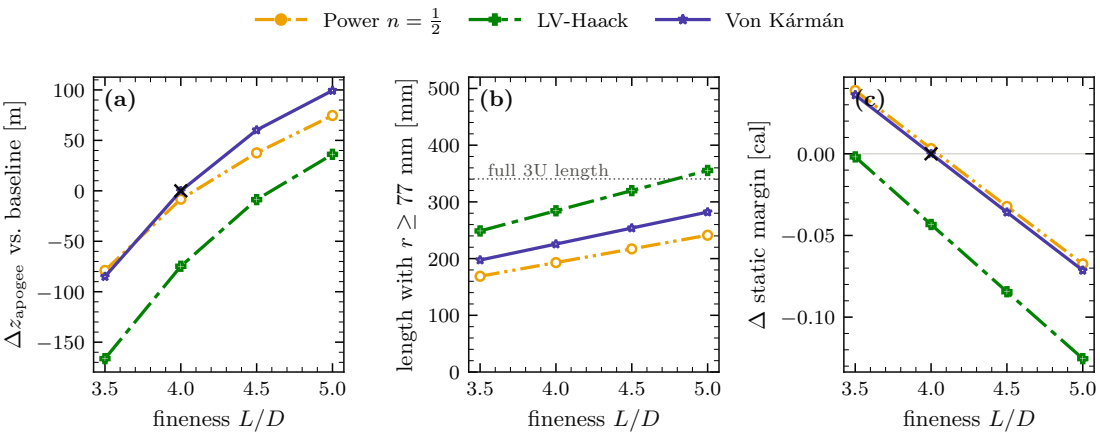
[picture p113: page 1]
fineness L/D; ∆zapogee vs. baseline [m]; length with r ≥ 77 mm [mm]; full 3U length; Power; LV-Haack; Von K´arm´an

∆ static margin [cal]
