Landonowins/weisshorn-nose-cone/legacy/figures/fig_renders.pdf

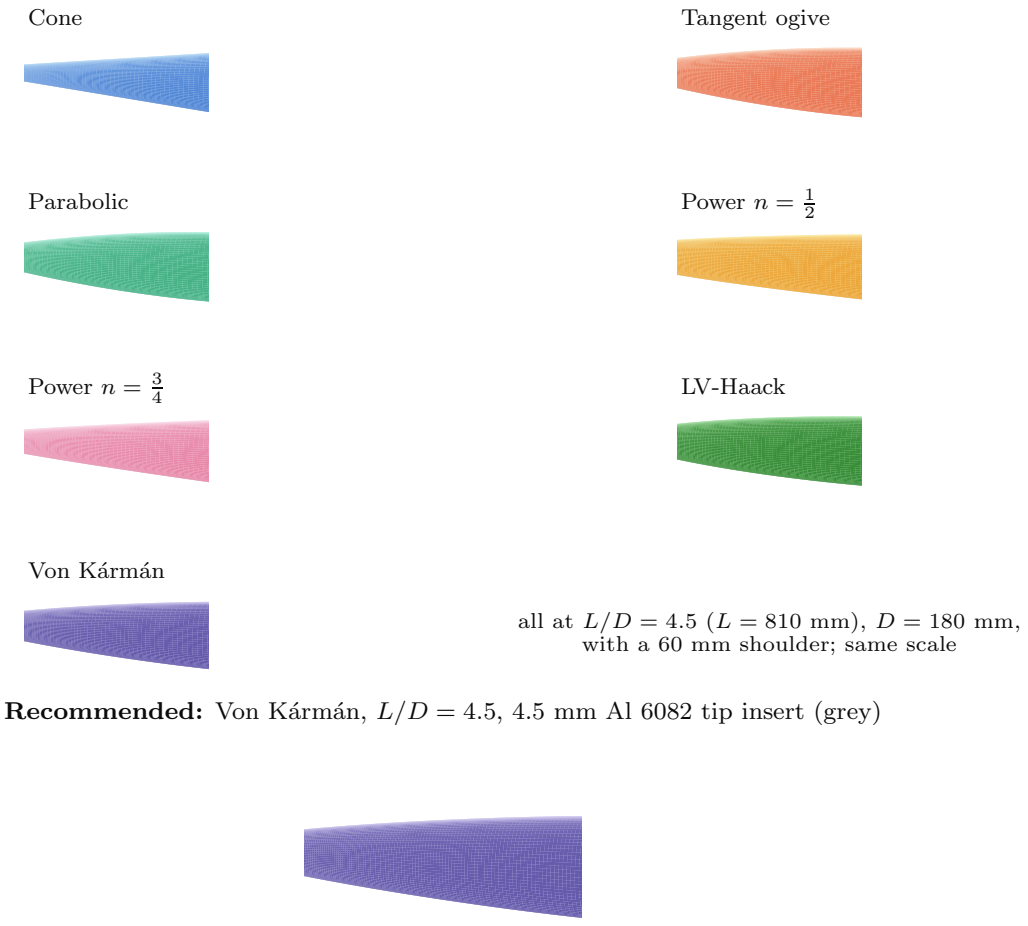
[picture p114: page 1]
Cone; Tangent ogive; Parabolic; Power n = 1; Power n = 3 4; LV-Haack

Von K´arm´an

all at L/D = 4.5 (L = 810 mm), D = 180 mm,
with a 60 mm shoulder; same scale

Recommended: Von K´arm´an, L/D = 4.5, 4.5 mm Al 6082 tip insert (grey)
