Landonowins/weisshorn-nose-cone/(commit log)

2026-10-11 Parametric nose-cone design tool (nosecone) for ERT, with Weisshorn data
    - nosecone package: geometry (profile families, plugin registry), axisymmetric
    Euler solver and CFD studies, wave-drag model, flight, stability, heating,
    design study (sweep, sensitivities, robustness, bluntness, decision matrix),
    CAD export (CSV, STL, STEP via gmsh), plotting, reporting, single CLI entry
    point (python -m nosecone)
    - all inputs in one validated YAML file (configs/weisshorn.yaml reproduces the
    design report; worked examples for a single design, a sweep, another rocket
    and a plugin)
    - data: CFD database, wall-pressure and flow-field files, solver run log
    - docs/user_guide: user guide (LaTeX +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
    [euler_results.csv, euler_sweep_log.csv, nose_profile_final.csv, robustness.csv, trade_table.csv]
2026-10-11 Remove heritage from the decision matrix
    Heritage (flown or built at ERT) is no longer a design criterion. The
    matrix scores performance, integration, manufacture and stability with
    relative weights 4:2:2:1 (normalised to 0.44/0.22/0.22/0.11).
    - nosecone: drop trade_matrix.heritage; weights are relative and
    normalised (matrix_weights); validate non-negative weights
    - configs/weisshorn.yaml: new weights, no heritage scores
    - legacy make_tables.py and the design report updated the same way;
    report text, catalogue verdicts, R10 and the alternatives row no
    longer rely on heritage or tooling reuse
    - user guide: trade_matrix parameters, step list, verification note
    - tests/reference: regene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
    [weisshorn.yaml]
2026-10-14 Condense the design report from 43 to 28 pages
    Same results, numbers and recommendations, less repetition:
    - per-profile datasheets of the catalogue reduced to one verdict each
    - Inputs, Options, Method and Results prose tightened; grid, drag-breakdown
    and profile figures and the L/D = 4.5 check table replaced by a sentence
    - nomenclature trimmed, abbreviations as one paragraph; TOC on one page
    - appendix points to this repository instead of the old script list
    - summary: nine numbered recommendations (R10 was removed earlier);
    STEP solid listed with the CAD deliverables
2026-10-14 Move the remaining nose-cone workspace files into the repository
    Files of the old Documents/EPFL Rocket Team/Nose Cone workspace that
    were not already here: run logs, euler_sweep.csv, grid_debug.png, the
    older ogive STL and test renders (legacy/results), fig_renders.pdf
    (legacy/figures), and the pre-explanation copy of the report
    (report/_backup_before_explanations).
    [euler_sweep.csv, nose_ogive_LD4.5.stl]
2026-10-21 Add the 650 mm nose cone study (report 2)
    The ST requirements cap the nose at 650 mm, curved part plus coupler.
    studies/total_length.py (with configs/weisshorn_650.yaml) sizes the
    coupler for Von Karman, LV-Haack and power 1/2 with the 3U in the nose
    (study A) and outside it (study B), and sweeps the allowed total length
    for the interface meeting. 24 new Euler points (study f650, L/D 2.5 and
    3.5) replace the extrapolation below L/D 3.
    Results: A = LV-Haack 561 + 89 mm, 8703 m; B = Von Karman 630 + 20 mm,
    8905 m. Report in report_650/ (FD scope only), STEP/CSV of the six
    design points in CFD/geometry_650/ for Fluent.
    [euler_results.csv, euler_sweep_log.csv, nose_lvhaack_L561_c89_rn4.5mm.csv, nose_lvhaack_L561_c89_rn4.5mm.step, nose_lvhaack_L630_c20_rn4.5mm.csv, nose_lvhaack_L630_c20_rn4.5mm.step, nose_power050_L464_c186_rn4.5mm.csv, nose_power050_L464_c186_rn4.5mm.step]
2026-10-21 Trim report 1 to the Flight Dynamics scope
    Remove what belongs to Structure: heating (method, results, thermal and
    bluntness figures, heat-transfer nomenclature), the manufacturing plan,
    the mass budget, materials and the RF window, and the tip-material,
    layup and thermal recommendations. The recommendations are now R1-R6
    (Fluent verification = R3); the Fluent workflow note follows and now
    points to Section 9 for the next steps. Results are unchanged.
2026-10-26 Add the 2D axisymmetric Fluent domains for studies A and B
    make_domain_2d.py cuts the nose half-section (same spline as the 3D STEP) out of a 20 D far
    field, 10 D behind the coupler, with one edge per named selection.
    [domain2d_nose_lvhaack_L561_c89_rn4.5mm.step, domain2d_nose_vonkarman_L630_c20_rn4.5mm.step]
2026-10-27 Add Fluent study A of the LV-Haack design nose at M 0.95, 1.2 and 1.47
    2D axisymmetric k-omega SST runs in Fluent 2024 R2 of the report-2 design
    (LV-Haack, L = 561 mm, 89 mm coupler) on the nominal trajectory. C_D on
    wall_nose: 0.0291 (M 0.95), 0.1172 (M 1.2), 0.1170 (M 1.47); the pressure
    parts agree within 4 % with the f650 Euler runs interpolated to L/D 3.117.
    M 0.95 uses the pressure-based coupled solver, since the density-based one
    did not converge there.
    CFD/studyA holds the write-up (README.md and studyA_log.html), the C_D
    histories, the Fluent plots and freestream_bc.py, which recomputes every
    boundary value and C_D. The 2D domain goes to CFD/geometry_650. The Fluent
    case and data f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
    [M0.95_density-based_not-converged.csv, M0.95_pressure-based.csv, M1.20_density-based.csv, M1.47_density-based.csv]
2026-10-27 Add the REPORT-4 study A figures and the wall_nose surface data
    Seven PNGs for the Fluent workflow report in CFD/source/figures, all 2400 px wide
    on white: the STEP solid and the 2D fluid domain (SpaceClaim 2024 R2 renders), the
    named selections (drawn from the Fluent zone nodes, not a Meshing screenshot) and
    four mesh views from Fluent (full domain, nose, 20 mm tip, 5 mm inflation at the
    shoulder).
    CFD/studyA/wall_data holds Cp, Cf, y+, pressure and wall shear on the 639
    wall_nose faces at M 0.95, 1.20 and 1.47. Integrating them returns Fluent's
    pressure and viscous Cd to 4 decimals.
    [wall_nose_M0.95.csv, wall_nose_M1.20.csv, wall_nose_M1.47.csv]
2026-10-27 Rewrite REPORT-4 as the Fluent workflow of study A
    The Fluent workflow note (2027_C_FD_REPORT-4_NOSE-CONE-FLUENT-WORKFLOW) now
    records the study A runs step by step: geometry, mesh and mesh quality,
    models and boundary conditions, solver settings for the supersonic and
    transonic runs, running the cases, results, and one section comparing the
    nose drag with the Python results of report 2. The source is split into
    CFD/source/main.tex and sections/; the result plots are the native Fluent
    pictures exported on the DLL PC.
    CFD/studyA/report_figures.py draws the two plots Fluent cannot make (C_D
    against Mach across the runs, and the Python comparison) and checks the
    exported wall_nose data against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
    [wall_nose_M0.95.csv, wall_nose_M1.20.csv, wall_nose_M1.47.csv]
2026-10-27 Trim the text of report 1 without touching its figures and tables
    Background, method and input prose is cut to the formulas and key numbers;
    results, catalogue, selection and recommendations keep every finding and
    number with shorter wording. The next-steps item points to the REPORT-4
    Fluent workflow. 25 to 22 pages; carries the 2027 REPORT-1 Doc ID.
2026-11-13 Register Ansys's ansys-fluent-mcp next to server.py on the DLL VM
    bootstrap-vm.ps1 now also installs ansys-fluent-mcp 0.8 when the Python is 3.12+ and registers
    it in .mcp.json as "fluent-official" (python -m ansys.fluent.mcp, session logs in
    CFD/runs/official-logs), so both servers can be compared on the same case. On the Ansys
    Python 3.10 only server.py is set up, as before.
    PyFluent stays pinned below 0.44: 0.44.0 needs ansys-units 0.16 while ansys-fluent-mcp 0.8.0
    pins 0.15, and it drops Python 3.10 and 3.11. It does not drop Fluent 2024 R2, contrary to
    the old comment. Tested on 2026-11-13 in a fresh Python 3.13 venv: PyFluent 0.43.0, mcp 2.3.0,
    ansys-fluent-mcp 0.8.0, fastmcp 4.2.0, p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
